ut-ras/rm_electrical-supercap/Design/MC34063 DWS.xlsx

Sheet: STEP DOWN
Design Spreadsheet for the MC33063 device in step down topology |  |  |  |  |  |  |  |  |  |  |  |  | Rev 0.1 7/22/09
 |  |  |  |  |  | Select package, demoboard: |  |  | SOIC
 |  |  |  |  | Package |  | PDIP | SOIC | DFN | Custom
 |  |  |  |  | Rthja (°C/W) |  | 107 | 123 | 47 | 90 | Related to mentioned PCB
 |  |  |  |  | Tmax (°C) |  | 150 | 150 | 150 | 150
 |  |  |  |  | Pdmax (W) |  | 0.95 | 0.625 | 1.2 | 0.625
 |  |  |  |  |  |  |  |  |  |  |  | PCB one-layer, size: 28 x 41 mm,35um copper thickness, 840 sqmm copper area
 |  |  |  |  | RESULTS:
 |  |  |  |  | Ta max : | 97.88 | °C | <-- Maximum ambient temperature
 |  |  |  |  | Pd : | 0.42 | W | <-- Power Dissipation at the device
 |  |  |  |  | The maximum ambient temperature is related to one-layer PCB with parameters mentioned in the above
 |  |  |  |  | yellow table. The value of maximum ambient temperature is calculated for maximum allowable junction
 |  |  |  |  | temperature Tj = 150°C.
1) Insert Design Parameters
 | = Input Parameter
 | = Calculated Parameter (DO NOT CHANGE)
 | = Warning
 |  | Unit |  |  |  |  |  |  |  | Scroll Bars for fast Vin and Vout setting
VIN | 24 | V | <-- Worst Case Input Voltage (usually minimum Vin) |  |  | Input Voltage: 4V < Vin < 40V
VOUT | 5 | V | <-- Desired Output Voltage |  |  | Output Voltage: 1.25V < Vout < (Vin*Dmax)
IOUT | 0.8 | A | <-- Desired Output Current
D | 24.16 | % | <-- Duty Cycle. Maximum duty cycle of the MC33063 is 84%
2) Input Conduction Loss Parameters from Free-wheeling Diode Datasheets
 |  | Unit
VF | 0.6 | V | <-- Diode Forward Voltage (Example: 1N5819 = 0.6V)
VSAT | 1.42 | V | <-- Saturation Voltage of Power Switch Transistor
 |  |  |  | - Found in Electrical Characteristics of Datasheet,
 |  |  |  | Darlington Configuration
3) Set DIL/IL(avg)
For Maximum Output Current it is suggested that ΔIL should be chosen to be less than 10% of the average inductor current, IL(avg).
This will help prevent Ipk (sw) from reaching the current limit threshold set by RSC. If the design goal is to use a minimum
inductance value, let ΔIL = 2*IL(avg). This will proportionally reduce output current capability.
 |  | Unit
DIL / IL(avg) | 36 | % | <-- DIL / IL(avg)
Iripple | 0.288 | A | <-- Ripple Current, DIL
4) Input target frequency
 |  | Unit
Target f | 80 | kHz | <-- Targeted maximum switching frequency
Timing capacitor | 120.8062957 | pF |  |  |  |  |  |  | NO
 |  |  |  |  |  |  |  |  | YES
5) The spreadsheet calculates key parameters for the remaining component selection
 |  | Unit
ton/toff | 0.32
ton | 3.02 | us
IL(avg) | 0.80 | A | <-- Average Inductor Current. For a buck converter this equals Iout
Ipk(sw) | 0.94 | A | <-- Peak Inductor Current. For a buck converter this equals Iout + Iripple/2
 |  | Unit
RSC | 317.7966102 | mOhm | <-- Minimum Short Circuit Resistor Value
L | 184.3302729 | uH | <-- Minimum inductance value |  | * increasing inductance decreases ripple current
RL | 0.708 | Ohm | <-- Inductor Widing Resistance (from Inductor data sheet or measurement).
toff | 9.48 | us
6) Efficiency / Power Loss
Pswitch, cond | 0.27 | W | <-- Conduction Loss in Power Switch
Psensing, res | 0.02 | W | <-- Conduction Loss in Sensing Resistor
Pdiode, cond | 0.36 | W | <-- Conduction Loss in Diode
Pind, winding | 0.45 | W | <-- Inductor Winding Losses
Pstatic, IC | 0.07 | W | <-- Static Power Loss in IC
Pswitch, sw | 0.08 | W | <-- Switching Losses of Power Switch
Pcore |  | W | <-- Core Loss in Inductor. Available in inductor data sheet. Leave blank if not available.
Ploss, total | 1.26 | W | <-- Total Loss
Pout | 4.00 | W | <-- Output Power
Pin | 5.26 | W | <-- Input Power = Output Power + Total Loss
Efficiency | 76.02358069 | % | <-- Efficiency of Converter (Est: +/- 5%)
Pd IC | 0.42 | W | <-- Power Dissipation

Sheet: STEP DOWN (2)
Design Spreadsheet for the MC33063 device in step down topology |  |  |  |  |  |  |  |  |  |  |  |  | Rev 0.1 7/22/09
 |  |  |  |  |  | Select package, demoboard: |  |  | SOIC
 |  |  |  |  | Package |  | PDIP | SOIC | DFN | Custom
 |  |  |  |  | Rthja (°C/W) |  | 107 | 123 | 47 | 90 | Related to mentioned PCB
 |  |  |  |  | Tmax (°C) |  | 150 | 150 | 150 | 150
 |  |  |  |  | Pdmax (W) |  | 0.95 | 0.625 | 1.2 | 0.625
 |  |  |  |  |  |  |  |  |  |  |  | PCB one-layer, size: 28 x 41 mm,35um copper thickness, 840 sqmm copper area
 |  |  |  |  | RESULTS:
 |  |  |  |  | Ta max : | 121.39 | °C | <-- Maximum ambient temperature
 |  |  |  |  | Pd : | 0.23 | W | <-- Power Dissipation at the device
 |  |  |  |  | The maximum ambient temperature is related to one-layer PCB with parameters mentioned in the above
 |  |  |  |  | yellow table. The value of maximum ambient temperature is calculated for maximum allowable junction
 |  |  |  |  | temperature Tj = 150°C.
1) Insert Design Parameters
 | = Input Parameter
 | = Calculated Parameter (DO NOT CHANGE)
 | = Warning
 |  | Unit |  |  |  |  |  |  |  | Scroll Bars for fast Vin and Vout setting
VIN | 24 | V | <-- Worst Case Input Voltage (usually minimum Vin) |  |  | Input Voltage: 4V < Vin < 40V
VOUT | 3.3 | V | <-- Desired Output Voltage |  |  | Output Voltage: 1.25V < Vout < (Vin*Dmax)
IOUT | 0.5 | A | <-- Desired Output Current
D | 16.77 | % | <-- Duty Cycle. Maximum duty cycle of the MC33063 is 84%
2) Input Conduction Loss Parameters from Free-wheeling Diode Datasheets
 |  | Unit
VF | 0.6 | V | <-- Diode Forward Voltage (Example: 1N5819 = 0.6V)
VSAT | 1.34 | V | <-- Saturation Voltage of Power Switch Transistor
 |  |  |  | - Found in Electrical Characteristics of Datasheet,
 |  |  |  | Darlington Configuration
3) Set DIL/IL(avg)
For Maximum Output Current it is suggested that ΔIL should be chosen to be less than 10% of the average inductor current, IL(avg).
This will help prevent Ipk (sw) from reaching the current limit threshold set by RSC. If the design goal is to use a minimum
inductance value, let ΔIL = 2*IL(avg). This will proportionally reduce output current capability.
 |  | Unit
DIL / IL(avg) | 36 | % | <-- DIL / IL(avg)
Iripple | 0.18 | A | <-- Ripple Current, DIL
4) Input target frequency
 |  | Unit
Target f | 80 | kHz | <-- Targeted maximum switching frequency
Timing capacitor | 83.84482258 | pF |  |  |  |  |  |  | NO
 |  |  |  |  |  |  |  |  | YES
5) The spreadsheet calculates key parameters for the remaining component selection
 |  | Unit
ton/toff | 0.20
ton | 2.10 | us
IL(avg) | 0.50 | A | <-- Average Inductor Current. For a buck converter this equals Iout
Ipk(sw) | 0.59 | A | <-- Peak Inductor Current. For a buck converter this equals Iout + Iripple/2
 |  | Unit
RSC | 508.4745763 | mOhm | <-- Minimum Short Circuit Resistor Value
L | 225.4173878 | uH | <-- Minimum inductance value |  | * increasing inductance decreases ripple current
RL | 0.708 | Ohm | <-- Inductor Widing Resistance (from Inductor data sheet or measurement).
toff | 10.40 | us
6) Efficiency / Power Loss
Pswitch, cond | 0.11 | W | <-- Conduction Loss in Power Switch
Psensing, res | 0.01 | W | <-- Conduction Loss in Sensing Resistor
Pdiode, cond | 0.25 | W | <-- Conduction Loss in Diode
Pind, winding | 0.18 | W | <-- Inductor Winding Losses
Pstatic, IC | 0.07 | W | <-- Static Power Loss in IC
Pswitch, sw | 0.05 | W | <-- Switching Losses of Power Switch
Pcore |  | W | <-- Core Loss in Inductor. Available in inductor data sheet. Leave blank if not available.
Ploss, total | 0.66 | W | <-- Total Loss
Pout | 1.65 | W | <-- Output Power
Pin | 2.31 | W | <-- Input Power = Output Power + Total Loss
Efficiency | 71.29167416 | % | <-- Efficiency of Converter (Est: +/- 5%)
Pd IC | 0.23 | W | <-- Power Dissipation

Sheet: STEP UP
Design Spreadsheet for the MC33063 device in step up topology:
 |  |  |  |  |  | Select package, demoboard: |  |  | SOIC
 |  |  |  |  | Package |  | PDIP | SOIC | DFN | Custom
 |  |  |  |  | Rthja (°C/W) |  | 107 | 123 | 47 | 90 | Related to mentioned PCB
 |  |  |  |  | Tmax (°C) |  | 150 | 150 | 150 | 150
 |  |  |  |  | Pdmax (W) |  | 0.95 | 0.625 | 1.2 | 0.625
 |  |  |  |  |  |  |  |  |  |  |  | PCB one-layer, size: 28 x 41 mm,35um copper thickness, 840 sqmm copper area
 |  |  |  |  | RESULTS:
 |  |  |  |  | Ta max : | 126.62 | °C | <-- Maximum ambient temperature
 |  |  |  |  | Pd : | 0.19 | W | <-- Power Dissipation at the device
 |  |  |  |  | The maximum ambient temperature is related to one-layer PCB with parameters mentioned below
 |  |  |  |  | yellow table. The value of maximum ambient temperature is calculated for maximum allowable junction
 |  |  |  |  | temperature Tj = 150°C.
1) Insert Design Parameters
 | = Input Parameter
 | = Calculated Parameter (DO NOT CHANGE)
 | = Warning
 |  | Unit |  |  |  |  |  |  | Scroll Bars for fast Vin and Vout setting:
VIN | 24 | V | <-- Worst Case Input Voltage (minimum Vin) |  |  | Input Voltage: 2.5V < Vin < 38V
VOUT | 30 | V | <-- Desired output voltage |  |  | Note: (Vin + 2) < Vout < 40V
IOUT | 0.3 | A | <-- Desired output current
D | 22.25969646% |  | <-- Duty Cycle. Maximum duty cycle of the MC30063 is 84%
2) Input Conduction Loss Parameters from Free-wheeling Diode Datasheets
 |  | Unit
VF | 0.6 | V | <-- Diode Forward Voltage (Example: 1N5819 = 0.6V)
VSAT | 0.9 | V | <-- Saturation Voltage of Power Switch Transistor
 |  |  |  | - Found in Electrical Characteristics of Datasheet,
 |  |  |  | Darlington Configuration
3) Set DIL/IL(avg)
For Maximum Output Current it is suggested that ΔIL should be chosen to be less than 10% of the average inductor current, IL(avg).
This will help prevent Ipk (sw) from reaching the current limit threshold set by RSC. If the design goal is to use a minimum
inductance value, let ΔIL = 2*IL(avg). This will proportionally reduce output current capability.
 |  | Unit
DIL / IL(avg) | 30 | % | <-- DIL / IL(avg)
Iripple | 0.12 | A | <-- Ripple Current, DIL
4) Input target frequency
 |  | Unit
Target f | 90 | kHz | <-- Targeted maximum switching frequency
Timing capacitor | 98.93198426 | pF | <-- Timing capacitor capacitance |  |  |  |  | NO
5) The spreadsheet calculates key parameters for the remaining component selection
 |  | Unit
ton/toff | 0.29
ton | 2.47 | us
IL(avg) | 0.39 | A | <-- Average Inductor Current.
Ipk(sw) | 0.44 | A | <-- Peak Inductor Current. For Boost Converter this equals IL(avg) + Iripple/2
 |  | Unit
RSC | 676.0026395 | mOhm | <-- Minimum Short Circuit Resistor Value
L | 493.7311248 | uH | <-- Minimum inductance value |  | - increasing inductance decreases ripple current
RL | 2.000 | Ohm | <-- Inductor Widing Resistance (from Inductor data sheet or measurement).
toff | 8.64 | us
6) Efficiency / Power Loss
Pswitch, cond | 0.08 | W | <-- Conduction Loss in Power Switch
Psensing, res | 0.10 | W | <-- Conduction Loss in Sensing Resistor
Pdiode, cond | 0.18 | W | <-- Conduction Loss in Diode
Pind, winding | 0.30 | W | <-- Inductor Winding Losses
Pstatic, IC | 0.07 | W | <-- Static Power Loss in IC
Pswitch, sw | 0.04 | W | <-- Switching Losses of Power Switch
Pcore |  | W | <-- Core Loss in Inductor. Available in inductor data sheet. Leave blank if not available.
Ploss, total | 0.77 | W | <-- Total Loss
Pout | 9.00 | W | <-- Output Power
Pin | 9.77 | W | <-- Input Power = Output Power + Total Loss
Efficiency | 92.13 | % | <-- Efficiency of Converter (Est: +/- 5%)
Pd IC | 0.19
