ut-ras/rm_electrical-supercap/Design/TPS4306x_BOOST_CALCTOOL_REVB.xlsx

Sheet: Intro
 |  | © 2012
TPS4306x Boost Design Calculator
TPS4306x Boost Design Calculator Tool - Rev. B
This tool supports the TPS4306x datasheet (SLVSBP4) (http://www.ti.com/lit/ds/symlink/tps43061.pdf)
This worksheet is designed for use with Microsoft Excel 2002 or later. It is intended to assist circuit designers in their
routine, day-to-day calculations. Additional worksheets may be added as they are completed.
The calculator includes boost power stage design in CCM using the TPS43061EVM-198 design requirements as the original input.
The calculator provides the small signal gain and phase for the final design. The small signal model currently supports CCM only.
Important: Analysis Toolpak is needed to run small signal worksheet. Go to Tools>Add-Ins> select Analysis Toolpak
All worksheets contain yellow user-input cells, blue calculated cells, and grey constants cells.
Leave the password blank to unlock the individual sheets or workbook.
 | Disclaimer:
 | This product is designed as an aid for customers of Texas Instruments. No warranties, either express
 | or implied, with respect to this software or its fitness for any particular purpose is made by Texas
 | Instruments or the author. The software is licensed solely on an "as is" basis. The entire risk as to its
 | quality and performance is with the user.
Revision notes
Rev. B
fixed typos in equations on the Boost Calculations tab in row 68, 69 and 74

Sheet: Boost Calculations
TPS4306x Boost Equation Set from Datasheet |  |  |  | Cell Color Key
Devices Supported |  | Select Device |  | User Input
TPS43060 |  | TPS43061 |  | Calculated
TPS43061 |  |  |  | Constants
DS Equation # | Design Specifications | Value | Units | Description/Comments
 | Vin nom | 4.56 | V | Nominal input voltage
 | Vin min | 4.4 | V | Minimum input voltage
 | Vin max | 6 | V | Maximum input voltage
 | Viripple | 0.0456 | V p-p | Input voltage ripple (1% Vin nom)
 | Vout | 24.0 | V | Output voltage
 | Vripple | 0.24 | V p-p | Output voltage ripple (1% Vout)
 | Iout | 3.750 | A | Maximum Average Output current
 | fsw | 750 | kHz | Switching frequency
 | dItran | 1.875 | A | Load transient output current change (50% Iout default)
 | dVtran | 0.96 | V | Load transient output voltage change (4% Vout default)
 | Vstart | 4.8 | V | Optional adjustable UVLO turn on voltage
 | Vstop | 4.5 | V | Optional adjustable UVLO turn off voltage
Schematic and Final Component List
Ref. Des. | EVM Ref. Des. | Values and Minimum Recommended Ratings
CI | C13-C15 (C16) | 220.0 µF | 6V | Irms = 1.064A
CC | C9 | 0.010 µF | 3.6V
CSS | C7 | 0.100 µF | 3.6V
CHF | C8 | 180 pF | 3.6V
CBOOT | C1 | 0.100 µF | 5.5V
CVCC | C6 | 5.600 µF | 5.5V
CO | C2-C5, C16 (C17) | 220.0 µF, 0.018Ω | 24V | Irms = 7.915A
DBOOT | D1 | n/a | 24V
L | L1 | 1.3 µH | Isat = 26.757A | Irms = 20.457A
QL | Q1 | BSC059N04LS6
QH | Q1 (Q2) | BSC059N04LS6
RSENSE | R16-R17 (R18) | 0.002 Ω | 3.502W
RUVLOH | R7 | 6.81 kΩ
RUVLOL | R5 | 2.26 kΩ
RC | R7 | 22.6 kΩ
RT | R5 | 76.8 kΩ
RSL | R8 | 11 kΩ
RSH | R9 | 205 kΩ
RPG | R1 | 100 kΩ
DS Equation # | Power Stage Design | Value |  |  | Units | Description/Comments
Duty Cycle
 | Dmax off time, Dmin on time | 81.25% | 7.5% |  |  | Estimated duty cycle limits based on minimum on time and off time (assumes 100% efficiency)
11 | Dnom | 81% |  |  |  | Duty cycle at nominal input voltage
11 | Dmax | 81.66666667% |  |  |  | Duty cycle at minimum input voltage
11 | Dmin | 75% |  |  |  | Duty cycle at maximum input voltage
12,13 | fsw max | 7500000 | 733333.3333 |  | Hz | Minimum and maximum switching frequency based on duty cycle estimations
14 | RT calc | 76666.66667 | 76800 |  | Ω | Calculated and nearest 1% STD value fsw set resistor
 | RT chosen | 76800 |  |  | Ω | Chosen fsw set resistor
Inductor Selection (L)
15 | Iin max | 20.45454545 |  |  | A | Maximum average input current (assumes 100% efficiency)
 | Kind | 0.3 |  |  |  | Inductor current ripple fraction (typical values 0.2 to 0.4)
 | Iripple target | 6.136363636 |  |  | A | Inductor current ripple target based on Kind and average current with minimum input voltage
17 | L min1 | 9.777777778e-07 |  |  | H | Minimum inductance calculated based on Iripple target (Vin_max)
17 | L min2 | 7.807736626e-07 |  |  | H | Minimum inductance calculated based on Iripple target (Vin_min)
16 | L min3 | n/a |  |  | H | Minimum inductance calculated based on Iripple target (50% duty cycle)
 | L chosen | 1.3e-06 |  |  | H | Selected inductance
 | DCR | 0.004 |  |  | Ω | DC resistance (DCR) of selected inductor
 | Iripple | 3.685 | 3.788 | 4.615 | A | Inductor ripple with selected inductance (Vin_min, Vin_nom, Vin_max)
48 | Icrit | 0.338 | 0.360 | 0.577 | A | Estimated critical output current to remain in CCM (Vin_min, Vin_nom, Vin_max)
 | Ipsm | 0.003 | 0.003 | 0.006 | A | Estimated output current when pulse skipping begins (Vin_min, Vin_nom, Vin_max)
18 | IL rms | 20.457 | 19.739 | 15.005 | A | Inductor RMS current (Vin_min)
19 | IL peak, Isat | 22.297 | 26.757 |  | A | Peak current and +20% for recommended minimum inductor saturation current rating
 | PL cond | 1.674 | 1.559 | 0.901 | W | Full load conduction losses in inductor (Vin_min, Vin_nom, Vin_max)
Sense Resistor (RSENSE)
20 | Vcs typ | 0.064 | 0.064 | 0.066 | V | Typical over-current current sense voltage based on Figure 19 in datasheet
 | Vcs min | 0.052 | 0.052 | 0.056 | V | Minimum over-current current sense voltage (10 mV below typical)
21 | Rsense max | 0.001951421336 |  |  | Ω | Maximum current sense resistor using Vcs min and 20% tolerance to account for efficiency and transients
 | Rsense chosen | 0.00192 |  |  | Ω | Selected sense resistor
22 | P Rsense | 3.502 |  |  | W | Minimum power rating for current sense resistor in normal operating conditions
 | Ilim min | 27.195 | 27.242 | 29.013 | A | Minimum current limit with selected sense resistor
 | Ilim typ | 33.460 | 33.538 | 34.221 | A | Typical current limit with selected sense resistor
 | Estimated Efficiency | 93% | 96% | 97% |  | Estimated Efficiency
 | Iout max | 4.322 | 4.623 | 6.476 | A | Maximum output current using minimum over-current sense voltage
 | Iout max | 5.391 | 5.772 | 7.739 | A | Maximum output current with typical over-current sense voltage
Output Capacitor (CO)
24 | Cout min ripple | 1.701388889e-05 |  |  | F | Minimum Cout for output voltage ripple specification
23 | Cout min transient | 4.721397211e-05 |  |  | F | Minimum Cout for load transient output voltage change specification (uses fco_target from compensation section)
 | Cout ESR max | 0.012 |  |  | Ω | Estimated maximum Cout ESR to meet ripple specification
 | Cout chosen | 0.00022 |  |  | F | Output capacitance selected (remember to include derating for ceramics)
 | ESR chosen | 0.018 |  |  | Ω | ESR selected (if mixed output capacitors are used, use equivalent ESR of the non ceramic capacitors)
 | Irms_cout | 7.915 |  |  | A | Output capacitors must be rated to handle RMS current (Vin_min)
Low-side Boost FET (QL)
 | Selected FET | BSC059N04LS6 |  |  |  | Input part number for selected low-side FET
 | Qg ls | 9.4e-09 |  |  | C | Gate charge of selected FET
 | Idrive | 0.007 |  |  | A | Average gate drive current required
 | Rdson ls | 0.0059 |  |  | Ω | Rdson of selected FET
26 | Pls cond | 2.000 |  |  | W | Estimated full load conduction losses in FET (Vin_min)
 | Vth | 1.8 |  |  | V | Threshold Voltage
 | Coss | 2.1e-10 |  |  | F | Output Capacitance
 | Qgd | 1.4e-09 |  |  | C | Gate to dran charge
 | Rg ls | 2.2 |  |  | Ω | Gate resistance of selected FET
27 | Pls sw | 0.199 |  |  | W | Estimated switching losses
 | Ptot ls | 2.199 |  |  | W | Estimated losses in low-side FET (Vin_min)
High-side Synchronous FET (QH, CBOOT)
 | Selected FET | BSC059N04LS6 |  |  |  | Input part number for selected high-side FET
 | Qg hs | 9.4e-09 |  |  | C | Gate charge of selected FET
 | Idrive | 0.007 |  |  | A | Average gate drive current required
30 | Cboot | 3.76e-08 | 3.3e-08 |  | F | Minimum bootstrap capacitor
 | Cboot | 1e-07 |  |  | F | Selected bootstrap capacitor
 | Rdson hs | 0.0059 |  |  | Ω | Rdson of selected FET
28 | Phs cond | 0.453 |  |  | W | Estimated max load conduction losses in FET (Vin_min)
 | Rg hs | 2.2 |  |  | Ω | Gate resistance of selected FET
 | Vf body | 0.92 |  |  | V | Forward voltage of body diode
29 | Phs dt | 1.835 |  |  | W | Estimated max load dead time losses in FET (Vin_min)
 | Ptot hs | 2.288 |  |  | W | Estimated losses in high-side FET (Vin_min)
IC (CVCC, DBOOT)
25 | Idrive | 0.014 |  |  | A | Total required gate drive current (must be less than 50mA Vcc minimum current limit)
 | CVcc | 5.6e-06 |  |  | F | Input selected VCC capacitor (0.47 µF to 10 µF recommended)
 | Selected Dboot | n/a |  |  |  | Input part number for selected external boot diode (TPS43060 only)
 | Vfboot | 0.75 |  |  | V | Forward voltage of internal or external boot diode
 | PIC gate drive | 0.03976311783 |  |  | W | Estimated gate drive power loss in IC including gate drive series resistance and gate resistance of FETs
 | PIC VCC | 0.00705 |  |  | W | Estimated power loss in internal VCC regulator
 | PIC Iq | 0.002736 |  |  | W | Quiescent current power loss in IC
Input Capacitor (CI)
31 | Effective Cin min | 2.69405708e-05 |  |  | V | Minimum Cin for input voltage ripple specification
 | Chosen Cin | 0.00022 |  |  | F | Input capacitance selected (remember to include derating for ceramics)
32 | Irms_cin | 1.064 |  |  | A | Input capacitors must be rated to handle RMS current
DS Equation # | Feature Components | Value |  |  | Units | Description/Comments
Output Voltage (RSL, RSH)
 | RLS chosen | 11000 |  |  | Ω | Bottom resistor for feedback voltage divider
33 | RHS calc | 205393.4426 | 205000 |  | Ω | Calculated and nearest 1% STD value top resistor for feedback voltage divider
 | RHS chosen | 205000 |  |  | Ω | Chosen top resistor in feedback voltage divider
Soft-start (CSS)
 | tss | 0.025 |  |  | sec | Soft-start time
34 | Css calc | 1.024590164e-07 | 1e-07 |  | F | Calculated and nearest standard value soft-start capacitor
 | Css chosen | 1e-07 |  |  | F | Chosen soft-start capacitor
Adjustable UVLO (RUVLO_H, RUVLO_L)
35 | Ruvloh calc | 6753.376688 | 6810 |  | Ω | Calculated and nearest 1% STD value top resistor for UVLO divider
 | Ruvloh chosen | 6810 |  |  | Ω | Chosen top UVLO resistor
36 | Ruvlol calc | 2287.353657 | 2260 |  | Ω | Calculated and nearest 1% STD value bottom resistor for UVLO divider
 | Ruvlol chosen | 2260 |  |  | Ω | Chosen bottom UVLO resistor
 | Vstart | 4.84 |  |  | V | Calculated turn on voltage with selected resistors
 | Vstop | 4.54 |  |  | V | Calculated turn off voltage with selected resistors
Power Good Resistor (RPG)
 | RPG chosen | 100000 |  |  | Ω | Input selected value for optional power good pull up resistor (between 10k and 100k recommended)
DS Equation # | Compensation Design | Value |  |  | Units | Description/Comments
Power Stage
 | Ro | 6.4 |  |  | Ω | Equivalent output resistance
37 | DC Gain | 27.2 | 22.9 |  | dB | DC gain of power stage
38 | fp_mod | 226.0723623 |  |  | Hz | Pole of power stage
39 | frhpz_mod | 26335.38204 |  |  | Hz | Right half plane zero (RHPZ) of power stage
40 | fzesr_mod | 40190.64219 |  |  | Hz | ESR zero of output capacitor
Compensation (RC, CC, CHF)
41 | fco1 | 6583.845509 |  |  | Hz | Recommended maximum target crossover frequency (frhpz)
42 | fco2 | 150000 |  |  | Hz | Recommended maximum target crossover frequency (fsw)
 | fco_target | 6583.845509 |  |  | Hz | Target crossover frequency
 | KPS_fco | -3.09 |  |  | dB | Modelled power stage gain at targeted fco
 | KPS_fco | -3.09 |  |  | dB | Input power stage gain at targeted fco to calculate compensation components
43 | RCOMP calc | 22685.53846 | 22600 |  | Ω | Calculated and nearest 1% STD value compensation resistor based on estimation in data sheet
 | RCOMP calc | 25491.18673 | 25500 |  | Ω | Calculated and nearest 1% STD value compensation resistor based on small signal model in excel
 | RCOMP | 22600 |  |  | Ω | Chosen compensation resistor
44 | CCOMP calc | 1.069626271e-08 | 1e-08 |  | F | Calculated and nearest STD value compensation capacitor
 | CCOMP | 1e-08 |  |  | F | Chosen compensation capacitor
46 | CHF calc | 1.069626271e-10 | 1e-10 |  | F | Calculated and nearest STD value high frequency roll off cap based on fco_target
45 | CHF calc ESR | 1.752212389e-10 | 1.8e-10 |  | F | Calculated and nearest STD value high frequency roll off cap based on ESR zero of output capacitor
 | CHF | 1.8e-10 |  |  |  | Chosen CHF (1E-12 is open)
 | FP | 1.591549431 |  |  | Hz | Pole from Rea and CCOMP
 | FZ | 704.2254119 |  |  | Hz | Zero from RCOMP and CCOMP
 | FP2 | 39123.634 |  |  | Hz | Pole from RCOMP and CHF
See Small Signal sheet for gain and phase graphs
Device Constants |  | Value |  |  | Units | Description/Comments
 |  | MIN | TYP | MAX
 | Vout | Vin |  | 58 | V | Output Voltage
 | Vin | 4.5 |  | 38 | V | Input voltage
 | fsw | 50000 |  | 1200000 | Hz | Switching frequency
 | Gea |  | 0.0011 |  | A/V | Transconductance of error amplifier
 | Rea |  | 10000000 |  | Ω | Output resistance of error amplifier
 | Vref |  | 1.22 |  | V | Reference voltage
 | tonmin |  | 1e-07 |  | sec | Minimum on time
 | toffmin |  | 2.5e-07 |  | sec | Minimum off time
 | Vcsmax (0% duty cycle) | 0.064 | 0.073 | 0.082 | V | Current sense threshold 0% to 40% duty cycle
 | Vcsmax (max duty cycle) | 0.051 | 0.061 | 0.072 | V | Current sense threshold max duty cycle
 | Vcc |  | 5.5 |  | V | Internal regulator voltage
 | Vfboot |  | 0.750 |  | V | Internal boot diode forward voltage
 | tnonoverlap |  | 6.5e-08 |  | sec | Time delay between DRV signals
 | Rldrv pu |  | 2.5 |  | Ω | LDRV pull-up resistance
 | Rldrv pd |  | 1.6 |  | Ω | LDRV pull-down resistance
 | Rhdrv pu |  | 5.0 |  | Ω | HDRV pull-up resistance
 | Rhdrv pd |  | 3.0 |  | Ω | HDRV pull-down resistance
 | Ven on |  | 1.21 |  | V | EN rising threshold
 | Ven dis |  | 1.14 |  | V | EN falling threshold
 | Ien pup |  | 1.8e-06 |  | sec | EN pull up current source
 | Ien hys |  | 3.2e-06 |  | sec | EN hysteresis current source
 | Iq |  | 0.0006 |  | A | Operationg non switching quiescent current
 | Iss |  | 5e-06 |  | A | Soft-start current source

Sheet: Small Signal
Values from Calculations |  |  | Values for Plotting
Vin min | 4.4 | V | Vin | 4.4 | V |  |  | Frequency | Radians |  | ABS(Gvc Phase) | ABS(Total Phase) | ABS(Total Gain) | Frequency | Zon(s) | Zc(s) | Zoff(s) | Gvd_CCM(s) | Gain Gvd CCM | Phase Gvd CCM | He(s) | Gid(s) | Ti(s) | Gvc(s) | Gain Gvc CCM | Phase Gvc CCM | Gain Gea | Phase Gea | Total Gain | Total Phase | Gea(s)
Vin nom | 4.56 | V |  |  |  | 0 | 1 | 10 | 62.83185307 | 6573.618465 | 98.99126687 | 97.33322847 | 64.27974491 | 10 | 0.0355+0.0000816814089933346i | 0.018-72.3431559508615i | 6.35016206857816-0.561768969323637i | 93.8079225805049-1.2488487609539i | 39.44556001 | -0.7627238142 | 0.999999999288889-7.20506400999717E-06i | 191.616102773791+6.00856712435232i | 35.1568582946475+1.1021712392259i | 18.5697979487349-0.813610744743781i | 25.38447245 | -2.508733126 | 38.89527246 | 99.8419616 | 64.27974491 | 97.33322847 | 15.0516738319181-86.7610107465018i | 0.0179999998570247-72.3431556220285i
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
 |  |  |  |  |  | 184 | 2.794022545 | 622.3325906 | 3910.23099 | 5947.383233 | 30.95884481 | 60.16148025 | 21.80261455 | 622.3325906 | 0.0355+0.00508330028643772i | 0.018-1.16245167039539i | 0.2206673528178-1.11922336516761i | 56.6561972836625-53.3940690796456i | 37.82533629 | -43.30212619 | 0.999997245881932-0.000448394615093007i | 414.452012962508+216.397989532243i | 76.0593624229683+39.66951209332i | 2.14459691788648-6.07000771664796i | 16.174647 | -70.54115519 | 5.627967555 | 130.7026354 | 21.80261455 | 60.16148025 | 1.24662186075007-1.44919678229175i
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
