ut-ras/rm_electrical-supercap/Design/5V_housekeeping/WBDesign7_Steady State-3.pdf

## WEBENCH ® Design Report

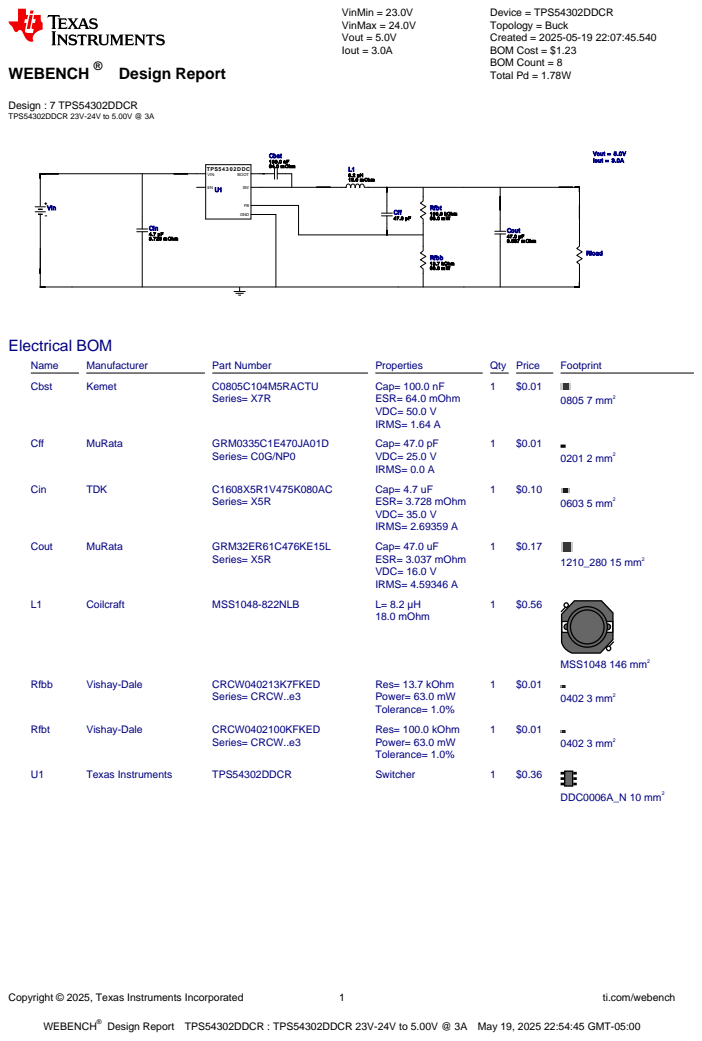
[picture p13: page 1]
Copyright © 2025, Texas Instruments Incorporated; ti.com/webench; WEBENCH®; Design : 7 TPS54302DDCR TPS54302DDCR 23V-24V to 5.00V @ 3A; VinMin = 23.0V VinMax = 24.0V Vout = 5.0V Iout = 3.0A; Device = TPS54302DDCR Topology = Buck Created = 2025-05-19 22:07:45.540 BOM Cost = $1.23 BOM Count = 8 Total Pd = 1.78W; TPS5 4 3 0 2 DDC; GND; VIN; BOOT; Cin 4.7 µF 3.728 m Ohm; L1 8.2 µH 18.0 m Ohm; Rfbb 13.7 kOhm 63.0 m W; Cbst 100.0 nF; 64.0 m Ohm; Cout 47.0 µF; 3.037 m Ohm; Rfbt 100.0 kOhm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

Design Report TPS54302DDCR : TPS54302DDCR 23V-24V to 5.00V @ 3A May 19, 2025 22:54:45 GMT-05:00

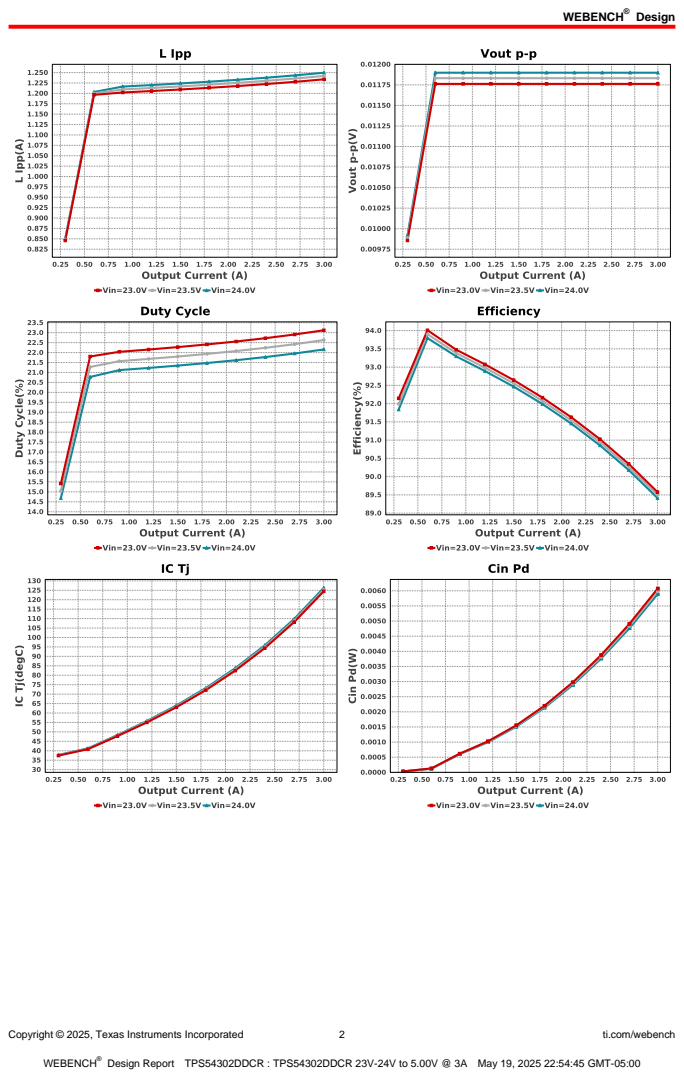
[picture p14: page 2]
Design; Copyright © 2025, Texas Instruments Incorporated; ti.com/webench

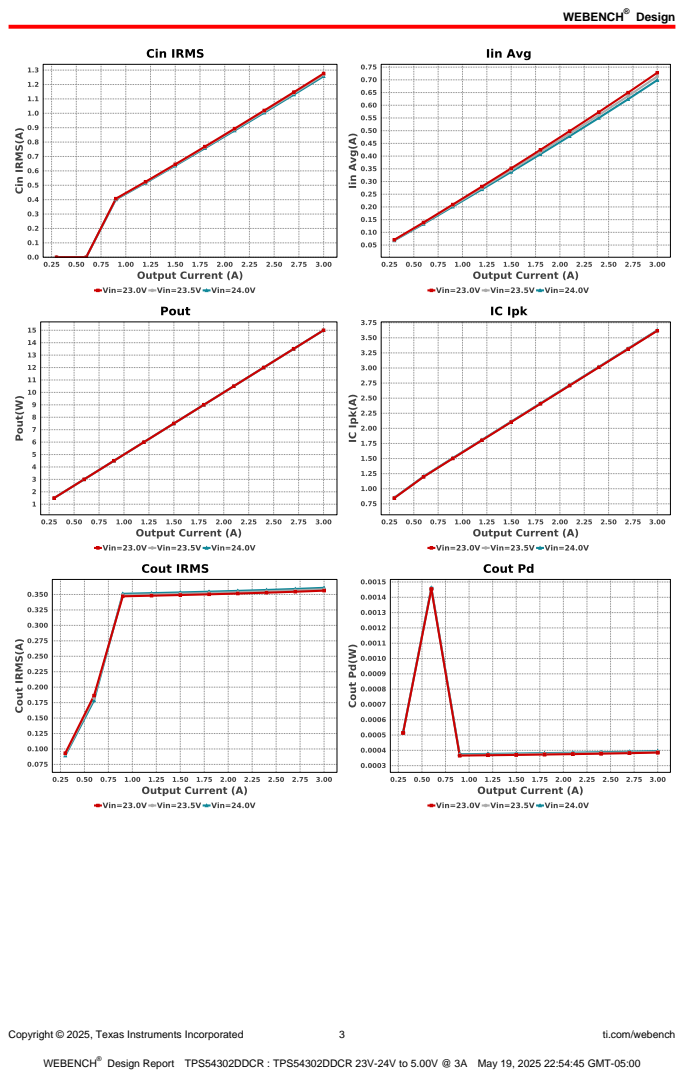
[picture p15: page 3]
Copyright © 2025, Texas Instruments Incorporated; ti.com/webench

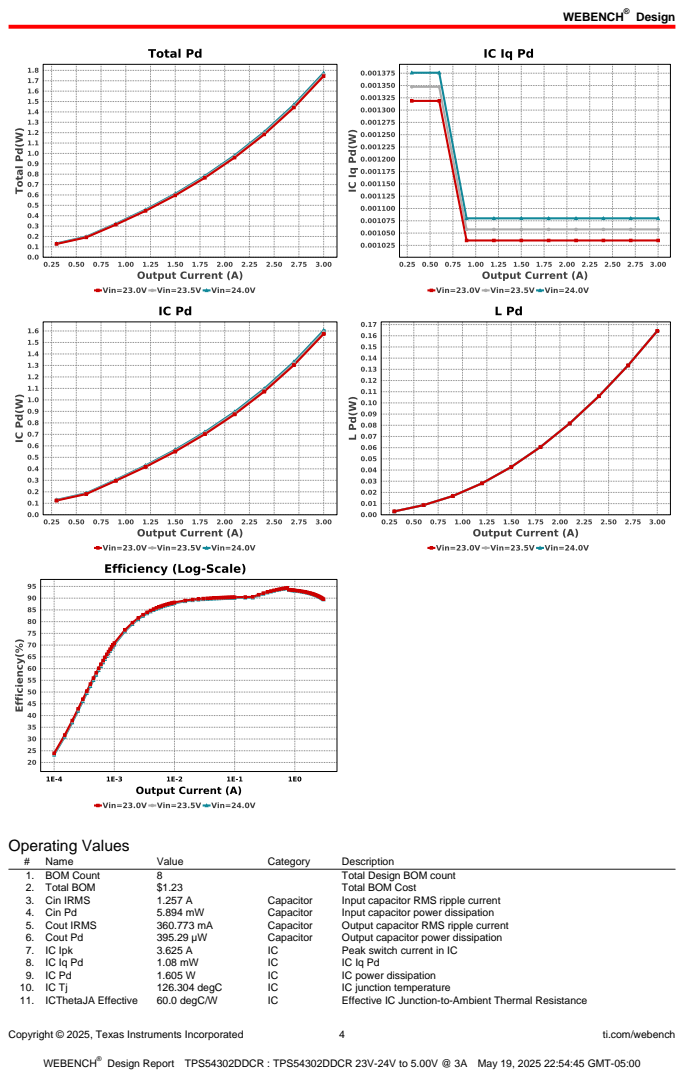
[picture p16: page 4]
Copyright © 2025, Texas Instruments Incorporated; ti.com/webench; Operating Values; Name; Value; Category; Description; 1. BOM Count; Total Design BOM count; 2. Total BOM; Total BOM Cost; 3. Cin IRMS; Capacitor; Input capacitor RMS ripple current; 4. Cin Pd; Input capacitor power dissipation; 5. Cout IRMS; Output capacitor RMS ripple current; 6. Cout Pd; Output capacitor power dissipation; 7. IC Ipk; Peak switch current in IC; IC power dissipation; 126.304 degC; IC junction temperature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

Copyright © 2025, Texas Instruments Incorporated | 5 | ti.com/webench
# | Name | Value | Category | Description

12. Iin Avg | 699.0 mA | IC | Average input current
13. L Ipp | 1.25 A | Inductor | Peak-to-peak inductor ripple current
14. L Pd | 164.34 mW | Inductor | Inductor power dissipation
15. Cin Pd | 5.894 mW | Power | Input capacitor power dissipation
16. Cout Pd | 395.29 µW | Power | Output capacitor power dissipation
17. IC Pd | 1.605 W | Power | IC power dissipation
18. L Pd | 164.34 mW | Power | Inductor power dissipation
19. Total Pd | 1.776 W | Power | Total Power Dissipation
20. Duty Cycle | 22.156 % | System
| | | Information | Duty cycle
21. Efficiency | 89.414 % | System
| | | Information | Steady state efficiency
22. FootPrint | 191.0 mm² | System
| | | Information | Total Foot Print Area of BOM components
23. Frequency | 400.0 kHz | System
| | | Information | Switching frequency
24. Iout | 3.0 A | System
| | | Information | Iout operating point
25. Mode | CCM | System
| | | Information | PWM/PFM Mode
26. Pout | 15.0 W | System
| | | Information | Total output power
27. Vin | 24.0 V | System
| | | Information | Vin operating point
28. Vout Actual | 4.946 V | System
| | | Information | Vout Actual calculated based on selected voltage divider resistors
29. Vout Tolerance | 1.777 % | System
| | | Information | Vout Tolerance based on IC Tolerance (no load) and voltage divider resistors if applicable
30. Vout p-p | 11.898 mV | System
| | | Information | Peak-to-peak output ripple voltage

## Design Inputs

Name | Value | Description
Iout | 3.0 | Maximum Output Current
VinMax | 24.0 | Maximum input voltage
VinMin | 23.0 | Minimum input voltage
Vout | 5.0 | Output Voltage
| base_pn | | TPS54302 | Base Product Number
source | DC | Input Source Type
Ta | 30.0 | Ambient temperature


Copyright © 2025, Texas Instruments Incorporated | 6 | ti.com/webench

## Assembly

## Component Testing

Some published data on components in datasheets such as Capacitor ESR and Inductor DC resistance is based on conservative values that will guarantee that the components always exceed the specification. For design purposes it is usually better to work with typical values. Since this data is not always available it is a good practice to measure the Capacitance and ESR values of Cin and Cout, and the inductance and DC resistance of L1 before assembly of the board. Any large discrepancies in values should be electrically simulated in WEBENCH to check for instabilities and thermally simulated in WebTHERM to make sure critical temperatures are not exceeded.

## Soldering Component to Board

If board assembly is done in house it is best to tack down one terminal of a component on the board then solder the other terminal. For surface mount parts with large tabs, such as the DPAK, the tab on the back of the package should be pre-tinned with solder, then tacked into place by one of the pins. To solder the tab town to the board place the iron down on the board while resting against the tab, heating both surfaces simultaneously. Apply light pressure to the top of the plastic case until the solder flows around the part and the part is flush with the PCB. If the solder is not flowing around the board you may need a higher wattage iron (generally 25W to 30W is enough).

## Initial Startup of Circuit

It is best to initially power up the board by setting the input supply voltage to the lowest operating input voltage 23.0V and set the input supply's current limit to zero. With the input supply off connect up the input supply to Vin and GND. Connect a digital volt meter and a load if needed to set the minimum Iout of the design from Vout and GND. Turn on the input supply and slowly turn up the current limit on the input supply.
If the voltage starts to rise on the input supply continue increasing the input supply current limit while watching the output voltage. If the current increases on the input supply, but the voltage remains near zero, then there may be a short or a component misplaced on the board. Power down the board and visually inspect for solder bridges and recheck the diode and capacitor polarities. Once the power supply circuit is operational then more extensive testing may include full load testing, transient load and line tests to compare with simulation results.

## Load Testing

The setup is the same as the initial startup, except that an additional digital voltmeter is connected between Vin and GND, a load is connected between Vout and GND and a current meter is connected in series between Vout and the load. The load must be able to handle at least rated output power + 50% ( 7.5 watts for this design). Ideally the load is supplied in the form of a variable load test unit. It can also be done in the form of suitably large power resistors. When using an oscilloscope to measure waveforms on the prototype board, the ground leads of the oscilloscope probes should be as short as possible and the area of the loop formed by the ground lead should be kept to a minimum. This will help reduce ground lead inductance and eliminate EMI noise that is not actually present in the circuit.

## WEBENCH® Electrical Simulation Report

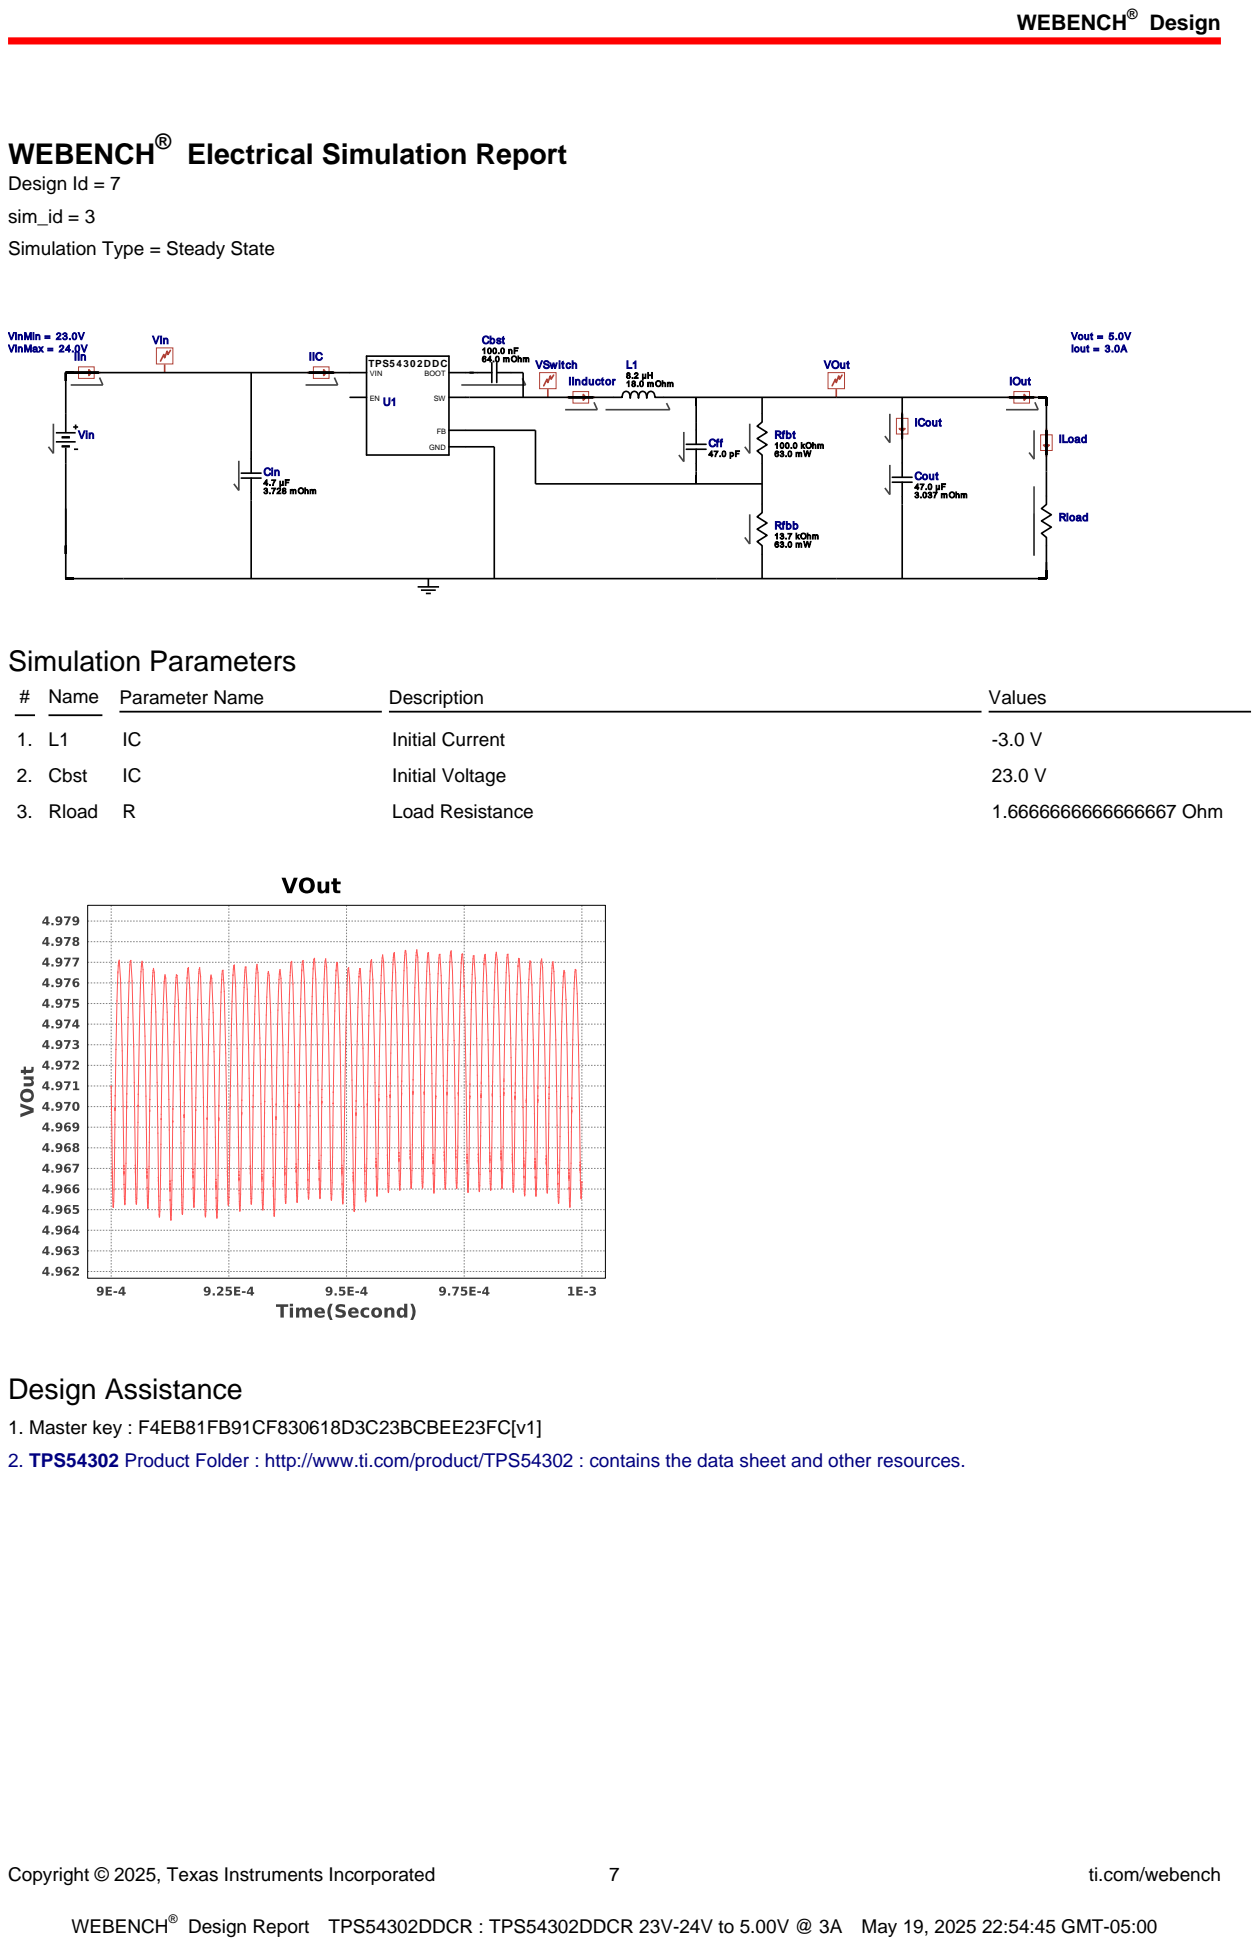
[picture p17: page 7]
Copyright © 2025, Texas Instruments Incorporated; ti.com/webench; TPS5 4 3 0 2 DDC; GND; VIN; BOOT; VinMin = 23.0V; VinMax = 24.0V; VIn; VSwitch; Cin 4.7 µF 3.728 m Ohm; IIC; IInductor; L1 8.2 µH 18.0 m Ohm; Rfbb 13.7 kOhm 63.0 m W; Cbst 100.0 nF; 64.0 m Ohm; Cout 47.0 µF; 3.037 m Ohm; ICout; IIn; IOut; Rfbt 100.0 kOhm; Vout = 5.0V Iout = 3.0A; VOut; Cff 47.0 pF; Vin; ILoad; Rload; Simulation Parameters; # Name Parameter Name; Description; Values; Initial Current; 2. Cbst; Initial Voltage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

Design Id = 7
sim_id = 3
Simulation Type = Steady State

1. Master key : F4EB81FB91CF830618D3C23BCBEE23FC[v1]
2. TPS54302 Product Folder : http://www.ti.com/product/TPS54302 : contains the data sheet and other resources.

Copyright © 2025, Texas Instruments Incorporated | 8 | ti.com/webench

Important Notice and Disclaimer

TI provides technical and reliability data (including datasheets), design resources (including reference designs), application or other design advice, web tools, safety information, and other resources AS IS and with all faults, and disclaims all warranties. These resources are intended for skilled developers designing with TI products. You are solely responsible for (1) selecting the appropriate TI products for your application, (2) designing, validating and testing your application, and (3) ensuring your application meets applicable standards, and any other safety, security, or other requirements.

These resources are subject to change without notice. TI grants you permission to use these resources only for development of an application that uses the TI products described in the resource. Other reproduction and display of these resources is prohibited. No license is granted to any other TI intellectual property right or to any third party intellectual property right. TI disclaims responsibility for, and you will fully indemnify TI and its representatives against, any claims, damages, costs, losses, and liabilities arising out of your use of these resources.

Providing these resources does not expand or otherwise alter TI's applicable Terms of Sale or other applicable terms available either on ti.com or provided in conjunction with TI products.
