ut-ras/rm_electrical-supercap/SPICE_sims/INA280A1_test.asc

U1: INA280A1
V1: voltage; 0.1
V2: voltage; 24
Named nets: 0, VS, OUT
.dc V1 0 1.2 0.05
