ut-ras/rm_electrical-supercap/SPICE_sims/5V.asc

C1: cap; 0.1µ
C2: cap; 47p
C3: cap; 47µ; Rser=1m
L1: ind; 10µ; Ipk=5.5 Rser=0.068
R1: res; 100k
R2: res; 13.7k
R3: res; 20
U1: TPS54302_TRANS
V1: voltage; 24
Named nets: 0, SW, FB, OUT, IN
.tran 10m
LOAD
