ut-ras/rm_electrical-supercap/SPICE_sims/Housekeeping Power.asc

C1: cap; 0.01µ
C2: cap; 100p
C3: polcap; 40µ; Rser=2m
D1: schottky; BAT54
I1: current; 16m
L1: ind; 220µ; Rser=2
R1: res; 1
R2: res; 22k
R3: res; 22k
R4: res; 1k
R5: res; 180
U2: MC33063A-Q1_TRANS
V1: voltage; 24
Named nets: 0, 24pc, FB, OUT, +, -
Vin
.tran 0 15m 0 1m
