ut-ras/rm_electrical-supercap/SPICE_sims/load_sharing.asc

C1: cap; {1/(A*R*wc)}
C3: cap; {1/(A*R*wc)}
I1: load; PWL(0 0 {simtime/10} 0 {simtime/10+1u} {Imax})
M1: nmos; BSC059N04LS6
M2: nmos; BSC059N04LS6
R1: res; 24k
R3: res; 20m
R6: res; {R}
R7: res; {A*R}
R8: res; {R}
R10: res; {R}
R11: res; {A*R}
R12: res; {R}
R13: res; {A*R}
R14: res; {A*R}
U1: MAX4073T
U2: OPA551
U3: OPA551
U4: TLV9302
V1: voltage; 24
V2: voltage; 24
V3: voltage; {VCC}
V4: voltage; 5
V5: voltage; 1
V8: voltage; 0
Named nets: 0, IN, SPLIT, GATE, CAP, VCC, GATEC, VEE, CURR_LIMIT, CURR, +, -, OUT, CURR_RAW, 5V, PREGATEC
.op
.tran 0 {simtime} 0
.ac dec 20 0.01 10G
.param simtime=250u
;.step dec param Imax 1 10 20
.param Imax=2.5
;.step dec param simtime 100m 10m 7
.param A=1000 wc=100k R=1000
;.step dec param A 1k 10k 4
;.param A=10 wc=1 R=1k
;.step param VCC 30 40 2
.param VCC=30
;.options abstol=1n reltol=0.001
