ut-ras/rm_electrical-supercap/SPICE_sims/load_sharing_ac.asc

C1: cap; {1/(A*R*wc)}
C5: cap; {1/(A*R*wc)}
I2: load; 2.5; AC 1
M1: nmos; BSC059N04LS
M2: nmos; BSC059N04LS
R1: res; 100k; tol=5
R2: res; 20m
R11: res; {R}
R12: res; {A*R}
R13: res; {R}
R14: res; {R}
R15: res; {A*R}
R16: res; {R}
R17: res; {A*R}
R18: res; {A*R}
U1: INA138
U2: UniversalOpAmp2
U5: OPA551
U6: OPA551
V1: voltage; 24
V2: voltage; 24
V3: voltage; 1
V4: voltage; 30
V5: voltage; 0
V6: voltage; 25.885086
V7: voltage; 1.3428587
V8: voltage; 24
Named nets: 0, CURR, IN, SPLIT, OUT, GATE, CURR_LIMIT, CAP, VCC, GATEC, VEE, 24V, CURR_B, GATEC_R, GATE_R, +, -
.op
.tran 0 {simtime} {simtime/10}
.ac dec 20 0.01 10Meg
.param simtime=10m
;.param A=1000 wc=10k R=2.5k
.param A=1000 wc=2.5k R=1000
;.step dec param wc 2.5k 2.5Meg 2
