ut-ras/rm_electrical-supercap/SPICE_sims/load_sharing_currloop.asc

C1: cap; {1/(A*R*wc)}
C2: cap; {1/(A*R*wc)}
D1: diode; BAT54
D2: diode; BAT54
I1: load; 2.5; AC 2.5
M1: nmos; BSC059N04LS
M2: nmos; BSC059N04LS
R1: res; 100k; tol=5
R2: res; 20m
R3: res; {R}
R4: res; {A*R}
R5: res; {R}
R6: res; {R}
R7: res; {A*R}
R8: res; {R}
R9: res; {A*R}
R10: res; {A*R}
R11: res; 100
R12: res; 100
U1: INA138
U2: OPA551
U3: OPA551
V1: voltage; 24
V2: voltage; 24
V3: voltage; 1
V4: voltage; 30
V5: voltage; 0
V6: voltage; 24
V7: voltage; 5
V9: voltage; 1; AC 1
Named nets: 0, CURR, IN, SPLIT, OUT, GATE, CURR_LIMIT, CAP, VCC, GATEC, VEE, 24V, CURR_B, +, -, 5V
.op
.tran 0 {simtime} {simtime/10}
.ac dec 20 0.01 10Meg
.param simtime=10m
;.param A=1000 wc=10k R=2.5k
.param A=1000 wc=2.5k R=1000
;.step dec param wc 2.5k 2.5Meg 2
;.ic V(GATE)=28.885086 V(GATEC)=1.3428587
