ut-ras/rm_electrical-supercap/SPICE_sims/load_sharing_gatestab.asc

C3: cap; {1/(A*R*wc)}
C4: cap; {1/(A*R*wc)}
M1: nmos; BSC059N04LS6
M2: nmos; BSC059N04LS6
R1: res; {R}
R2: res; {A*R}
R11: res; 6
R12: res; 20m
R13: res; {R}
R14: res; {R}
R15: res; {A*R}
R16: res; {R}
R17: res; {A*R}
R18: res; {A*R}
U1: OPA551
U2: OPA551
U3: TLV9302
U5: MAX4073T
V1: voltage; 1
V2: voltage; 24
V3: voltage; {VCC}
V4: voltage; 0
V6: voltage; 25.620167; AC 1 0
V7: voltage; 1.344195; AC 1 180
V8: voltage; 24
Named nets: 0, SPLIT, GATE, CAP, VCC, GATEC, VEE, OUT, IN, CURR_RAW, CURR_LIMIT, CURR, GATEC_R, GATE_R, +, -
.op
.tran {simtime} startup uic
.ac dec 20 0.01 10G
.param simtime=10m
;.step dec param simtime 100m 10m 7
.param A=1000 wc=2.5k R=1000
;.step dec param wc 1k 100k 2
;.param A=10 wc=1 R=1k
;.step param VCC 30 40 2
.param VCC=30
;.options abstol=1n reltol=0.001
