ut-ras/rm_electrical-supercap/SPICE_sims/LTC7804.asc

C1: cap; 3.2µ
C2: cap; 0.1µ
C3: cap; 0.01µ
C4: cap; 0.022µ; Rser=8.06K Cpar=220p
C5: cap; 10µ; Rser=8m
C6: cap; 0.15µ
C8: cap; 6.8p
D2: schottky; BAT54
L1: ind; 0.11µ; Rser=3.5m
L2: ind; 0.11µ; Rser=3.5m
L3: ind; 0.11µ; Rser=3.5m
M1: nmos; BSC059N04LS6
M3: nmos; BSC059N04LS6
R1: res; 1.2k
R2: res; 300k
R3: res; 75k
R4: res; 1.3k
R5: res; 7.5k
R6: res; 100k
R7: res; 19
U1: LTC7804
V1: voltage; 4.5
Named nets: 0, IN, OUT, INTVCC, FB
.tran 0 30m 0
.tran 0 30m 0 startup
