ut-ras/rm_electrical-supercap/SPICE_sims/stack_balancing.asc

B1: bi; I=min(V(CURR), if(V(CAP)<2.1,3,6))
B2: bv; V=V(CAP)
B3: bv; V=Ie(Q1)*V(SP)
B4: bv; V=(V(FB)-V(SP))*Ie(Q1)
B5: bv; V=(V(6V)-V(SN))*Ic(Q2)
B6: bv; V=(V(SN)-V(FB))*Ic(Q2)
B7: bv; V=idt(V(P_NPN)+V(P_PNP))
C1: cap; {A*110}; Rser=18m
C2: cap; {A*110}; Rser=18m
C3: cap; {B*110}; Rser=18m
C4: cap; {B*110}; Rser=18m
C5: cap; 1n
C6: cap; 10n
Q1: pnp; 2SAR583D3
Q2: npn; 2SCR583D3
R1: res; 100k
R2: res; 1Meg
R3: res; 1Meg
R4: res; 100
R5: res; 1Meg
R6: res; 1Meg
R7: res; 0.1
R8: res; 0.1
R9: res; 1k
R10: res; 1k
R11: res; 1Meg
R12: res; 1Meg
R727: res; 100
U1: TLV9302
U2: UniversalOpAmp3
V1: voltage; 24
V2: voltage; 6
V3: voltage; 5
V4: voltage; 0
Named nets: 0, FB, CAP, REF, VCC, CURR, OUT, SN, SP, P_NPN, P_lowR, P_PNP, P_highR, REFN, 6V, ENERGY_LOST, AGND
.tran 0 300 1m uic
.ic V(CAP)=0 V(FB)=0
.param A=0.9 B=1.3
Mocked up ideal charger
