ut-ras/rm_electrical-supercap/SPICE_sims/stack_balancing_stab.asc

B3: bv; V=Ie(Q1)*V(SP)
B4: bv; V=(V(FB)-V(SP))*Ie(Q1)
B5: bv; V=(V(6V)-V(SN))*Ic(Q2)
B6: bv; V=(V(SN)-V(FB))*Ic(Q2)
C1: cap; {A*110}; Rser=18m
C2: cap; {A*110}; Rser=18m
C3: cap; {B*110}; Rser=18m
C4: cap; {B*110}; Rser=18m
C6: cap; 1n
Q1: pnp; 2SAR562F3
Q2: npn; 2SCR562F3
R2: res; 1Meg
R3: res; 1Meg
R6: res; 1k
R9: res; 0.2
R10: res; 0.2
R11: res; 1k
R12: res; 2k
U2: TLV9302
V1: voltage; {Vcap/2}
V2: voltage; {Vcap/2}; AC 1
V4: voltage; {Vcap}
V6: voltage; 24
V7: voltage; 6
Named nets: 0, P_NPN, P_lowR, P_PNP, P_highR, FB, REF, VCC, OUT, SN, SP, 6V, REFN
.op
.ac dec 20 0.01 10G
.param A=1.05 B=0.98
.ic V(FB)={Vcap/2}
.param Vcap=6
