ut-ras/rm_electrical-supercap/SPICE_sims/zener.asc

R1: res; 100k
R2: res; 100k
R3: res; 1Meg
R4: res; 1Meg
R5: res; {RZ}
U1: TLV9302
U2: mmsz4678t1g
V1: voltage; 2
V2: voltage; 0.4
V3: voltage; 24
Named nets: 0, LIM, CURR, VCC, DIFF_R, Z47
.op
.dc V2 0 2 0.025
;.step dec param RZ 10 100k 1
.param RZ=15k
