ut-ras/rm_electrical-supercap/SPICE_sims/diff_amp+lpf.asc

C1: cap; {1/(A*R*wc)}
C5: cap; {1/(A*R*wc)}
R1: res; 100k
R2: res; 100k
R5: res; {R}
R6: res; {R}
R7: res; {A*R}
R8: res; {R}
R9: res; {A*R}
R10: res; {R}
R11: res; {A*R}
R12: res; {A*R}
U2: UniversalOpAmp3
U3: TLV07
U4: TLV07
V1: voltage; 0.75
V2: voltage; 3.3
V3: voltage; SINE(0.75 0.1 1k); AC 1
V4: voltage; 36
V5: voltage; 0
Named nets: 0, CURR, VEE, VCC, G3, CURRB, CURR_LIMIT, 3+, 3-, MID, 3V3, G4, 4+, 4-
.op
.param R=250 A=10000 wc=100Meg
.ac dec 20 0.01 10G
.tran 10m uic
