ut-ras/rm_electrical-supercap/SPICE_sims/load_sharing_2.asc

C5: cap; {1/(A*R*wc)}
C6: cap; {1/(A*R*wc)}
E1: e; 20
I1: load; 1.2
M1: nmos; BSC015NE2LS5I
M2: nmos; BSC015NE2LS5I
R1: res; 20m
R11: res; {R}
R12: res; {A*R}
R13: res; {R}
R14: res; {A*R}
R15: res; {R}
R16: res; {A*R}
R17: res; {R}
R18: res; {A*R}
U5: TLV07
U6: TLV07
V1: voltage; 24
V2: voltage; 24
V4: voltage; 36
V5: voltage; 0
V7: voltage; 0.4
Named nets: 0, IN, CAP, G3, G4, VEE, VCC, MID, OUT, CURRB, CURR_LIMIT, 3+, 3-, 4+, 4-
.tran 0 100m 100u uic
.param R=250 A=250 wc=100
.op
