ut-ras/rm_electrical-supercap/SPICE_sims/load_sharing_2_ac.asc

C1: cap; {1/(A*R*wc)}
C2: cap; {1/(A*R*wc)}
I1: load; 1.2; AC 1
M1: nmos; BSC015NE2LS5I
M2: nmos; BSC015NE2LS5I
R1: res; 20m
R2: res; 100k
R3: res; {R}
R4: res; {A*R}
R5: res; {R}
R6: res; {A*R}
R7: res; {R}
R8: res; {A*R}
R9: res; {R}
R10: res; {A*R}
U1: INA138
U2: UniversalOpAmp3
U3: TLV07
U4: TLV07
V1: voltage; 24
V2: voltage; 24
V3: voltage; 3.3
V4: voltage; 36
V5: voltage; 0
V6: voltage; .4
V7: voltage; 35.989418
V8: voltage; 8.8203009m
Named nets: 0, CURR, IN, CAP, G3, G4, CURRB, VEE, VCC, MID, OUT, G3_R, CURR_LIMIT, 3+, 3-, G4_R, 4+, 4-
.tran 0 1m 100u uic
.param R=250 A=10000 wc=100Meg
.op
.ac dec 20 0.01 10G
