ut-ras/rm_electrical-supercap/SPICE_sims/vco.asc

R1: res; 280k
R2: res; 1Meg
R3: res; 75k
R4: res; 1k
U1: LTC6992-1
V1: voltage; 3.3
V2: voltage; {V2}
Named nets: 0, V+, OUT, MOD
NDIV = 64
.step param V2 0 1 0.1
f = 10.42kHz
.tran 10m
