ut-ras/rm_electrical-supercap/SPICE_sims/boost_stage_2.asc

C1: cap; 0.1µ
C2: cap; 9.4µ
C3: cap; 10µ
C4: cap; 0.033µ
C5: cap; 0.1µ
C6: cap; 330p
C7: cap; 12.4µ
C8: cap; 15p
D1: schottky; BAT54
L1: ind; 4.7µ; Ipk=6.7 Rser=19.5m
M1: nmos; BSC059N04LS6
M2: nmos; BSC059N04LS6
R1: res; 10m
R2: res; 100k
R3: res; 76.8k
R4: res; 5.9k
R5: res; 330k
R6: res; 30k
R7: res; 43k
U1: TPS43061_TRANS
V1: voltage; 6; AC 1
Named nets: 0, VCC, IN, OUT, SW, LDRV, HDRV, FB, COMP, RT, SS, IN_R
.tran 1m startup
