ut-ras/rm_electrical-supercap/SPICE_sims/current_sense2.asc

C1: cap; 100p
D1: diode; BAT54
D2: diode; BAT54
R1: res; 30k
R2: res; 100k; tol=5
R4: res; 30k
R5: res; 120k
R6: res; 120k
R7: res; 1k; tol=5
R8: res; 12k; tol=5
R9: res; 1.4k; tol=2
R10: res; 1k
R11: res; 1k
R13: res; 1k; tol=5
R14: res; 12k; tol=5
R15: res; 2.5k; tol=2
U1: INA138
U2: TLV9302
U3: TLV9302
U4: TS370x
U6: TS370x
V1: voltage; 24
V2: voltage; -3.3
V3: voltage; 2
V4: voltage; 3.3
V5: voltage; PWL(0 0.05 9.9u 0.05 10u 0.1)
V6: voltage
Named nets: 0, curr_p, POW_LIM, CC, EE, 24V, P_N, curr_pb, CURR, V_Extra, DIRECT_EN, Den_ref, CHARGE_EN, Cen_ref, D_OUT, C_OUT
.dc V6 0 0.2 0.05
.tran 50u
.option noopiter
;.step dec param C 100p 99n 2
