ut-ras/rm_electrical-supercap/SPICE_sims/schmitt_trigger.asc

D1: diode; BAT54
R1: res; 1k; tol=5
R2: res; 13k; tol=5
R3: res; 2.2k; tol=2
R4: res; 1k
U1: TS370x
V1: voltage; 24
V2: voltage; -3.3
V3: voltage; 3.3
V4: voltage; SINE(-1.65 1.65 2 0 0 0 2)
Named nets: DIRECT_EN, Den_ref, CC, EE, 0, 24V, IN, D_OUT
.tran 1
