ut-ras/rm_electrical-supercap/SPICE_sims/CurrentSense.asc

C2: cap; 39n
I1: current; 1
R1: res; 0.02; tol=1
R2: res; 100k; tol=5
R3: res; 820; tol=5
R4: res; 3.3k; tol=5
R5: res; 1k; tol=2
R6: res; 2.2k; tol=2
R7: res; 1.2k
R8: res; 3.9k
R9: res; 1.2k
R10: res; 28.8k
R11: res; 30k
R12: res; 120k
R13: res; 120k
R14: res; 100
R15: res; 47k
R16: res; 47k
U1: INA138
U2: TLV9302
U3: LM393LV
U4: LM393LV
U6: TLV9302
V1: voltage; 24
V2: voltage; -3.3
V3: voltage; 2
V4: voltage; 3.3
Named nets: 0, CURR, 3.3VA, DIRECT_EN, POW_LIM, Charge_EN, 3.3-ve, 24V, V_Extra, Den_ref, CEN_ref, curr_p
.dc I1 0 1 .1
