ut-ras/rm_electrical-supercap/SPICE_sims/voltage_follower.asc

R1: res; 1k
U1: TLV9302
U2: LM393LV
V1: voltage; 2.5
V2: voltage; 5
V3: voltage; 2.5
Named nets: 0, IN, OUT, REF, VCC, OUT_C
.dc V1 0 5 0.5
