ut-ras/rm_electrical-supercap/SPICE_sims/Ideal_diode_controller.asc

C24: cap; 0.022µ
C25: cap; 0.1µ
C26: cap; 47µ
D4: TVSdiode; SMCJ33A
Q3: nmos
U1: LM74700-Q1_TRANS
V1: voltage; 24
V2: voltage; PULSE(0 5 10m 0 0 250u 500u)
Named nets: 0, Vout
.tran 0 15m 8m
