ut-ras/rm_electrical-supercap/Rev 1B Boards/CurrSense 1B/CurrSense 1B.kicad_pcb

## KiCad design Rev 1B Boards/CurrSense 1B/CurrSense 1B.kicad_pcb (2025-10-19)

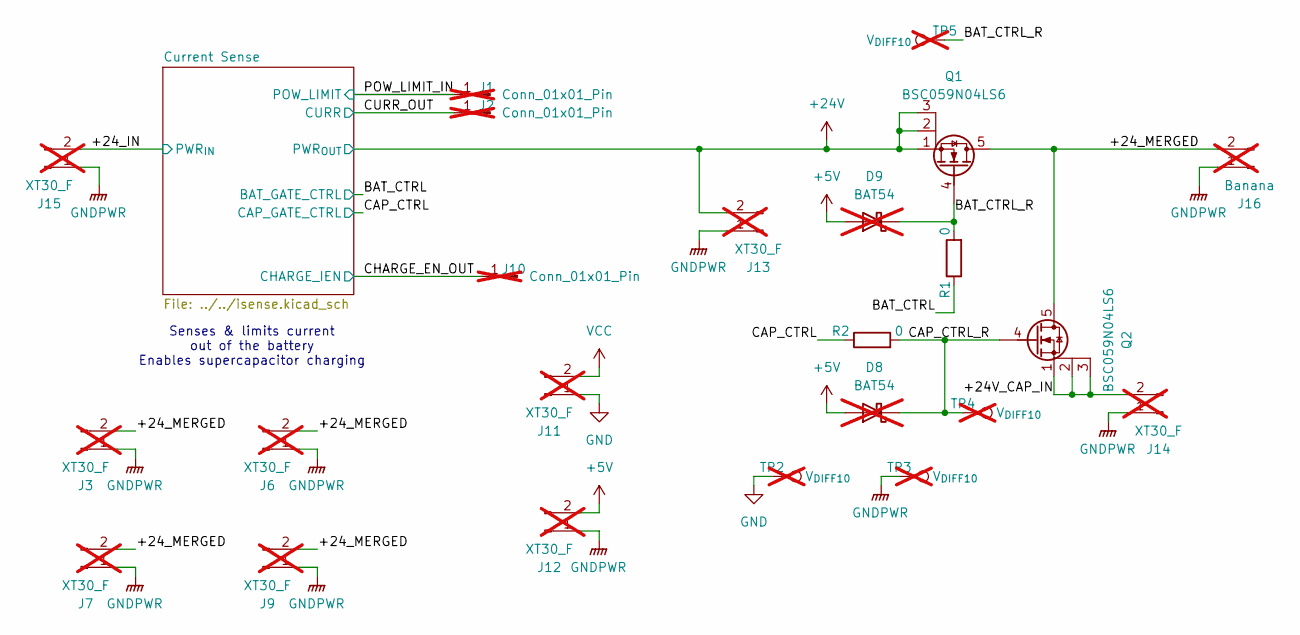
[picture p18: schematic CurrSense 1B.kicad_sch, Current Sense Test Board]

Parts:
D8, D9: BAT54; SOT-23_Handsoldering; Mouser Part Number 241-BAT54_R1_00001; not fitted
J1, J2, J10: Conn_01x01_Pin; SolderWire-2.5sqmm_1x01_D2.4mm_OD3.6mm; not fitted
J3, J6, J7, J9, J11, J12, J13, J14, J15: XT30_F; AMASS_XT30U-F_1x02_P5.0mm_Vertical; not fitted
J16: Banana; RM_Banana_Jack_2Pin; not fitted
Q1, Q2: BSC059N04LS6; Infineon_PG-TDSON-8_6.15x5.15mm; Mouser Part Number 726-BSC059N04LS6ATMA
R1, R2: 0; R_0603_1608Metric_Pad0.98x0.95mm_HandSolder; Mouser Part Number 660-RK73Z1JTTDD
TP2, TP3, TP4, TP5: V_{DIFF10}; TestPoint_Bridge_Pitch2.0mm_Drill0.7mm; not fitted

Connections:
+5V: D8.3 (A), D9.3 (A), J12.2
+24V: J13.2, Q1.1 (S), Q1.2 (S), Q1.3 (S); also elsewhere on the board
/+24V_CAP_IN: J14.2, Q2.1 (S), Q2.2 (S), Q2.3 (S)
/+24_IN: J15.2; also elsewhere on the board
/+24_MERGED: J3.2, J6.2, J7.2, J9.2, J16.2, Q1.5 (D), Q2.5 (D)
/BAT_CTRL: R1.1; also elsewhere on the board
/BAT_CTRL_R: D9.1 (K), Q1.4 (G), R1.2, TP5.1
/CAP_CTRL: R2.1; also elsewhere on the board
/CAP_CTRL_R: D8.1 (K), Q2.4 (G), R2.2, TP4.1
/CHARGE_EN_OUT: J10.1; also elsewhere on the board
/CURR_OUT: J2.1; also elsewhere on the board
/POW_LIMIT_IN: J1.1; also elsewhere on the board
GND: J11.1, TP2.1; also elsewhere on the board
GNDPWR: J3.1, J6.1, J7.1, J9.1, J12.1, J13.1, J14.1, J15.1, J16.1, TP3.1; also elsewhere on the board
VCC: J11.2; also elsewhere on the board

Notes on the sheet:
Senses & limits current out of the battery Enables supercapacitor charging

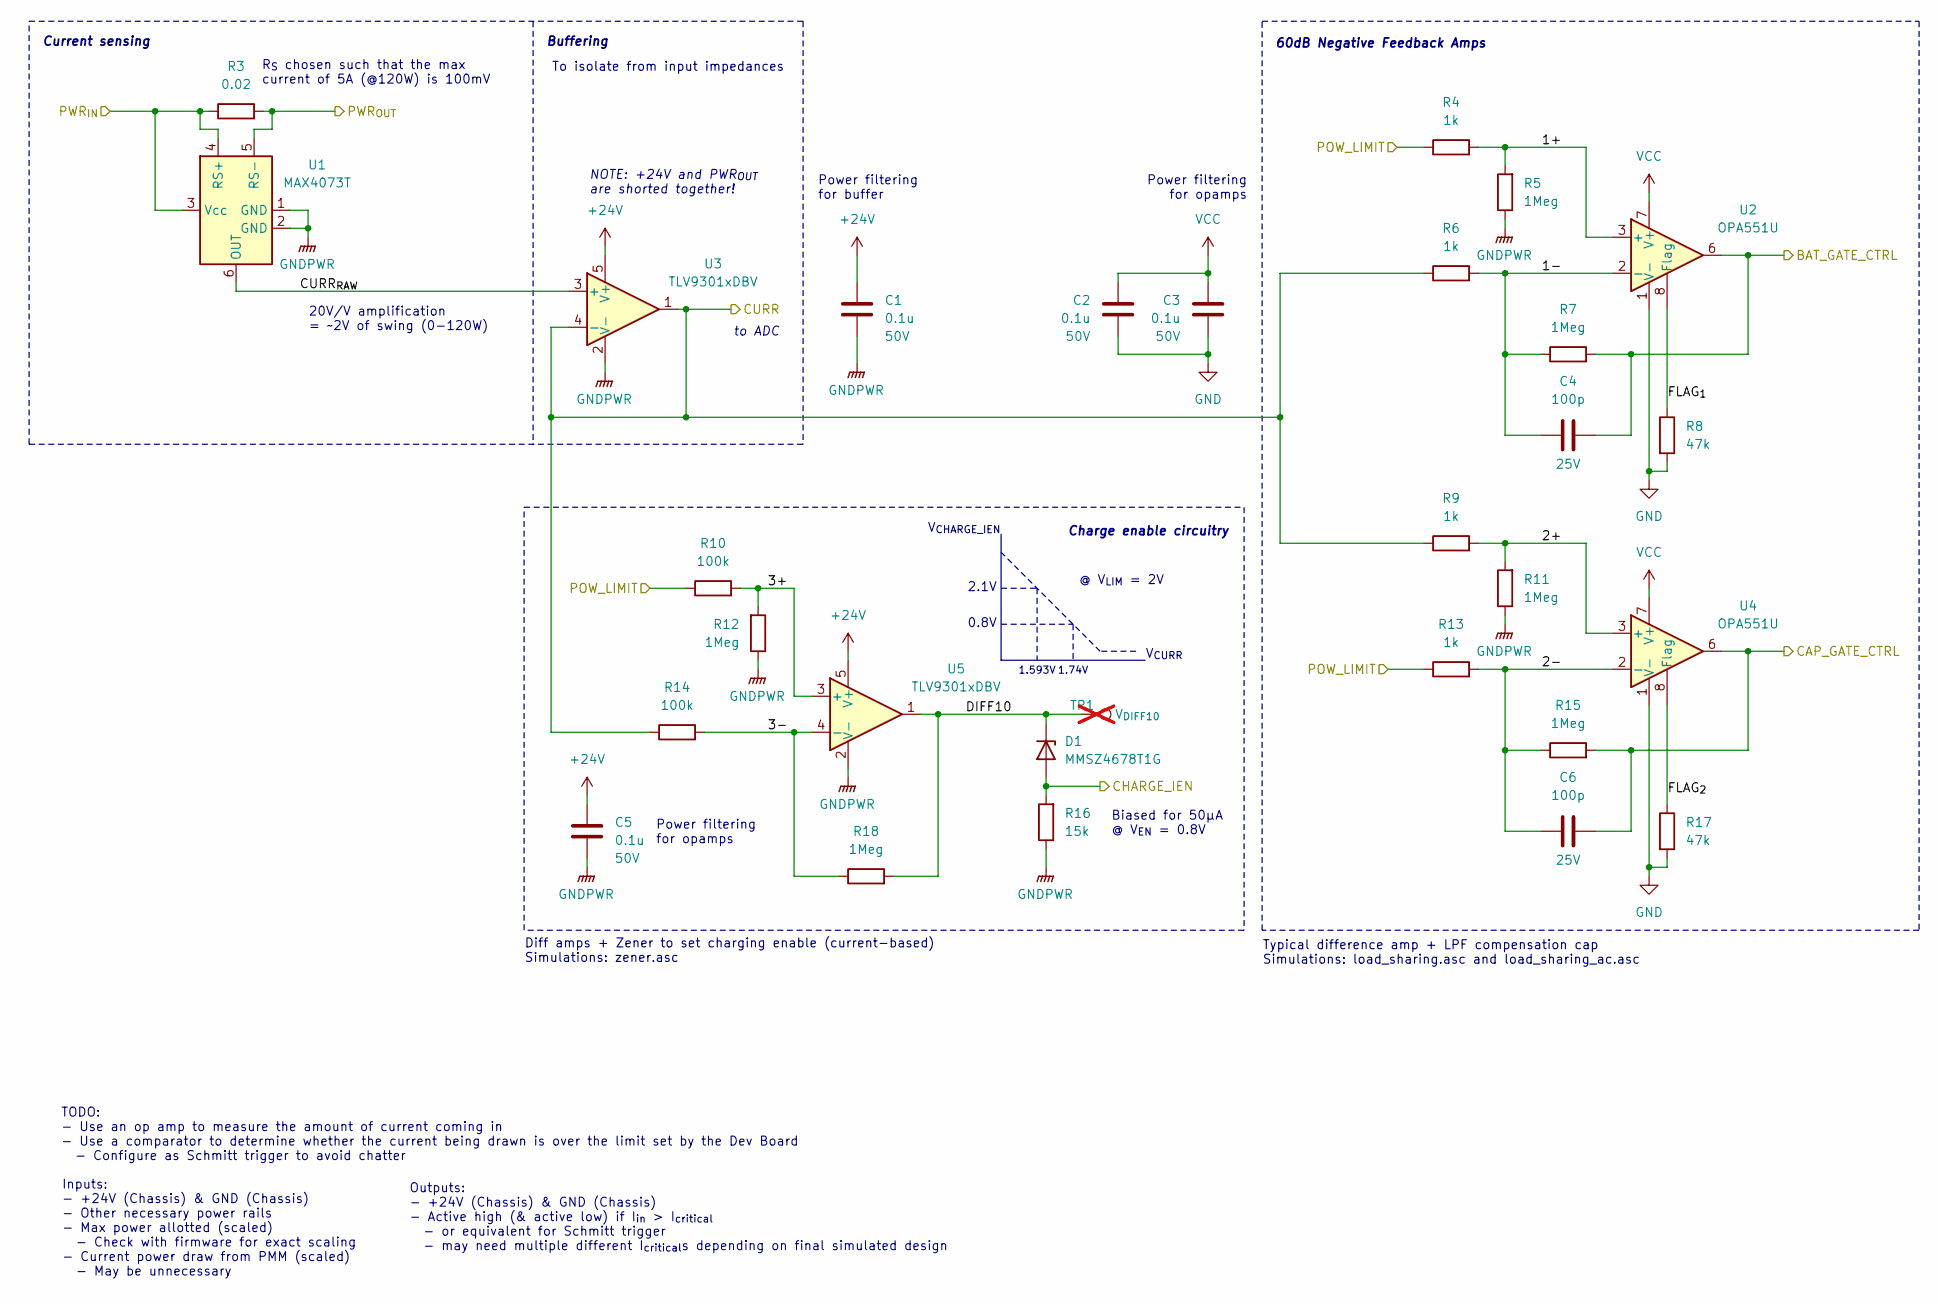
[picture p19: schematic isense.kicad_sch, Current Sensing]

Parts:
C1, C2, C3, C5: 0.1u; C_0603_1608Metric_Pad1.08x0.95mm_HandSolder; Voltage Rating 50V; Mouser Part Number 581-KGM15BR71H104JT
C4, C6: 100p; C_0603_1608Metric_Pad1.08x0.95mm_HandSolder; Voltage Rating 25V
D1: MMSZ4678T1G; D_SOD-123; Mouser Part Number 863-MMSZ4678T1G
R3: 0.02; R_0805_2012Metric_Pad1.20x1.40mm_HandSolder; Mouser Part Number 504-MFSA0805R0200FIM
R4, R6, R9, R13: 1k; R_0603_1608Metric_Pad0.98x0.95mm_HandSolder; Mouser Part Number 660-RN73R1JTD1001F50
R5, R7, R11, R12, R15, R18: 1Meg; R_0603_1608Metric_Pad0.98x0.95mm_HandSolder; Mouser Part Number 603-RC0603FR-071MP
R8, R17: 47k; R_0603_1608Metric_Pad0.98x0.95mm_HandSolder; Mouser Part Number 603-RC0603FR-1047KL
R10, R14: 100k; R_0603_1608Metric_Pad0.98x0.95mm_HandSolder; Mouser Part Number 660-RN73H1JTD1003D25
R16: 15k; R_0603_1608Metric_Pad0.98x0.95mm_HandSolder; Mouser Part Number 603-RT0603FRE1315KL
TP1: V_{DIFF10}; TestPoint_Bridge_Pitch2.0mm_Drill0.7mm; not fitted
U1: MAX4073T; SOT-23-6_Handsoldering; Mouser Part Number 700-MAX4073TAUT+T
U2, U4: OPA551U; SOIC-8_3.9x4.9mm_P1.27mm; Mouser Part Number 595-OPA551UA
U3, U5: TLV9301xDBV; SOT-23-5_HandSoldering; Mouser Part Number 595-TLV9301IDBVR

Connections:
+24V: C1.1, C5.1, R3.2, U1.5 (RS-), U3.5 (V+), U5.5 (V+); also elsewhere on the board
/+24_IN: R3.1, U1.3 (Vcc), U1.4 (RS+); also elsewhere on the board
/BAT_CTRL: C4.2, R7.2, U2.6; also elsewhere on the board
/CAP_CTRL: C6.2, R15.2, U4.6; also elsewhere on the board
/CHARGE_EN_OUT: D1.2 (A), R16.2; also elsewhere on the board
/CURR_OUT: R6.1, R9.1, R14.1, U3.1, U3.4 (-); also elsewhere on the board
/Current Sense/1+: R4.2, R5.2, U2.3 (+)
/Current Sense/1-: C4.1, R6.2, R7.1, U2.2 (-); also elsewhere on the board
/Current Sense/2+: R9.2, R11.2, U4.3 (+)
/Current Sense/2-: C6.1, R13.2, R15.1, U4.2 (-); also elsewhere on the board
/Current Sense/3+: R10.2, R12.2, U5.3 (+)
/Current Sense/3-: R14.2, R18.1, U5.4 (-); also elsewhere on the board
/Current Sense/CURR_{RAW}: U1.6 (OUT), U3.3 (+); also elsewhere on the board
/Current Sense/DIFF10: D1.1 (K), R18.2, TP1.1, U5.1; also elsewhere on the board
/Current Sense/FLAG_{1}: R8.1, U2.8 (Flag)
/Current Sense/FLAG_{2}: R17.1, U4.8 (Flag)
/POW_LIMIT_IN: R4.1, R10.1, R13.1; also elsewhere on the board
GND: C2.2, C3.2, R8.2, R17.2, U2.1 (V-), U2.4 (V-), U2.5 (V-), U4.1 (V-), U4.4 (V-), U4.5 (V-); also elsewhere on the board
GNDPWR: C1.2, C5.2, R5.1, R11.1, R12.1, R16.1, U1.1 (GND), U1.2 (GND), U3.2 (V-), U5.2 (V-); also elsewhere on the board
VCC: C2.1, C3.1, U2.7 (V+), U4.7 (V+); also elsewhere on the board

Notes on the sheet:
Inputs: - +24V (Chassis) & GND (Chassis) - Other necessary power rails - Max power allotted (scaled) - Check with firmware for exact scaling - Current power draw from PMM (scaled) - May be unnecessary
Power filtering for buffer
Power filtering for opamps
1.593V
Biased for 50µA @ V_{EN} = 0.8V
60dB Negative Feedback Amps
0.8V
1.74V
20V/V amplification = ~2V of swing (0-120W)
Typical difference amp + LPF compensation cap Simulations: load_sharing.asc and load_sharing_ac.asc
Diff amps + Zener to set charging enable (current-based) Simulations: zener.asc
Outputs: - +24V (Chassis) & GND (Chassis) - Active high (& active low) if I_{in} > I_{critical} - or equivalent for Schmitt trigger - may need multiple different I_{critical}s depending on final simulated design
V_{CHARGE_IEN}
V_{CURR}
R_{S} chosen such that the max current of 5A (@120W) is 100mV
TODO: - Use an op amp to measure the amount of current coming in - Use a comparator to determine whether the current being drawn is over the limit set by the Dev Board - Configure as Schmitt trigger to avoid chatter
2.1V
NOTE: +24V and PWR_{OUT} are shorted together!
To isolate from input impedances
Charge enable circuitry
to ADC
Buffering
Current sensing
@ V_{LIM} = 2V

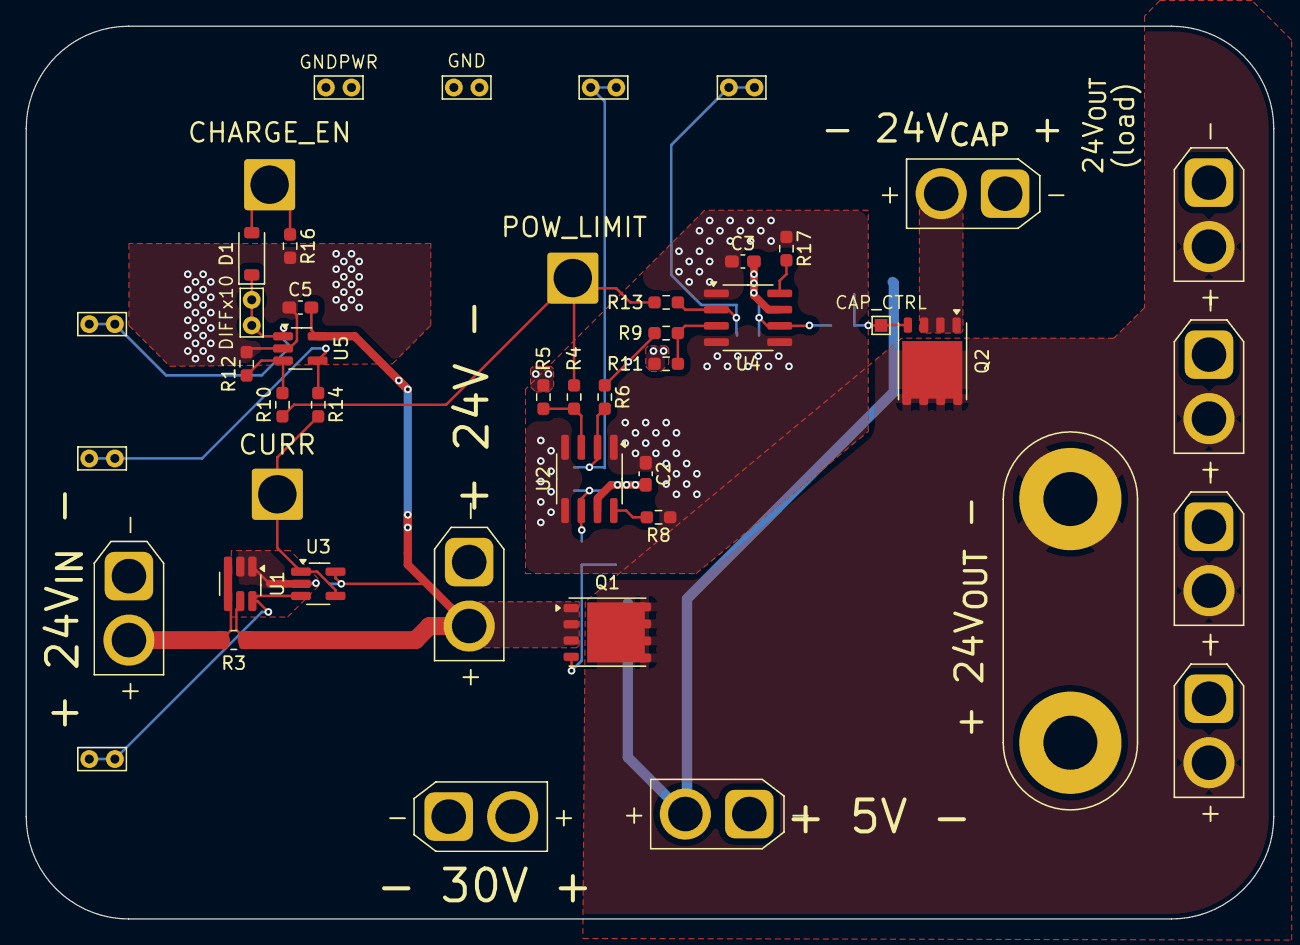
[picture p20: board CurrSense 1B.kicad_pcb from above]

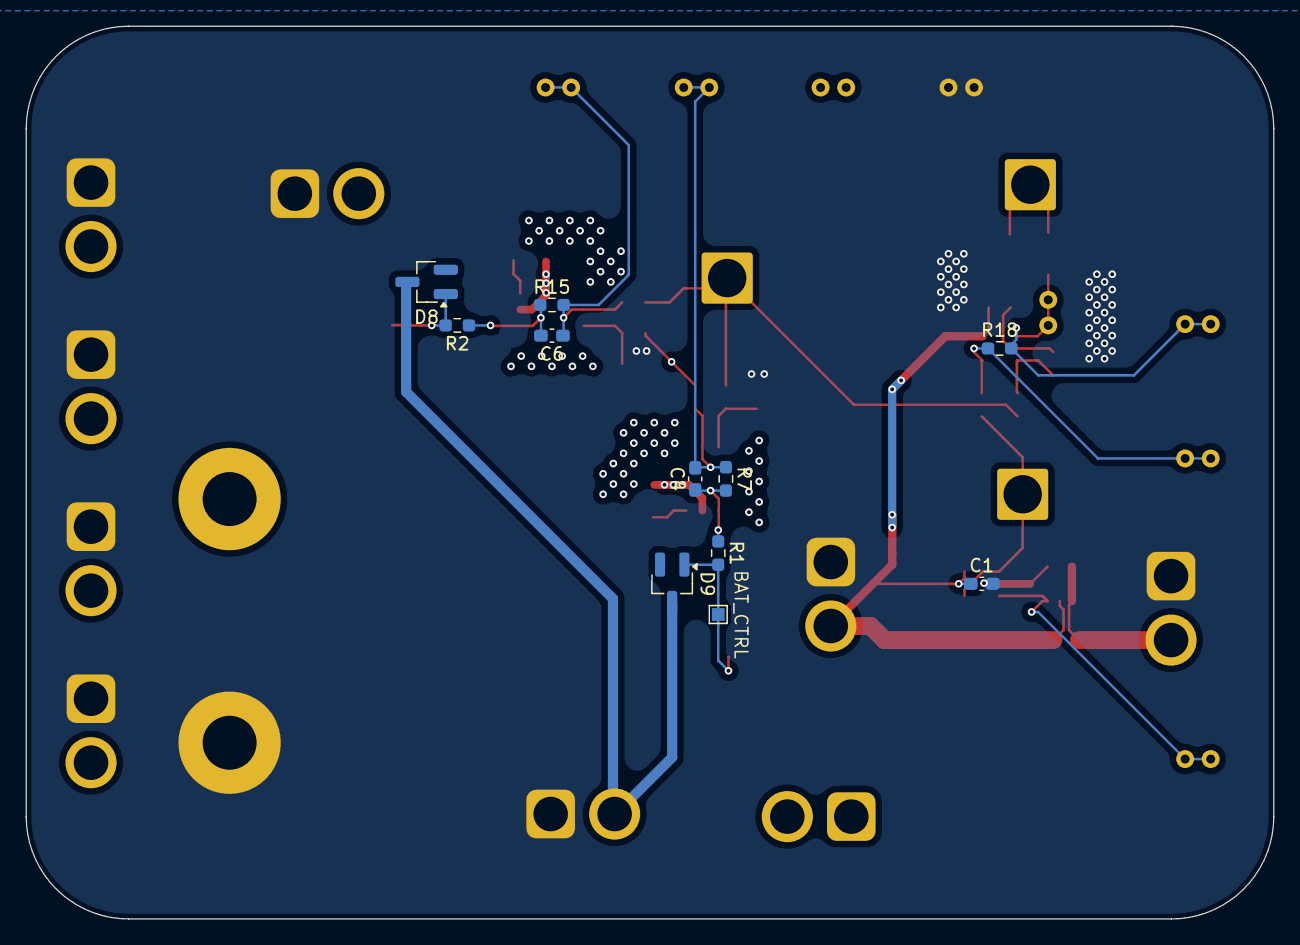
[picture p21: board CurrSense 1B.kicad_pcb from below]

Board: 4 copper layers, 97.5 x 69.8 mm, 57 parts (11 on the bottom side), 25 nets.

Other parts of the board:
TP6: CE_OUT; TestPoint_Bridge_Pitch2.0mm_Drill0.7mm
TP7: CE_IN_NEG; TestPoint_Bridge_Pitch2.0mm_Drill0.7mm
TP8: I_OUT; TestPoint_Bridge_Pitch2.0mm_Drill0.7mm
TP9: CAP_IN_NEG; TestPoint_Bridge_Pitch2.0mm_Drill0.7mm
TP10: BAT_IN_NEG; TestPoint_Bridge_Pitch2.0mm_Drill0.7mm

Their connections:
/Current Sense/1-: TP10.1; also elsewhere on the board
/Current Sense/2-: TP9.1; also elsewhere on the board
/Current Sense/3-: TP7.1; also elsewhere on the board
/Current Sense/CURR_{RAW}: TP8.1; also elsewhere on the board
/Current Sense/DIFF10: TP6.1; also elsewhere on the board
