ut-ras/rm_electrical-supercap/Rev 1B Boards/InputBuck 1B/InputBuck 1B.kicad_pcb

## KiCad design Rev 1B Boards/InputBuck 1B/InputBuck 1B.kicad_pcb (2025-05-29)

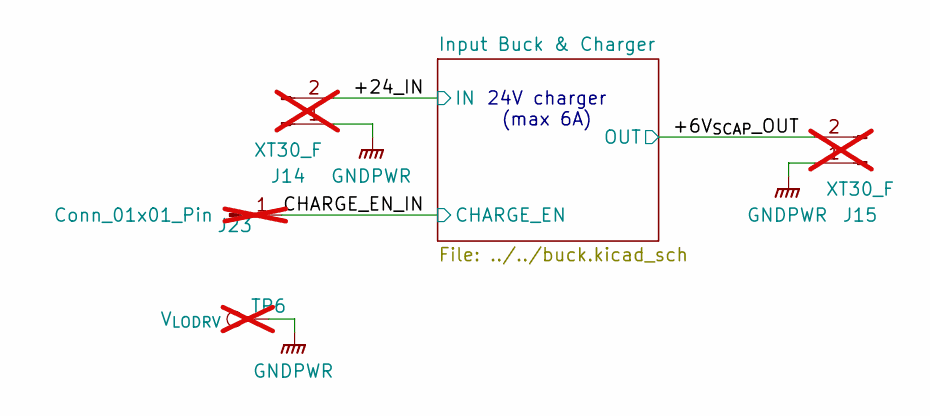
[picture p22: schematic InputBuck 1B.kicad_sch]

Parts:
J14, J15: XT30_F; AMASS_XT30U-F_1x02_P5.0mm_Vertical; not fitted
J23: Conn_01x01_Pin; SolderWire-2.5sqmm_1x01_D2.4mm_OD3.6mm; not fitted
TP6: V_{LODRV}; TestPoint_Bridge_Pitch2.0mm_Drill0.7mm; not fitted

Connections:
/+6V_{SCAP}_OUT: J15.2; also elsewhere on the board
/+24_IN: J14.2; also elsewhere on the board
/CHARGE_EN_IN: J23.1; also elsewhere on the board
GNDPWR: J14.1, J15.1, TP6.1; also elsewhere on the board

Notes on the sheet:
24V charger (max 6A)

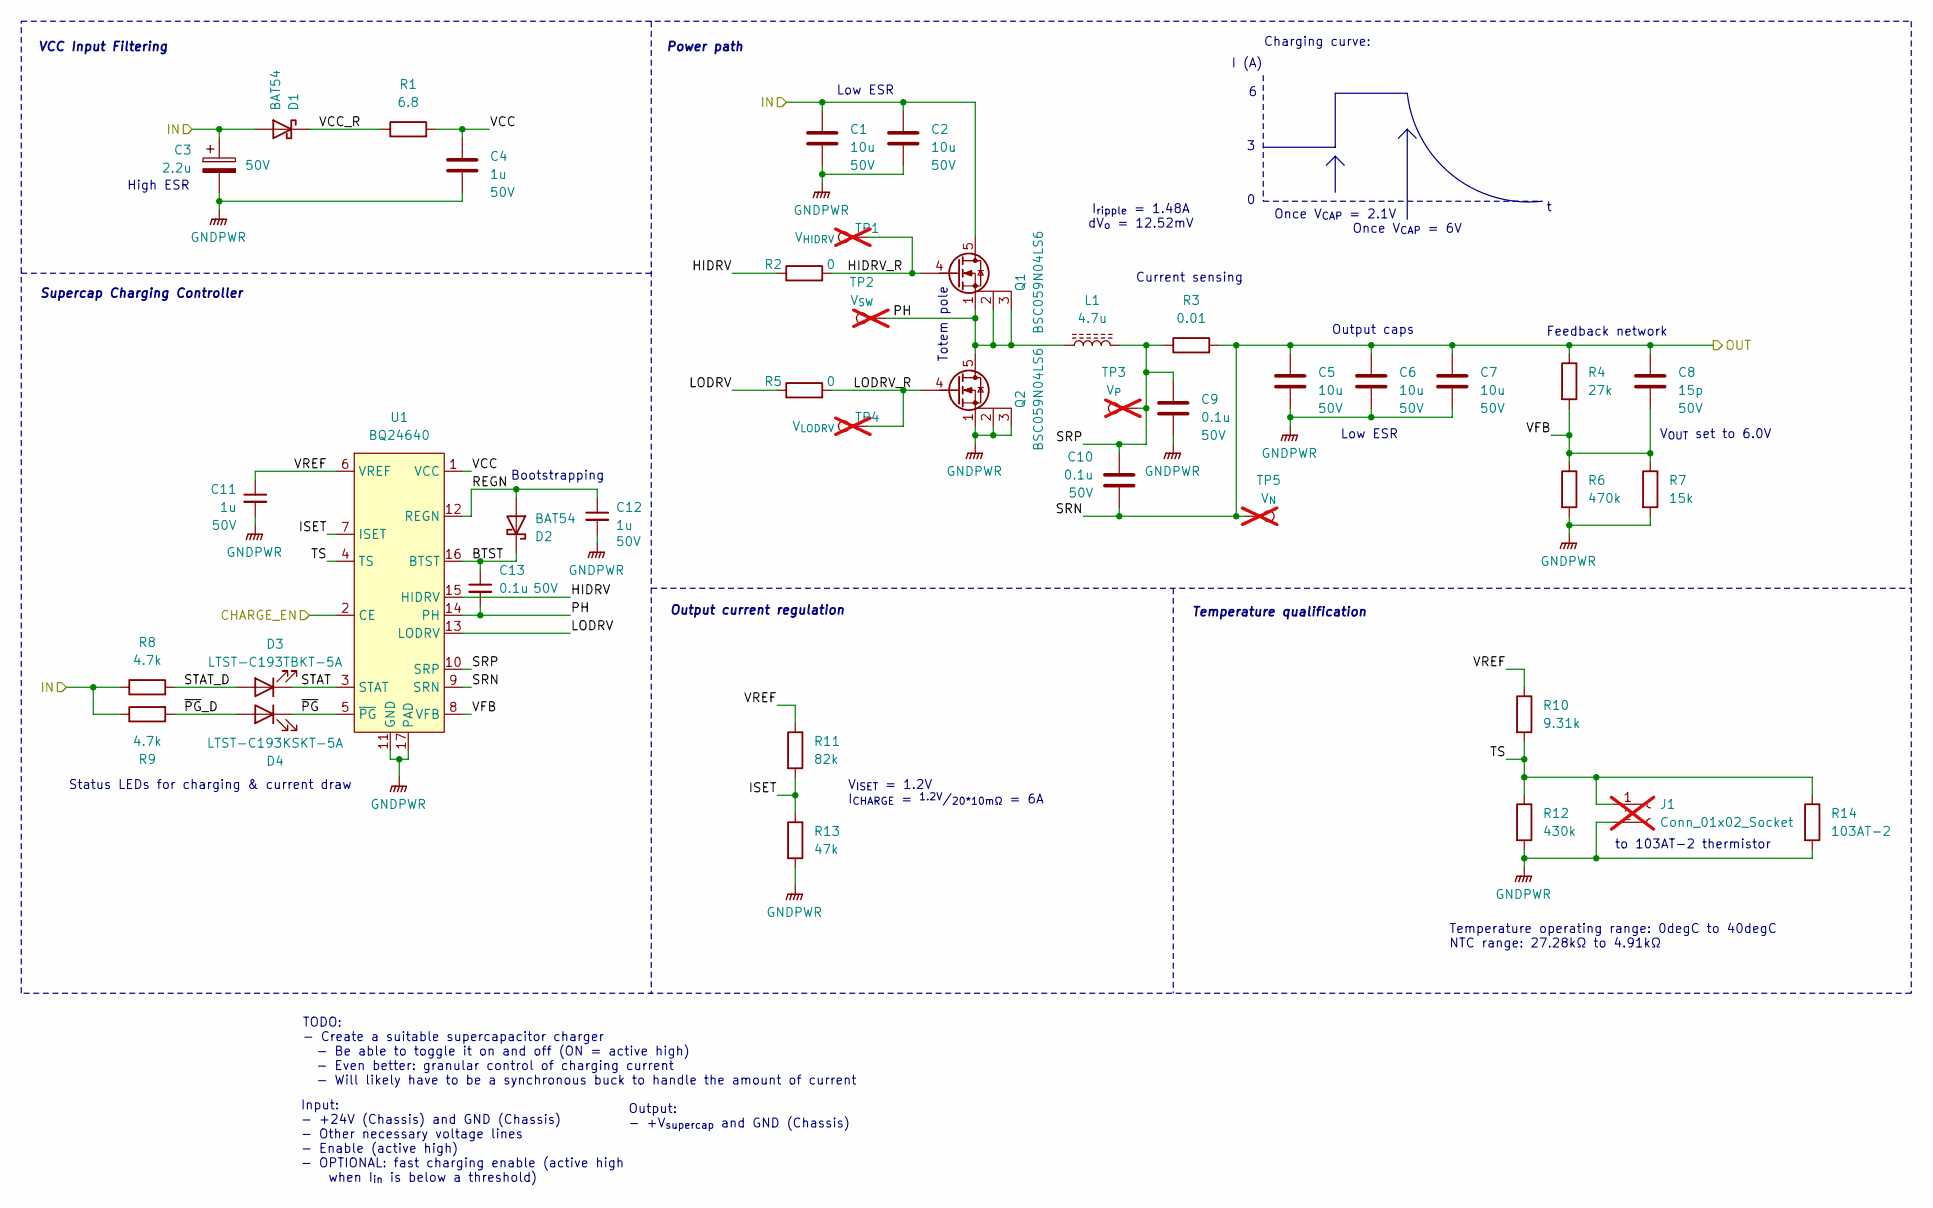
[picture p23: schematic buck.kicad_sch, Supercapacitor Charger]

Parts:
C1, C2, C5, C6, C7: 10u; C_1206_3216Metric_Pad1.33x1.80mm_HandSolder; Voltage Rating 50V; Mouser Part Number 187-CL31A106KBHNNNE
C3: 2.2u; C_Radial_D5.0mm_H11.0mm_P2.00mm; Voltage Rating 50V; Mouser Part Number 710-860010672006
C4, C11, C12: 1u; C_0603_1608Metric_Pad1.08x0.95mm_HandSolder; Voltage Rating 50V; Mouser Part Number 963-UMK107BJ105KA-T
C8: 15p; C_0603_1608Metric_Pad1.08x0.95mm_HandSolder; Voltage Rating 50V; Mouser Part Number 791-0603N150F500CT
C9, C10, C13: 0.1u; C_0603_1608Metric_Pad1.08x0.95mm_HandSolder; Voltage Rating 50V; Mouser Part Number 581-KGM15BR71H104JT
D1, D2: BAT54; SOT-23_Handsoldering; Mouser Part Number 241-BAT54_R1_00001
D3: LTST-C193TBKT-5A; LED_0603_1608Metric_Pad1.05x0.95mm_HandSolder; Mouser Part Number 859-LTSTC193TBKT5A
D4: LTST-C193KSKT-5A; LED_0603_1608Metric_Pad1.05x0.95mm_HandSolder; Mouser Part Number 859-LTSTC193KSKT5A
J1: Conn_01x02_Socket; PinSocket_1x02_P2.54mm_Vertical; not fitted
L1: 4.7u; L_Bourns_SRN8040TA; Mouser Part Number 652-SRN8040TA-4R7M
Q1, Q2: BSC059N04LS6; Infineon_PG-TDSON-8_6.15x5.15mm; Mouser Part Number 726-BSC059N04LS6ATMA
R1: 6.8; R_0805_2012Metric_Pad1.20x1.40mm_HandSolder; Mouser Part Number 660-RK73B2ATTD6R8J
R2, R5: 0; R_0603_1608Metric_Pad0.98x0.95mm_HandSolder; Mouser Part Number 660-RK73Z1JTTDD
R3: 0.01; R_0612_1632Metric_Pad1.18x3.40mm_HandSolder; Mouser Part Number 652-CFG0612FXR010ELF
R4: 27k; R_0603_1608Metric_Pad0.98x0.95mm_HandSolder; Mouser Part Number 660-RN73H1JTD2702B25
R6: 470k; R_0603_1608Metric_Pad0.98x0.95mm_HandSolder; Mouser Part Number 660-RN73R1JTD4703B25
R7: 15k; R_0603_1608Metric_Pad0.98x0.95mm_HandSolder; Mouser Part Number 603-RT0603FRE1315KL
R8, R9: 4.7k; R_0603_1608Metric_Pad0.98x0.95mm_HandSolder; Mouser Part Number 660-RN73R1JTD4701F50
R10: 9.31k; R_0603_1608Metric_Pad0.98x0.95mm_HandSolder; Mouser Part Number 603-RT0603DRE079K31L
R11: 82k; R_0603_1608Metric_Pad0.98x0.95mm_HandSolder; Mouser Part Number 603-RT0603FRE0782KL
R12: 430k; R_0603_1608Metric_Pad0.98x0.95mm_HandSolder; Mouser Part Number 603-RT0603FRE07430KL
R13: 47k; R_0603_1608Metric_Pad0.98x0.95mm_HandSolder; Mouser Part Number 603-RC0603FR-1047KL
R14: 103AT-2; Mouser Part Number 504-NRNE104H3435B2H
TP1: V_{HIDRV}; TestPoint_Bridge_Pitch2.0mm_Drill0.7mm; not fitted
TP2: V_{SW}; TestPoint_Bridge_Pitch2.0mm_Drill0.7mm; not fitted
TP3: V_{P}; TestPoint_Bridge_Pitch2.0mm_Drill0.7mm; not fitted
TP4: V_{LODRV}; TestPoint_Bridge_Pitch2.0mm_Drill0.7mm; not fitted
TP5: V_{N}; TestPoint_Bridge_Pitch2.0mm_Drill0.7mm; not fitted
U1: BQ24640; QFN50P350X350X100-17N-D; Mouser Part Number 595-BQ24640RVAR

Connections:
/+6V_{SCAP}_OUT: C5.1, C6.1, C7.1, C8.1, C10.2, R3.2, R4.1, TP5.1, U1.9 (SRN); also elsewhere on the board
/+24_IN: C1.1, C2.1, C3.1, D1.1 (A), Q1.5 (D), R8.1, R9.1; also elsewhere on the board
/CHARGE_EN_IN: U1.2 (CE); also elsewhere on the board
/Input Buck & Charger/BTST: C13.1, D2.3 (K), U1.16 (BTST)
/Input Buck & Charger/HIDRV: R2.1, U1.15 (HIDRV)
/Input Buck & Charger/HIDRV_R: Q1.4 (G), R2.2, TP1.1
/Input Buck & Charger/ISET: R11.2, R13.1, U1.7 (ISET)
/Input Buck & Charger/LODRV: R5.1, U1.13 (LODRV)
/Input Buck & Charger/LODRV_R: Q2.4 (G), R5.2, TP4.1
/Input Buck & Charger/PH: C13.2, L1.1, Q1.1 (S), Q1.2 (S), Q1.3 (S), Q2.5 (D), TP2.1, U1.14 (PH)
/Input Buck & Charger/REGN: C12.1, D2.1 (A), U1.12 (REGN)
/Input Buck & Charger/SRP: C9.1, C10.1, L1.2, R3.1, TP3.1, U1.10 (SRP)
/Input Buck & Charger/STAT: D3.1 (K), U1.3 (STAT)
/Input Buck & Charger/STAT_D: D3.2 (A), R8.2
/Input Buck & Charger/TS: J1.1, R10.2, R12.1, U1.4 (TS)
/Input Buck & Charger/VCC: C4.1, R1.2, U1.1 (VCC)
/Input Buck & Charger/VCC_R: D1.3 (K), R1.1
/Input Buck & Charger/VFB: C8.2, R4.2, R6.1, R7.1, U1.8 (VFB)
/Input Buck & Charger/VREF: C11.1, R10.1, R11.1, U1.6 (VREF)
/Input Buck & Charger/~PG: D4.1 (K), U1.5 (~PG)
/Input Buck & Charger/~PG_D: D4.2 (A), R9.2
GNDPWR: C1.2, C2.2, C3.2, C4.2, C5.2, C6.2, C7.2, C9.2, C11.2, C12.2, J1.2, Q2.1 (S), Q2.2 (S), Q2.3 (S), R6.2, R7.2, R12.2, R13.2, U1.11 (GND), U1.17 (PAD); also elsewhere on the board

Notes on the sheet:
Charging curve:
Current sensing
Once V_{CAP} = 6V
Totem pole
to 103AT-2 thermistor
TODO: - Create a suitable supercapacitor charger - Be able to toggle it on and off (ON = active high) - Even better: granular control of charging current - Will likely have to be a synchronous buck to handle the amount of current
Status LEDs for charging & current draw
Low ESR
V_{OUT} set to 6.0V
Temperature qualification
I_{ripple} = 1.48A dV_{o} = 12.52mV
Output caps
Bootstrapping
V_{ISET} = 1.2V I_{CHARGE} = ^{1.2V}/_{20*10mΩ} = 6A
Once V_{CAP} = 2.1V
Input: - +24V (Chassis) and GND (Chassis) - Other necessary voltage lines - Enable (active high) - OPTIONAL: fast charging enable (active high when I_{in} is below a threshold)
High ESR
Feedback network
Output: - +V_{supercap} and GND (Chassis)
Power path
Supercap Charging Controller
VCC Input Filtering
Temperature operating range: 0degC to 40degC NTC range: 27.28kΩ to 4.91kΩ
I (A)
Output current regulation

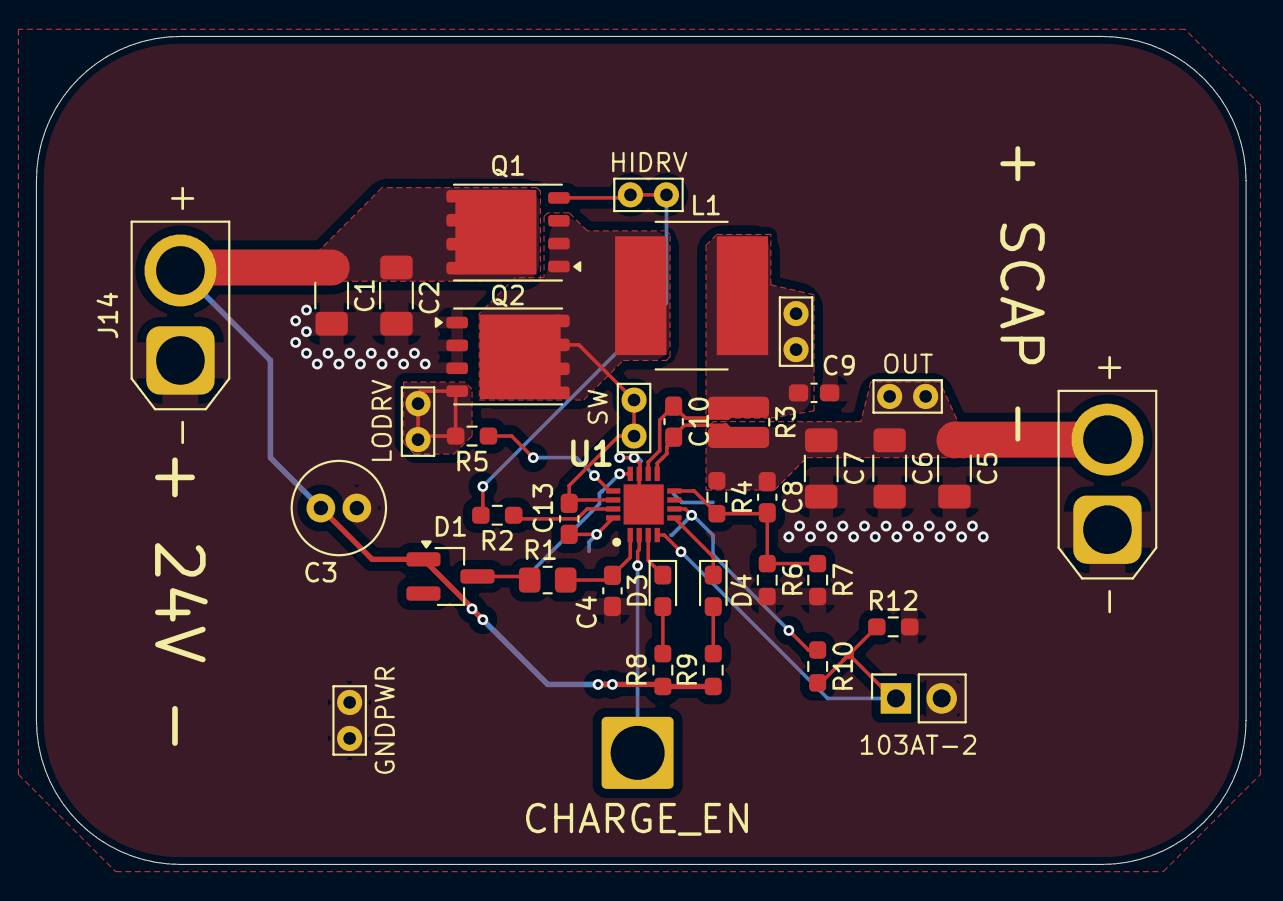
[picture p24: board InputBuck 1B.kicad_pcb from above]

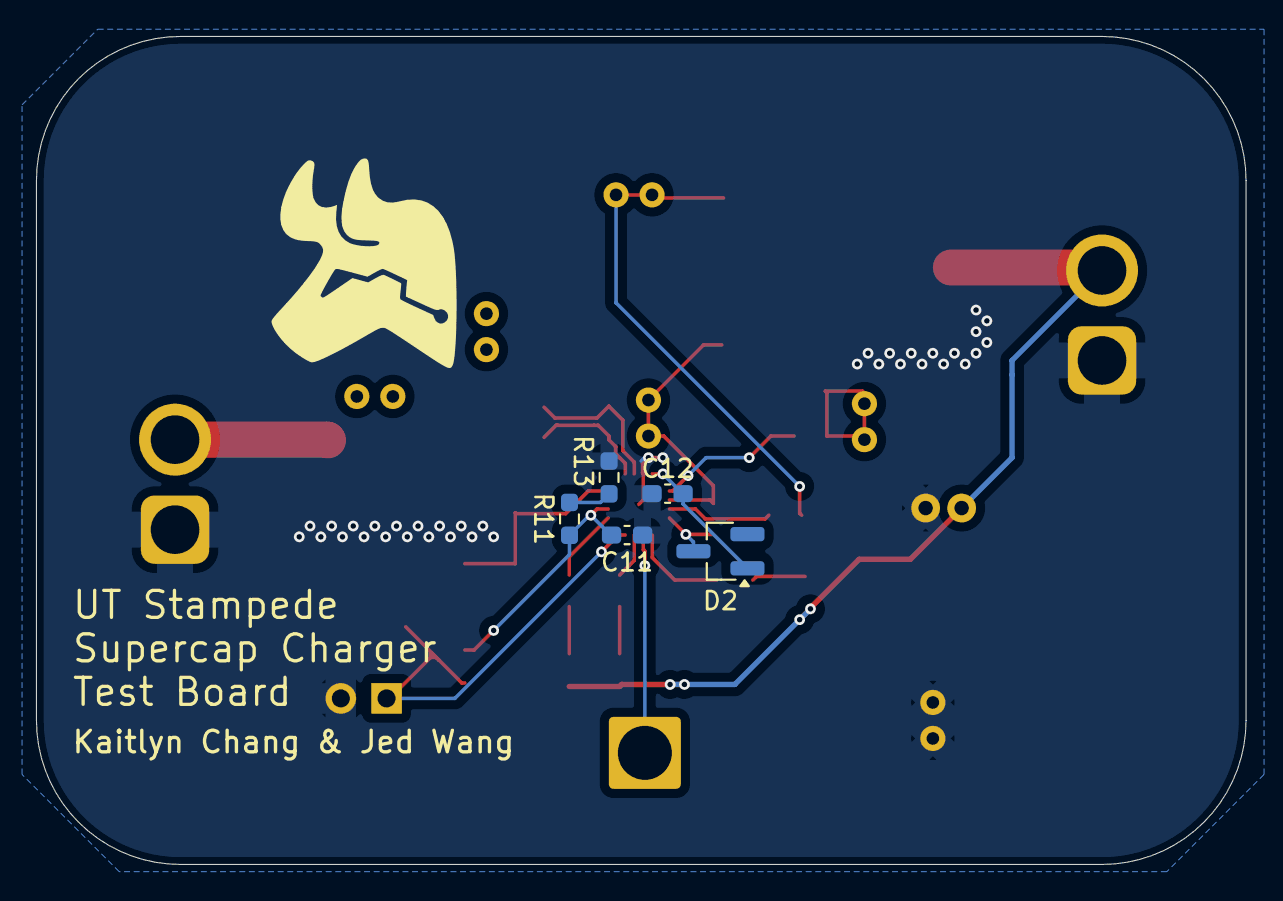
[picture p25: board InputBuck 1B.kicad_pcb from below]

Board: 4 copper layers, 67.2 x 46.0 mm, 44 parts (5 on the bottom side), 22 nets.
