ut-ras/rm_electrical-supercap/Rev 1B Boards/DevBoardInterface 1B/DevBoardInterface 1B.kicad_pcb

## KiCad design Rev 1B Boards/DevBoardInterface 1B/DevBoardInterface 1B.kicad_pcb (2025-05-29)

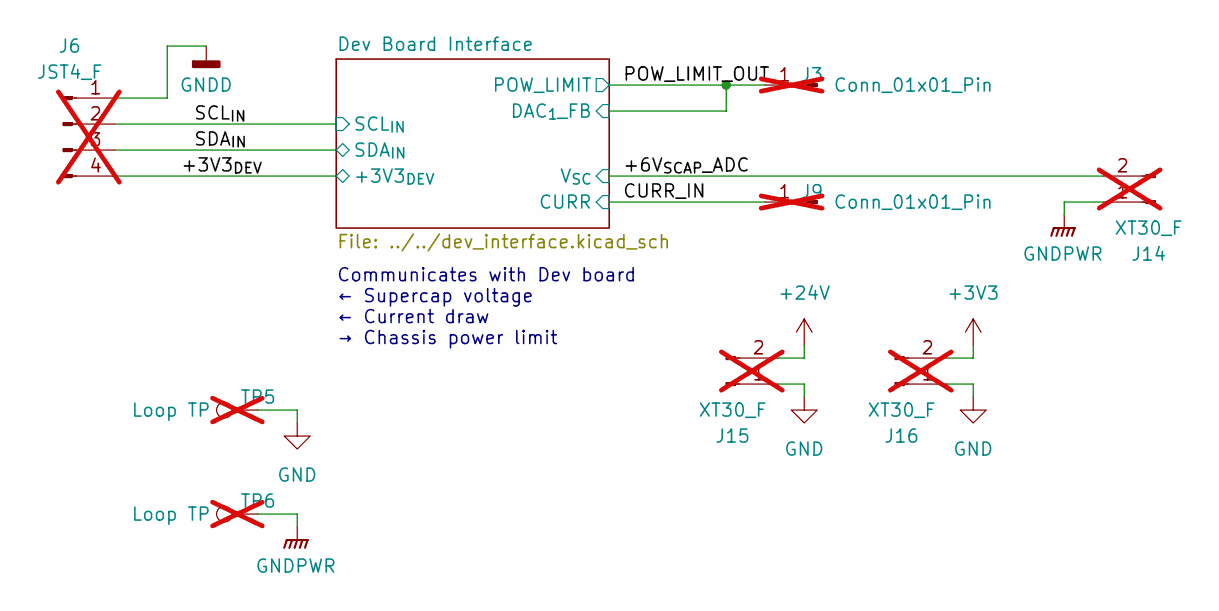
[picture p26: schematic DevBoardInterface 1B.kicad_sch, Dev Board Interface Test Board]

Parts:
J3, J9: Conn_01x01_Pin; SolderWire-2.5sqmm_1x01_D2.4mm_OD3.6mm; not fitted
J6: JST4_F; JST_GH_BM04B-GHS-TBT_1x04-1MP_P1.25mm_Vertical; not fitted
J14, J15, J16: XT30_F; AMASS_XT30U-F_1x02_P5.0mm_Vertical; not fitted
TP5, TP6: Loop TP; TestPoint_Bridge_Pitch2.0mm_Drill0.7mm; not fitted

Connections:
+3V3: J16.2; also elsewhere on the board
+24V: J15.2; also elsewhere on the board
/+3V3_{DEV}: J6.4; also elsewhere on the board
/+6V_{SCAP}_ADC: J14.2; also elsewhere on the board
/CURR_IN: J9.1; also elsewhere on the board
/POW_LIMIT_OUT: J3.1; also elsewhere on the board
/SCL_{IN}: J6.2; also elsewhere on the board
/SDA_{IN}: J6.3; also elsewhere on the board
GND: J15.1, J16.1, TP5.1; also elsewhere on the board
GNDD: J6.1; also elsewhere on the board
GNDPWR: J14.1, TP6.1; also elsewhere on the board

Notes on the sheet:
Communicates with Dev board ← Supercap voltage ← Current draw → Chassis power limit

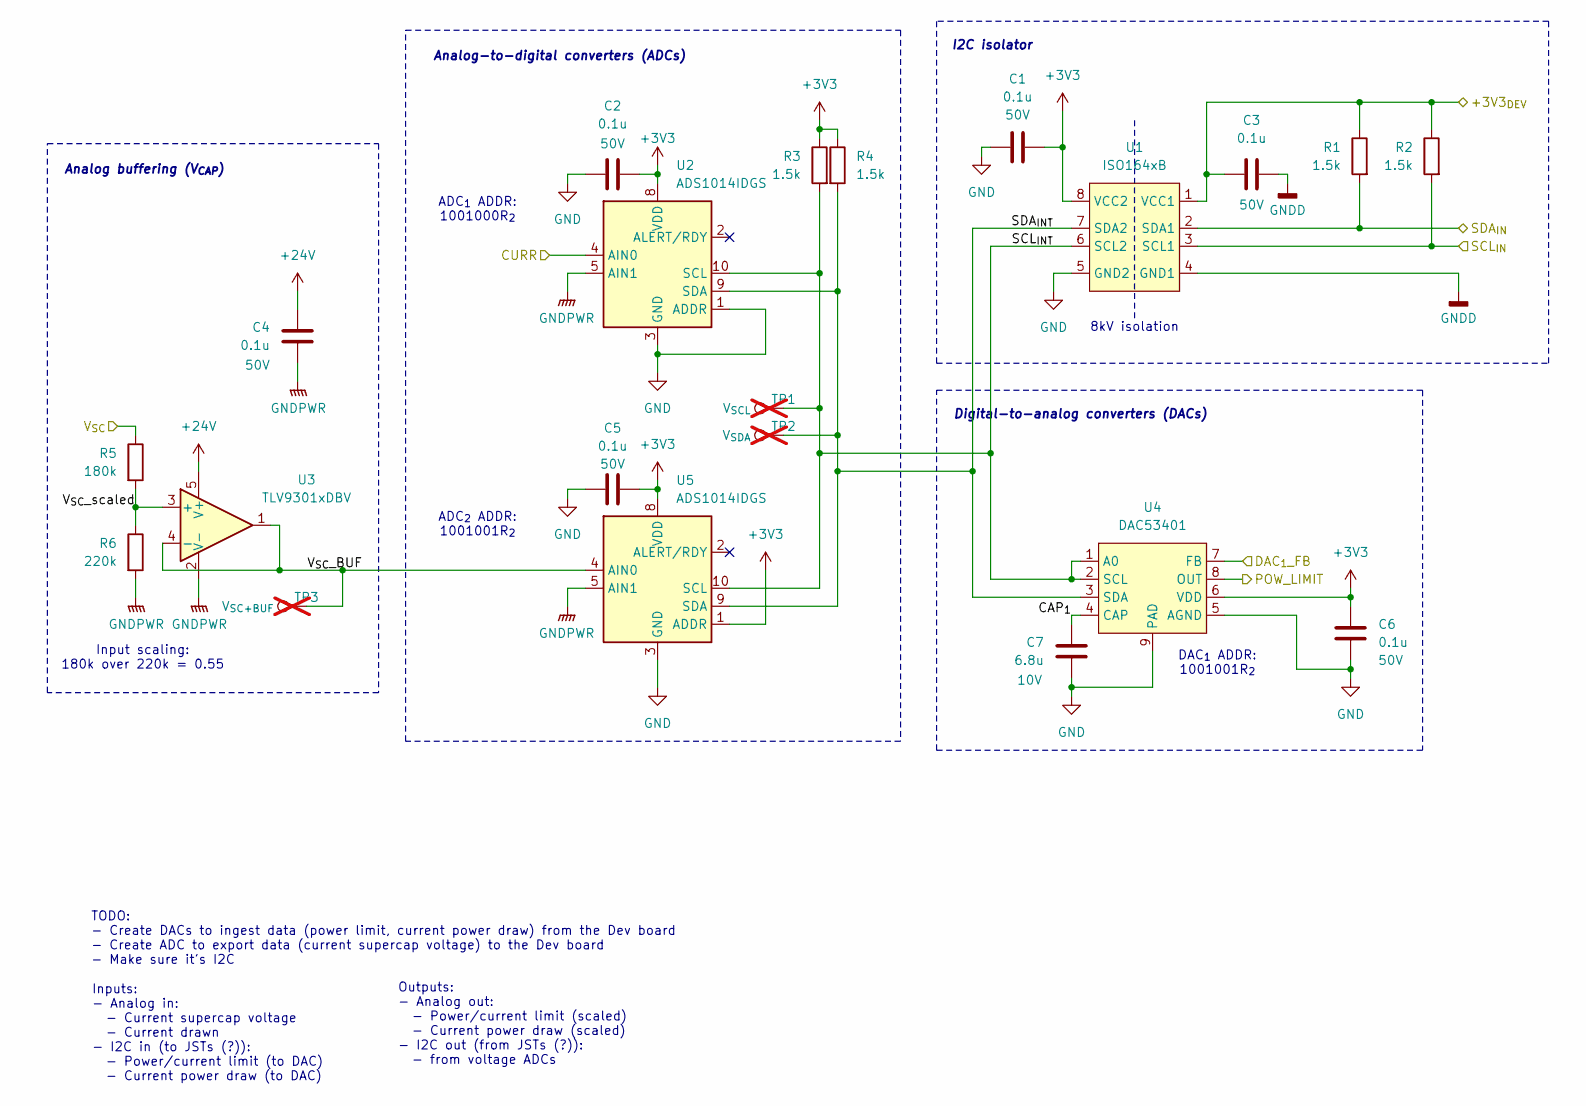
[picture p27: schematic dev_interface.kicad_sch, Dev Board Interface]

Parts:
C1, C2, C3, C4, C5, C6: 0.1u; C_0603_1608Metric_Pad1.08x0.95mm_HandSolder; Voltage Rating 50V; Mouser Part Number 581-KGM15BR71H104JT
C7: 6.8u; C_0603_1608Metric_Pad1.08x0.95mm_HandSolder; Voltage Rating 10V; Mouser Part Number 810-C2012X5R1A685K0C
R1, R2, R3, R4: 1.5k; R_0603_1608Metric_Pad0.98x0.95mm_HandSolder; Mouser Part Number 603-RC0603FR-7W1K5L
R5: 180k; R_0603_1608Metric_Pad0.98x0.95mm_HandSolder; Mouser Part Number 603-RT0603DRE07180KL
R6: 220k; R_0603_1608Metric_Pad0.98x0.95mm_HandSolder; Mouser Part Number 660-RK73H1JTTD2203F
TP1: V_{SCL}; TestPoint_Bridge_Pitch2.0mm_Drill0.7mm; not fitted
TP2: V_{SDA}; TestPoint_Bridge_Pitch2.0mm_Drill0.7mm; not fitted
TP3: V_{SC+BUF}; TestPoint_Bridge_Pitch2.0mm_Drill0.7mm; not fitted
U1: ISO164xB; SOIC-8_3.9x4.9mm_P1.27mm; Mouser Part Number 595-ISO1641BDR
U2, U5: ADS1014IDGS; TSSOP-10_3x3mm_P0.5mm; Mouser Part Number 595-ADS1014IDGSR
U3: TLV9301xDBV; SOT-23-5_HandSoldering; Mouser Part Number 595-TLV9301IDBVR
U4: DAC53401; WSON-8-1EP_2x2mm_P0.5mm_EP0.9x1.6mm; Mouser Part Number 595-DAC53401DSGR

Connections:
+3V3: C1.1, C2.2, C5.2, C6.2, R3.1, R4.1, U1.8 (VCC2), U2.8 (VDD), U4.6 (VDD), U5.1 (ADDR), U5.8 (VDD); also elsewhere on the board
+24V: C4.2, U3.5 (V+); also elsewhere on the board
/+3V3_{DEV}: C3.2, R1.1, R2.1, U1.1 (VCC1); also elsewhere on the board
/+6V_{SCAP}_ADC: R5.1; also elsewhere on the board
/CURR_IN: U2.4 (AIN0); also elsewhere on the board
/Dev Board Interface/CAP_{1}: C7.1, U4.4 (CAP)
/Dev Board Interface/SCL_{INT}: R3.2, TP1.1, U1.6 (SCL2), U2.10 (SCL), U4.1 (A0), U4.2 (SCL), U5.10 (SCL)
/Dev Board Interface/SDA_{INT}: R4.2, TP2.1, U1.7 (SDA2), U2.9 (SDA), U4.3 (SDA), U5.9 (SDA)
/Dev Board Interface/V_{SC}_BUF: TP3.1, U3.1, U3.4 (-), U5.4 (AIN0)
/Dev Board Interface/V_{SC}_scaled: R5.2, R6.1, U3.3 (+)
/POW_LIMIT_OUT: U4.7 (FB), U4.8 (OUT); also elsewhere on the board
/SCL_{IN}: R2.2, U1.3 (SCL1); also elsewhere on the board
/SDA_{IN}: R1.2, U1.2 (SDA1); also elsewhere on the board
GND: C1.2, C2.1, C5.1, C6.1, C7.2, U1.5 (GND2), U2.1 (ADDR), U2.3 (GND), U4.5 (AGND), U4.9 (PAD), U5.3 (GND); also elsewhere on the board
GNDD: C3.1, U1.4 (GND1); also elsewhere on the board
GNDPWR: C4.1, R6.2, U2.5 (AIN1), U3.2 (V-), U5.5 (AIN1); also elsewhere on the board

Notes on the sheet:
Input scaling: 180k over 220k = 0.55
I2C isolator
TODO: - Create DACs to ingest data (power limit, current power draw) from the Dev board - Create ADC to export data (current supercap voltage) to the Dev board - Make sure it's I2C
Inputs: - Analog in: - Current supercap voltage - Current drawn - I2C in (to JSTs (?)): - Power/current limit (to DAC) - Current power draw (to DAC)
ADC_{2} ADDR: 1001001R_{2}
Outputs: - Analog out: - Power/current limit (scaled) - Current power draw (scaled) - I2C out (from JSTs (?)): - from voltage ADCs
Digital-to-analog converters (DACs)
DAC_{1} ADDR: 1001001R_{2}
Analog-to-digital converters (ADCs)
8kV isolation
Analog buffering (V_{CAP})
ADC_{1} ADDR: 1001000R_{2}
