ut-ras/rm_electrical-supercap/Rev 1B Boards/DevBoardInterface 1B/DevBoardInterface 1B.kicad_pcb

## KiCad design Rev 1B Boards/DevBoardInterface 1B/DevBoardInterface 1B.kicad_pcb (continued)

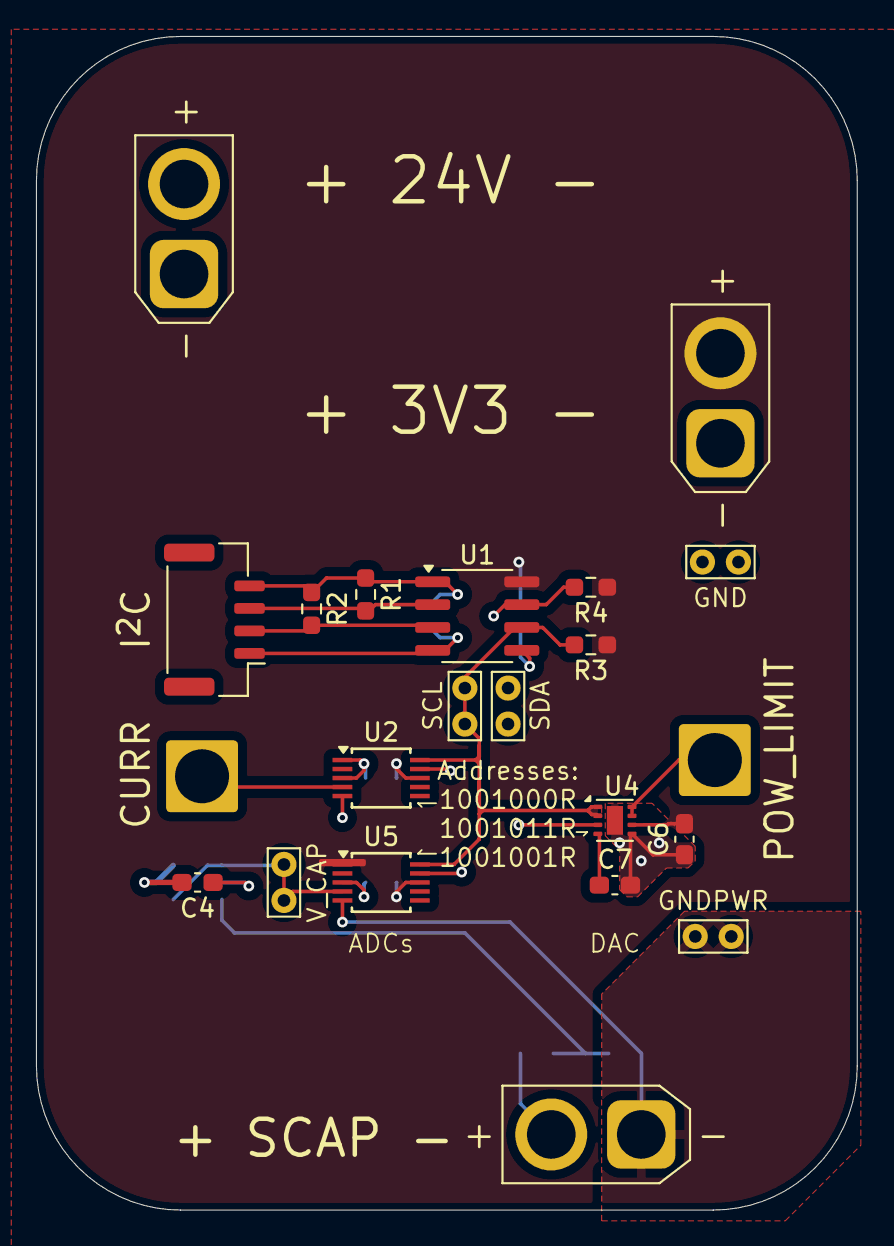
[picture p28: board DevBoardInterface 1B.kicad_pcb from above]

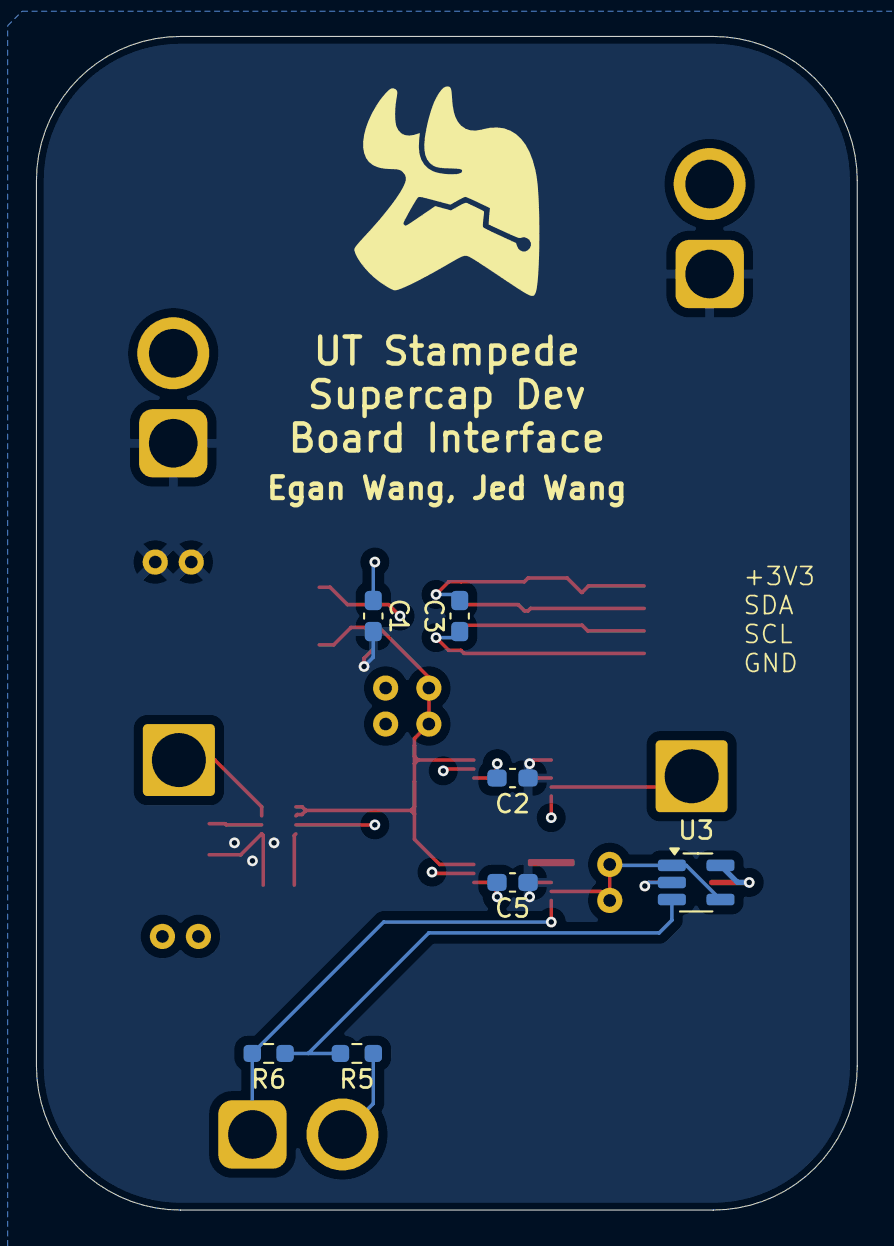
[picture p29: board DevBoardInterface 1B.kicad_pcb from below]

Board: 4 copper layers, 45.6 x 65.2 mm, 29 parts (7 on the bottom side), 16 nets.
