ut-ras/rm_electrical-supercap/Rev 1B Boards/Boost1 1B/Boost1 1B.kicad_pcb

## KiCad design Rev 1B Boards/Boost1 1B/Boost1 1B.kicad_pcb (2025-05-29)

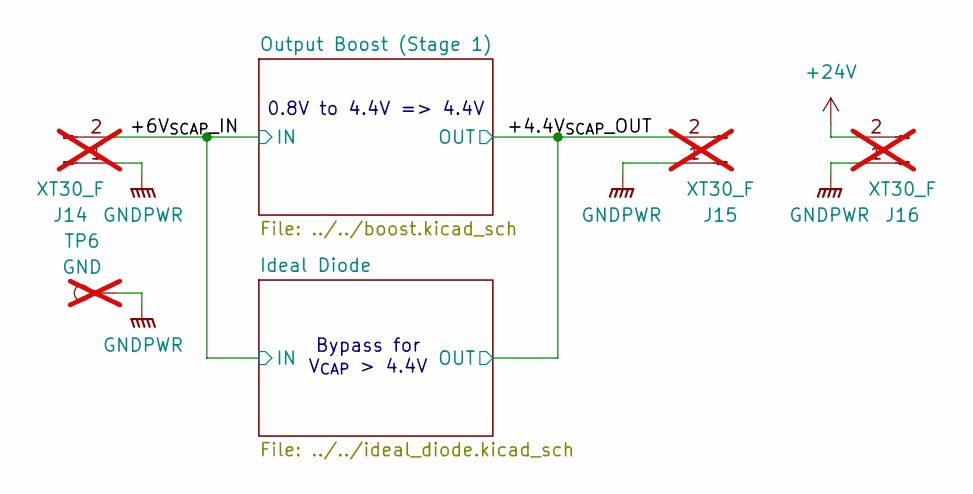
[picture p30: schematic Boost1 1B.kicad_sch, Stage 1 Boost Converter Test Board]

Parts:
J14, J15, J16: XT30_F; AMASS_XT30U-F_1x02_P5.0mm_Vertical; not fitted
TP6: GND; TestPoint_Bridge_Pitch2.0mm_Drill0.7mm; not fitted

Connections:
+24V: J16.2; also elsewhere on the board
/+4.4V_{SCAP}_OUT: J15.2; also elsewhere on the board
/+6V_{SCAP}_IN: J14.2; also elsewhere on the board
GNDPWR: J14.1, J15.1, J16.1, TP6.1; also elsewhere on the board

Notes on the sheet:
0.8V to 4.4V => 4.4V
Bypass for V_{CAP} > 4.4V

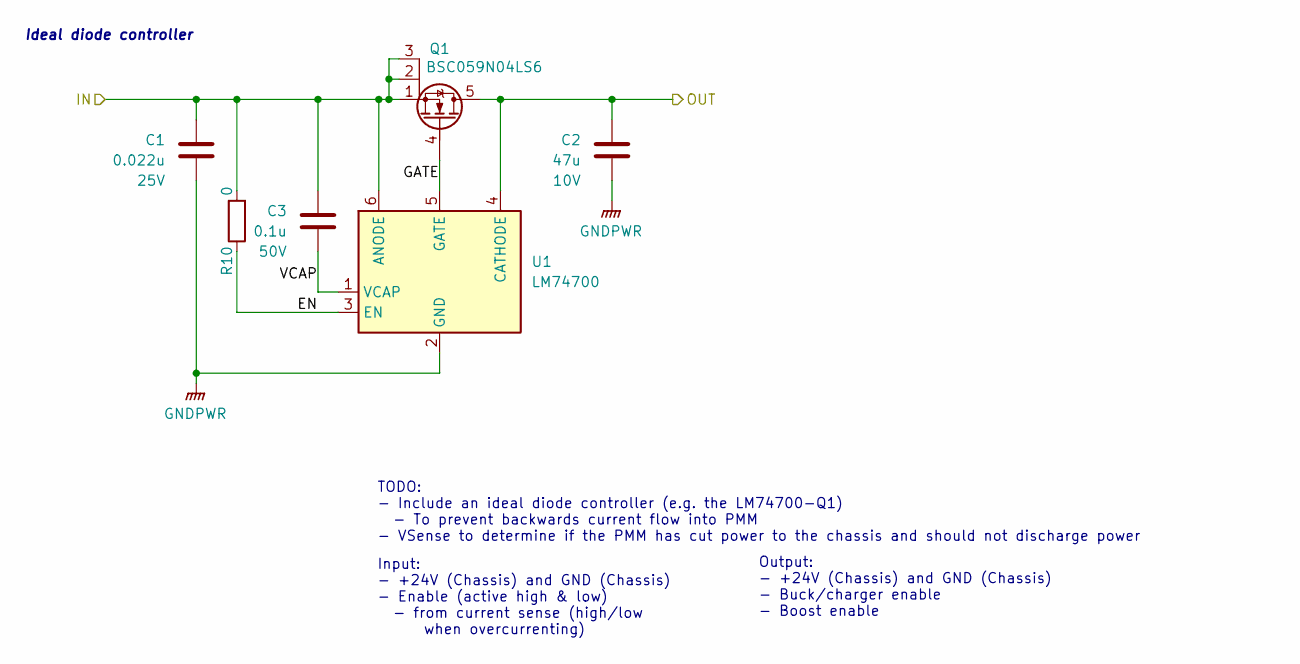
[picture p31: schematic ideal_diode.kicad_sch, Ideal Diode + VSense]

Parts:
C1: 0.022u; C_0603_1608Metric_Pad1.08x0.95mm_HandSolder; Voltage Rating 25V; Mouser Part Number 710-885012206067
C2: 47u; C_1206_3216Metric_Pad1.33x1.80mm_HandSolder; Voltage Rating 10V; Mouser Part Number 81-GRM31CR61A476ME5K
C3: 0.1u; C_0603_1608Metric_Pad1.08x0.95mm_HandSolder; Voltage Rating 50V; Mouser Part Number 581-KGM15BR71H104JT
Q1: BSC059N04LS6; Infineon_PG-TDSON-8_6.15x5.15mm; Mouser Part Number 726-BSC059N04LS6ATMA
R10: 0; R_0603_1608Metric_Pad0.98x0.95mm_HandSolder; Mouser Part Number 660-RK73Z1JTTDD
U1: LM74700; SOT-23-6_Handsoldering; Mouser Part Number 595-LM74700QDBVRQ1

Connections:
/+4.4V_{SCAP}_OUT: C2.1, Q1.5 (D), U1.4 (CATHODE); also elsewhere on the board
/+6V_{SCAP}_IN: C1.1, C3.1, Q1.1 (S), Q1.2 (S), Q1.3 (S), R10.2, U1.6 (ANODE); also elsewhere on the board
/Ideal Diode/EN: R10.1, U1.3 (EN)
/Ideal Diode/GATE: Q1.4 (G), U1.5 (GATE)
/Ideal Diode/VCAP: C3.2, U1.1 (VCAP)
GNDPWR: C1.2, C2.2, U1.2 (GND); also elsewhere on the board

Notes on the sheet:
Input: - +24V (Chassis) and GND (Chassis) - Enable (active high & low) - from current sense (high/low when overcurrenting)
Ideal diode controller
Output: - +24V (Chassis) and GND (Chassis) - Buck/charger enable - Boost enable
TODO: - Include an ideal diode controller (e.g. the LM74700-Q1) - To prevent backwards current flow into PMM - VSense to determine if the PMM has cut power to the chassis and should not discharge power

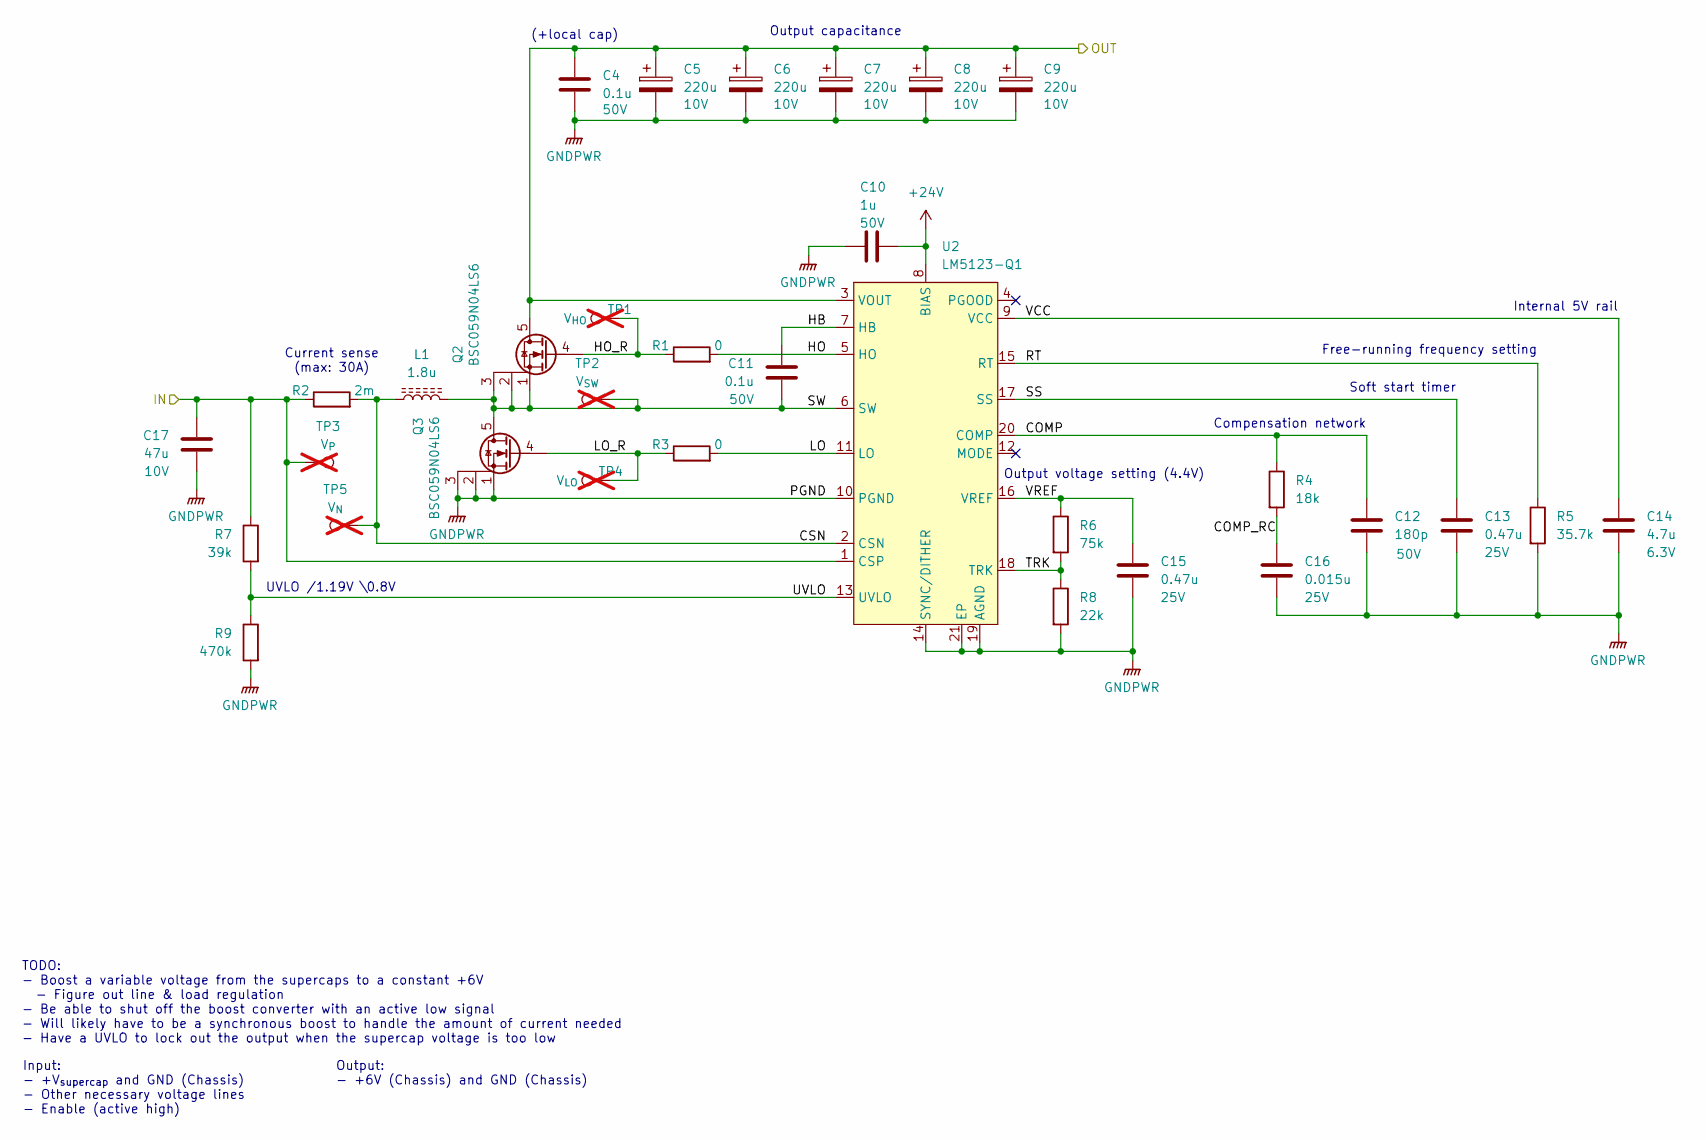
[picture p32: schematic boost.kicad_sch, Output Boost (Stage 1)]

Parts:
C4, C11: 0.1u; C_0603_1608Metric_Pad1.08x0.95mm_HandSolder; Voltage Rating 50V; Mouser Part Number 581-KGM15BR71H104JT
C5, C6, C7, C8, C9: 220u; CP_Radial_D6.3mm_P2.50mm; Voltage Rating 10V; Mouser Part Number 80-A750EK227M1AAAE18
C10: 1u; C_0603_1608Metric_Pad1.08x0.95mm_HandSolder; Voltage Rating 50V; Mouser Part Number 963-UMK107BJ105KA-T
C12: 180p; C_0603_1608Metric_Pad1.08x0.95mm_HandSolder; Voltage Rating 50V; Mouser Part Number 603-CC603JPNPO9BN181
C13, C15: 0.47u; C_0603_1608Metric_Pad1.08x0.95mm_HandSolder; Voltage Rating 25V; Mouser Part Number 710-885012106020
C14: 4.7u; C_0603_1608Metric_Pad1.08x0.95mm_HandSolder; Voltage Rating 6.3V; Mouser Part Number 187-CL10A475KQ8NNWC
C16: 0.015u; C_0603_1608Metric_Pad1.08x0.95mm_HandSolder; Voltage Rating 25V; Mouser Part Number 77-VJ0603Y153KXXCBC
C17: 47u; C_1206_3216Metric_Pad1.33x1.80mm_HandSolder; Voltage Rating 10V; Mouser Part Number 81-GRM31CR61A476ME5K
L1: 1.8u; L_Bourns_SRP1245A; Mouser Part Number 652-SRP1265A-1R8M
Q2, Q3: BSC059N04LS6; Infineon_PG-TDSON-8_6.15x5.15mm; Mouser Part Number 726-BSC059N04LS6ATMA
R1, R3: 0; R_0603_1608Metric_Pad0.98x0.95mm_HandSolder; Mouser Part Number 660-RK73Z1JTTDD
R2: 2m; R_2512_6332Metric_Pad1.40x3.35mm_HandSolder; Mouser Part Number 652-CRF2512FZR002ELF
R4: 18k; R_0603_1608Metric_Pad0.98x0.95mm_HandSolder; Mouser Part Number 603-RT0603FRE1318KL
R5: 35.7k; R_0603_1608Metric_Pad0.98x0.95mm_HandSolder; Mouser Part Number 603-RC0603FR-0735K7L
R6: 75k; R_0603_1608Metric_Pad0.98x0.95mm_HandSolder; Mouser Part Number 03-AC0603FR-1075KL
R7: 39k; R_0603_1608Metric_Pad0.98x0.95mm_HandSolder; Mouser Part Number 603-RC0603FR-1339KL
R8: 22k; R_0603_1608Metric_Pad0.98x0.95mm_HandSolder; Mouser Part Number 71-CRCW0603-22K-E3
R9: 470k; R_0603_1608Metric_Pad0.98x0.95mm_HandSolder; Mouser Part Number 660-RN73R1JTD4703B25
TP1: V_{HO}; TestPoint_Pad_1.0x1.0mm; not fitted
TP2: V_{SW}; TestPoint_Pad_1.0x1.0mm; not fitted
TP3: V_{P}; TestPoint_Bridge_Pitch2.0mm_Drill0.7mm; not fitted
TP4: V_{LO}; TestPoint_Pad_1.0x1.0mm; not fitted
TP5: V_{N}; TestPoint_Bridge_Pitch2.0mm_Drill0.7mm; not fitted
U2: LM5123-Q1; Texas_RGP0020H_VQFN-20-1EP_4x4mm_P0.5mm_EP2.4x2.4mm; Mouser Part Number 595-LM51231QRGRRQ1

Connections:
+24V: C10.2, U2.8 (BIAS); also elsewhere on the board
/+4.4V_{SCAP}_OUT: C4.1, C5.1, C6.1, C7.1, C8.1, C9.1, Q2.5 (D), U2.3 (VOUT); also elsewhere on the board
/+6V_{SCAP}_IN: C17.1, R2.1, R7.1, TP3.1, U2.1 (CSP); also elsewhere on the board
/Output Boost (Stage 1)/COMP: C12.1, R4.1, U2.20 (COMP)
/Output Boost (Stage 1)/COMP_RC: C16.1, R4.2
/Output Boost (Stage 1)/CSN: L1.1, R2.2, TP5.1, U2.2 (CSN)
/Output Boost (Stage 1)/HB: C11.1, U2.7 (HB)
/Output Boost (Stage 1)/HO: R1.2, U2.5 (HO)
/Output Boost (Stage 1)/HO_R: Q2.4 (G), R1.1, TP1.1
/Output Boost (Stage 1)/LO: R3.2, U2.11 (LO)
/Output Boost (Stage 1)/LO_R: Q3.4 (G), R3.1, TP4.1
/Output Boost (Stage 1)/RT: R5.1, U2.15 (RT)
/Output Boost (Stage 1)/SS: C13.1, U2.17 (SS)
/Output Boost (Stage 1)/SW: C11.2, L1.2, Q2.1 (S), Q2.2 (S), Q2.3 (S), Q3.5 (D), TP2.1, U2.6 (SW)
/Output Boost (Stage 1)/TRK: R6.2, R8.1, U2.18 (TRK)
/Output Boost (Stage 1)/UVLO: R7.2, R9.1, U2.13 (UVLO)
/Output Boost (Stage 1)/VCC: C14.1, U2.9 (VCC)
/Output Boost (Stage 1)/VREF: C15.1, R6.1, U2.16 (VREF)
GNDPWR: C4.2, C5.2, C6.2, C7.2, C8.2, C9.2, C10.1, C12.2, C13.2, C14.2, C15.2, C16.2, C17.2, Q3.1 (S), Q3.2 (S), Q3.3 (S), R5.2, R8.2, R9.2, U2.10 (PGND), U2.14 (SYNC/DITHER), U2.19 (AGND), U2.21 (EP); also elsewhere on the board

Notes on the sheet:
UVLO /1.19V \0.8V
Output voltage setting (4.4V)
Free-running frequency setting
Current sense (max: 30A)
Soft start timer
Compensation network
TODO: - Boost a variable voltage from the supercaps to a constant +6V - Figure out line & load regulation - Be able to shut off the boost converter with an active low signal - Will likely have to be a synchronous boost to handle the amount of current needed - Have a UVLO to lock out the output when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
Output: - +6V (Chassis) and GND (Chassis)
(+local cap)
Internal 5V rail
Output capacitance
Input: - +V_{supercap} and GND (Chassis) - Other necessary voltage lines - Enable (active high)

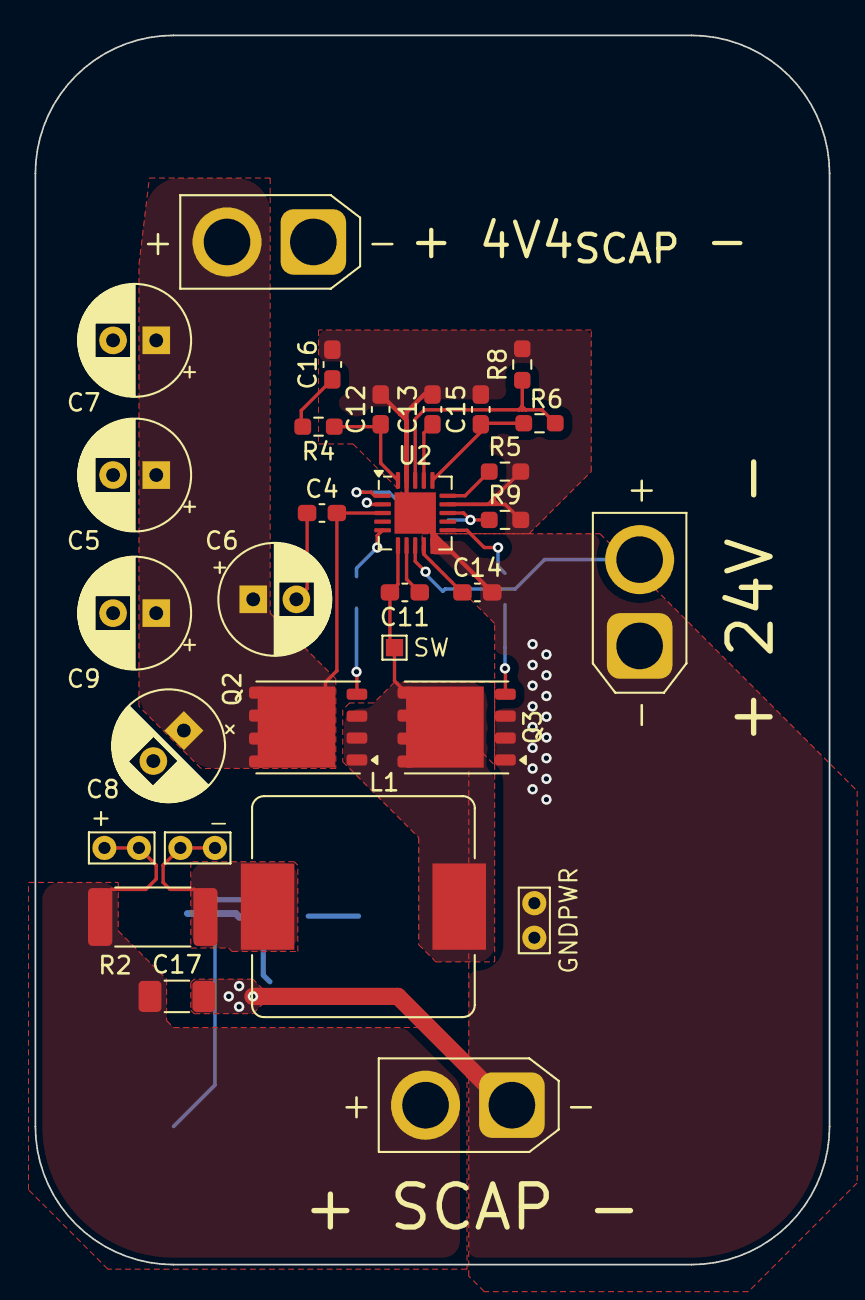
[picture p33: board Boost1 1B.kicad_pcb from above]

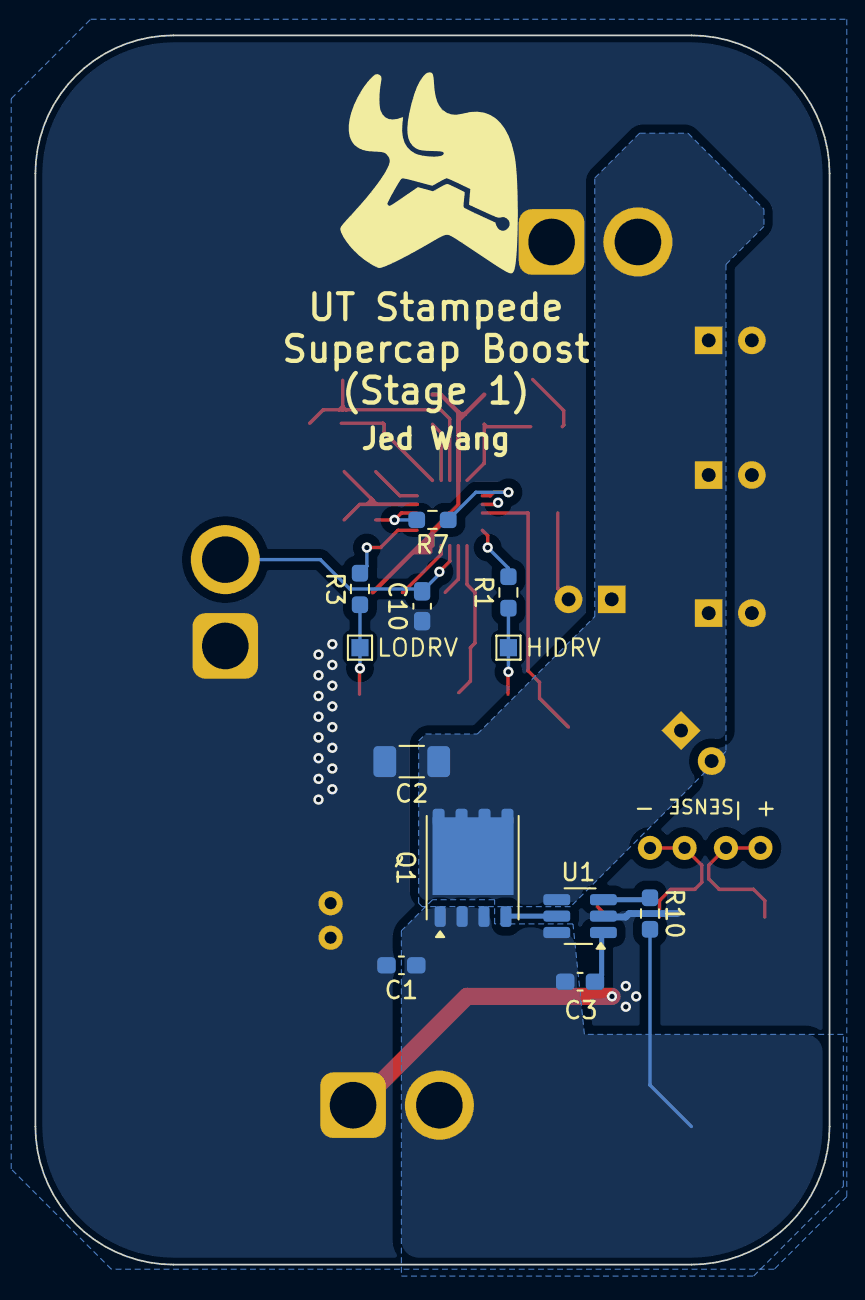
[picture p34: board Boost1 1B.kicad_pcb from below]

Board: 4 copper layers, 46.0 x 71.2 mm, 42 parts (12 on the bottom side), 22 nets.
