ut-ras/rm_electrical-supercap/Rev 1B Boards/Housekeeping 1B/Housekeeping 1B.kicad_pcb

## KiCad design Rev 1B Boards/Housekeeping 1B/Housekeeping 1B.kicad_pcb (2025-05-29)

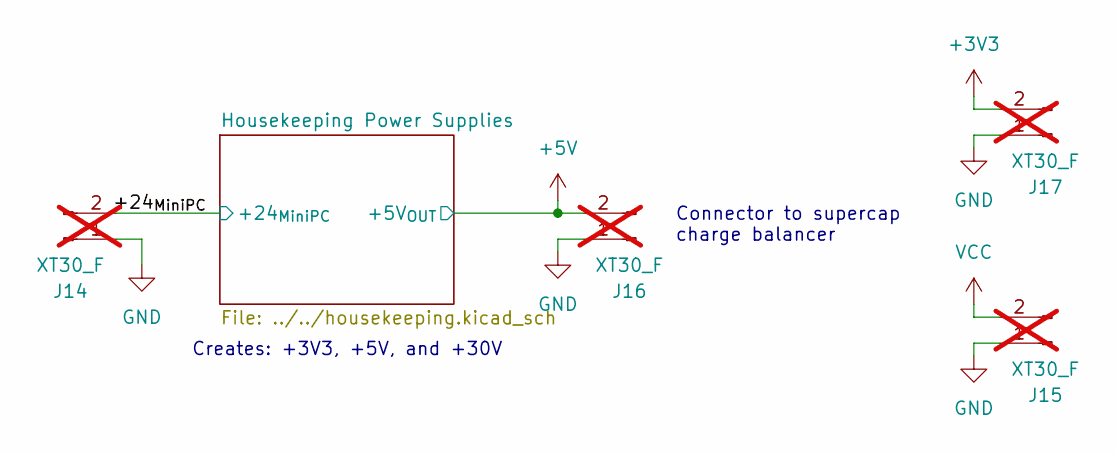
[picture p35: schematic Housekeeping 1B.kicad_sch, Housekeeping Power Supplies Test Board]

Parts:
J14, J15, J16, J17: XT30_F; AMASS_XT30U-F_1x02_P5.0mm_Vertical; not fitted

Connections:
+3V3: J17.2; also elsewhere on the board
+5V: J16.2; also elsewhere on the board
/+24_{MiniPC}: J14.2; also elsewhere on the board
GND: J14.1, J15.1, J16.1, J17.1; also elsewhere on the board
VCC: J15.2; also elsewhere on the board

Notes on the sheet:
Creates: +3V3, +5V, and +30V
Connector to supercap charge balancer

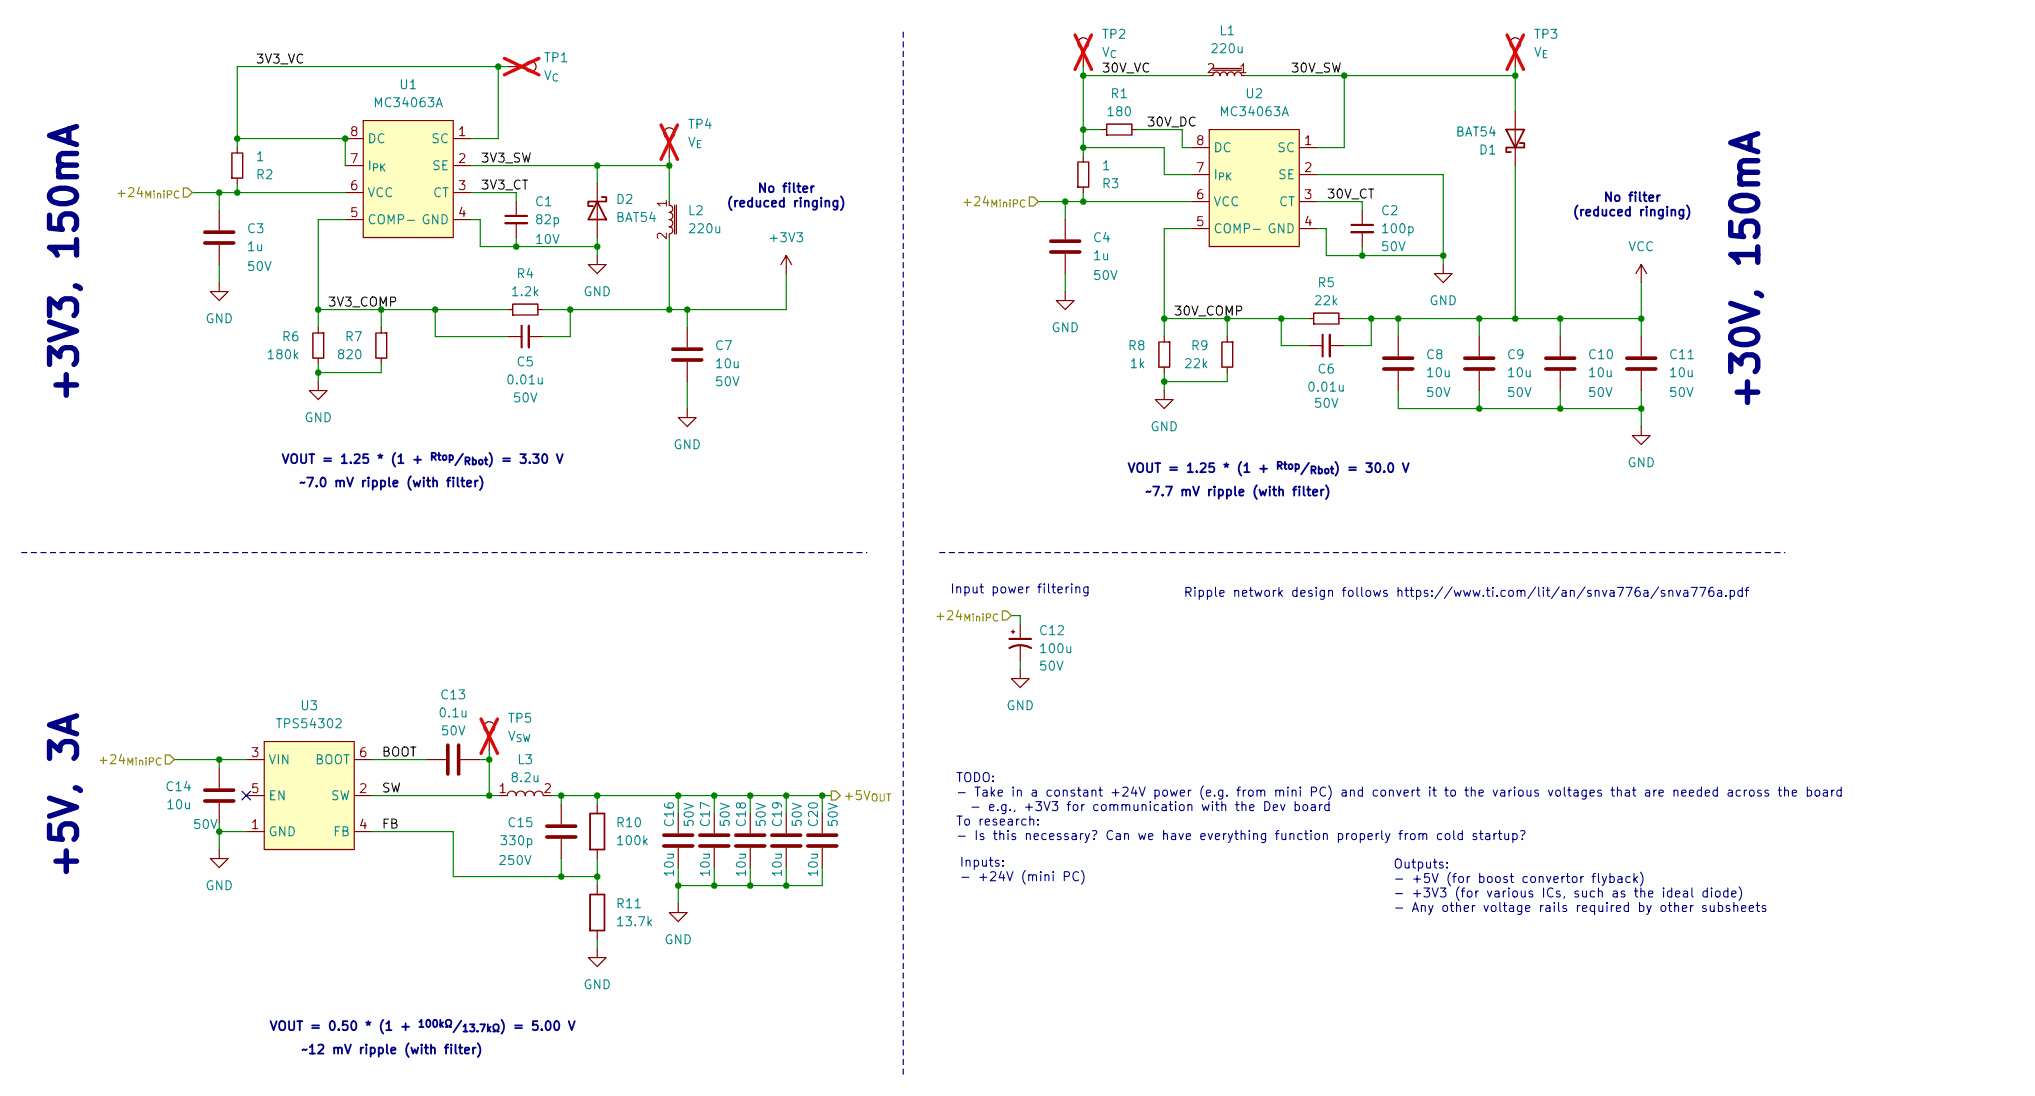
[picture p36: schematic housekeeping.kicad_sch, Housekeeping Power Supplies]

Parts:
C1: 82p; C_0603_1608Metric_Pad1.08x0.95mm_HandSolder; Voltage Rating 10V; Mouser Part Number 791-0603N820J100CT
C2: 100p; C_0603_1608Metric_Pad1.08x0.95mm_HandSolder; Voltage Rating 50V; Mouser Part Number 77-VJ0603A101KXACBC
C3, C4: 1u; C_0603_1608Metric_Pad1.08x0.95mm_HandSolder; Voltage Rating 50V; Mouser Part Number 963-UMK107BJ105KA-T
C5, C6: 0.01u; C_0603_1608Metric_Pad1.08x0.95mm_HandSolder; Voltage Rating 50V; Mouser Part Number 187-CL10B103KC8NNNC
C7, C8, C9, C10, C11, C14, C16, C17, C18, C19, C20: 10u; C_1206_3216Metric_Pad1.33x1.80mm_HandSolder; Voltage Rating 50V; Mouser Part Number 187-CL31A106KBHNNNE
C12: 100u; CP_Radial_D8.0mm_P3.50mm; Voltage Rating 50V; Mouser Part Number 710-860010674014
C13: 0.1u; C_0603_1608Metric_Pad1.08x0.95mm_HandSolder; Voltage Rating 50V; Mouser Part Number 581-KGM15BR71H104JT
C15: 330p; C_0603_1608Metric_Pad1.08x0.95mm_HandSolder; Voltage Rating 250V; Mouser Part Number 791-0805N331J251CT
D1, D2: BAT54; SOT-23_Handsoldering; Mouser Part Number 241-BAT54_R1_00001
L1, L2: 220u; ASPIAIGS6055221MT; Mouser Part Number 815-ASPIAIGS6055221T
L3: 8.2u; L_10.4x10.4_H4.8; Mouser Part Number 704-DR1050-8R2-R
R1: 180; R_0805_2012Metric_Pad1.20x1.40mm_HandSolder; Mouser Part Number 667-ERJ-P06J181V
R2, R3: 1; R_0603_1608Metric_Pad0.98x0.95mm_HandSolder; Mouser Part Number 652-CR0603-F/1R00ELF
R4: 1.2k; R_0603_1608Metric_Pad0.98x0.95mm_HandSolder; Mouser Part Number 603-RT0603DRD071K2L
R5, R9: 22k; R_0603_1608Metric_Pad0.98x0.95mm_HandSolder; Mouser Part Number 71-CRCW0603-22K-E3
R6: 180k; R_0603_1608Metric_Pad0.98x0.95mm_HandSolder; Mouser Part Number 603-RT0603DRE07180KL
R7: 820; R_0603_1608Metric_Pad0.98x0.95mm_HandSolder; Mouser Part Number 667-ERA-3AEB821V
R8: 1k; R_0603_1608Metric_Pad0.98x0.95mm_HandSolder; Mouser Part Number 660-RN73R1JTD1001F50
R10: 100k; R_0603_1608Metric_Pad0.98x0.95mm_HandSolder; Mouser Part Number 660-RN73H1JTD1003D25
R11: 13.7k; R_0603_1608Metric_Pad0.98x0.95mm_HandSolder; Mouser Part Number 603-AC0603FR-0713K7L
TP1, TP2: V_{C}; TestPoint_Bridge_Pitch2.0mm_Drill0.7mm; not fitted
TP3, TP4: V_{E}; TestPoint_Pad_1.0x1.0mm; not fitted
TP5: V_{SW}; TestPoint_Bridge_Pitch2.0mm_Drill0.7mm; not fitted
U1, U2: MC34063A; SOIC-8_3.9x4.9mm_P1.27mm; Mouser Part Number 595-MC34063ADR
U3: TPS54302; SOT-23-6_Handsoldering; Mouser Part Number 595-TPS54302DDCR

Connections:
+3V3: C5.2, C7.1, L2.2, R4.2; also elsewhere on the board
+5V: C15.1, C16.1, C17.1, C18.1, C19.1, C20.1, L3.2, R10.1; also elsewhere on the board
/+24_{MiniPC}: C3.1, C4.1, C12.1, C14.1, R2.1, R3.1, U1.6 (VCC), U2.6 (VCC), U3.3 (VIN); also elsewhere on the board
/Housekeeping Power Supplies/3V3_COMP: C5.1, R4.1, R6.1, R7.1, U1.5 (COMP-)
/Housekeeping Power Supplies/3V3_CT: C1.1, U1.3 (CT)
/Housekeeping Power Supplies/3V3_SW: D2.3 (K), L2.1, TP4.1, U1.2 (SE)
/Housekeeping Power Supplies/3V3_VC: R2.2, TP1.1, U1.1 (SC), U1.7 (I_{PK}), U1.8 (DC)
/Housekeeping Power Supplies/30V_COMP: C6.1, R5.1, R8.1, R9.1, U2.5 (COMP-)
/Housekeeping Power Supplies/30V_CT: C2.1, U2.3 (CT)
/Housekeeping Power Supplies/30V_DC: R1.2, U2.8 (DC)
/Housekeeping Power Supplies/30V_SW: D1.1 (A), L1.1, TP3.1, U2.1 (SC)
/Housekeeping Power Supplies/30V_VC: L1.2, R1.1, R3.2, TP2.1, U2.7 (I_{PK})
/Housekeeping Power Supplies/BOOT: C13.1, U3.6 (BOOT)
/Housekeeping Power Supplies/FB: C15.2, R10.2, R11.1, U3.4 (FB)
/Housekeeping Power Supplies/SW: C13.2, L3.1, TP5.1, U3.2 (SW)
GND: C1.2, C2.2, C3.2, C4.2, C7.2, C8.2, C9.2, C10.2, C11.2, C12.2, C14.2, C16.2, C17.2, C18.2, C19.2, C20.2, D2.1 (A), R6.2, R7.2, R8.2, R9.2, R11.2, U1.4 (GND), U2.2 (SE), U2.4 (GND), U3.1 (GND); also elsewhere on the board
VCC: C6.2, C8.1, C9.1, C10.1, C11.1, D1.3 (K), R5.2; also elsewhere on the board

Notes on the sheet:
~12 mV ripple (with filter)
+5V, 3A
+3V3, 150mA
No filter (reduced ringing)
Outputs: - +5V (for boost convertor flyback) - +3V3 (for various ICs, such as the ideal diode) - Any other voltage rails required by other subsheets
VOUT = 1.25 * (1 + ^{Rtop}/_{Rbot}) = 30.0 V
Inputs: - +24V (mini PC)
~7.7 mV ripple (with filter)
TODO: - Take in a constant +24V power (e.g. from mini PC) and convert it to the various voltages that are needed across the board - e.g., +3V3 for communication with the Dev board To research: - Is this necessary? Can we have everything function properly from cold startup?
~7.0 mV ripple (with filter)
Ripple network design follows https://www.ti.com/lit/an/snva776a/snva776a.pdf
Input power filtering
VOUT = 1.25 * (1 + ^{Rtop}/_{Rbot}) = 3.30 V
VOUT = 0.50 * (1 + ^{100kΩ}/_{13.7kΩ}) = 5.00 V
+30V, 150mA

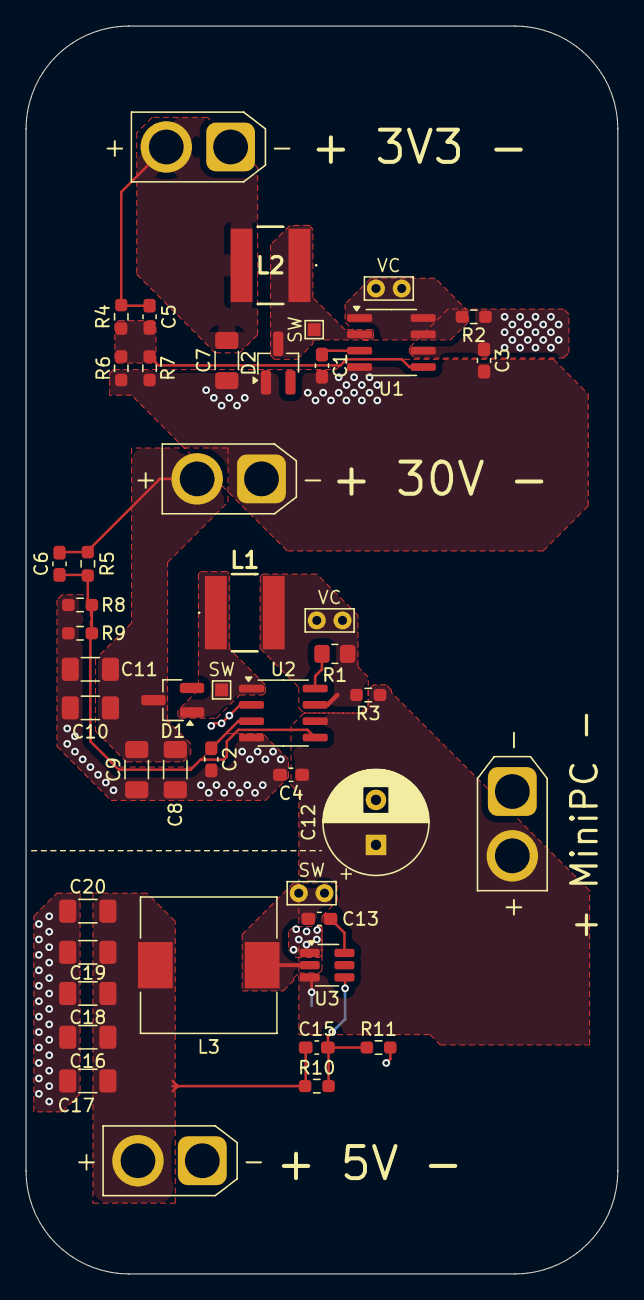
[picture p37: board Housekeeping 1B.kicad_pcb from above]

Board: 4 copper layers, 46.0 x 97.0 mm, 48 parts (1 on the bottom side), 17 nets.
