ut-ras/rm_electrical-supercap/Rev 1B Boards/Boost2 1B/Boost2 1B.kicad_pcb

## KiCad design Rev 1B Boards/Boost2 1B/Boost2 1B.kicad_pcb (2025-05-29)

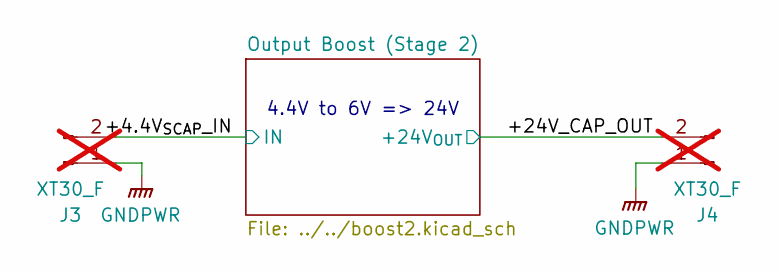
[picture p38: schematic Boost2 1B.kicad_sch, Boost (Stage 2) Test Board]

Parts:
J3, J4: XT30_F; AMASS_XT30U-F_1x02_P5.0mm_Vertical; not fitted

Connections:
/+4.4V_{SCAP}_IN: J3.2; also elsewhere on the board
/+24V_CAP_OUT: J4.2; also elsewhere on the board
GNDPWR: J3.1, J4.1; also elsewhere on the board

Notes on the sheet:
4.4V to 6V => 24V

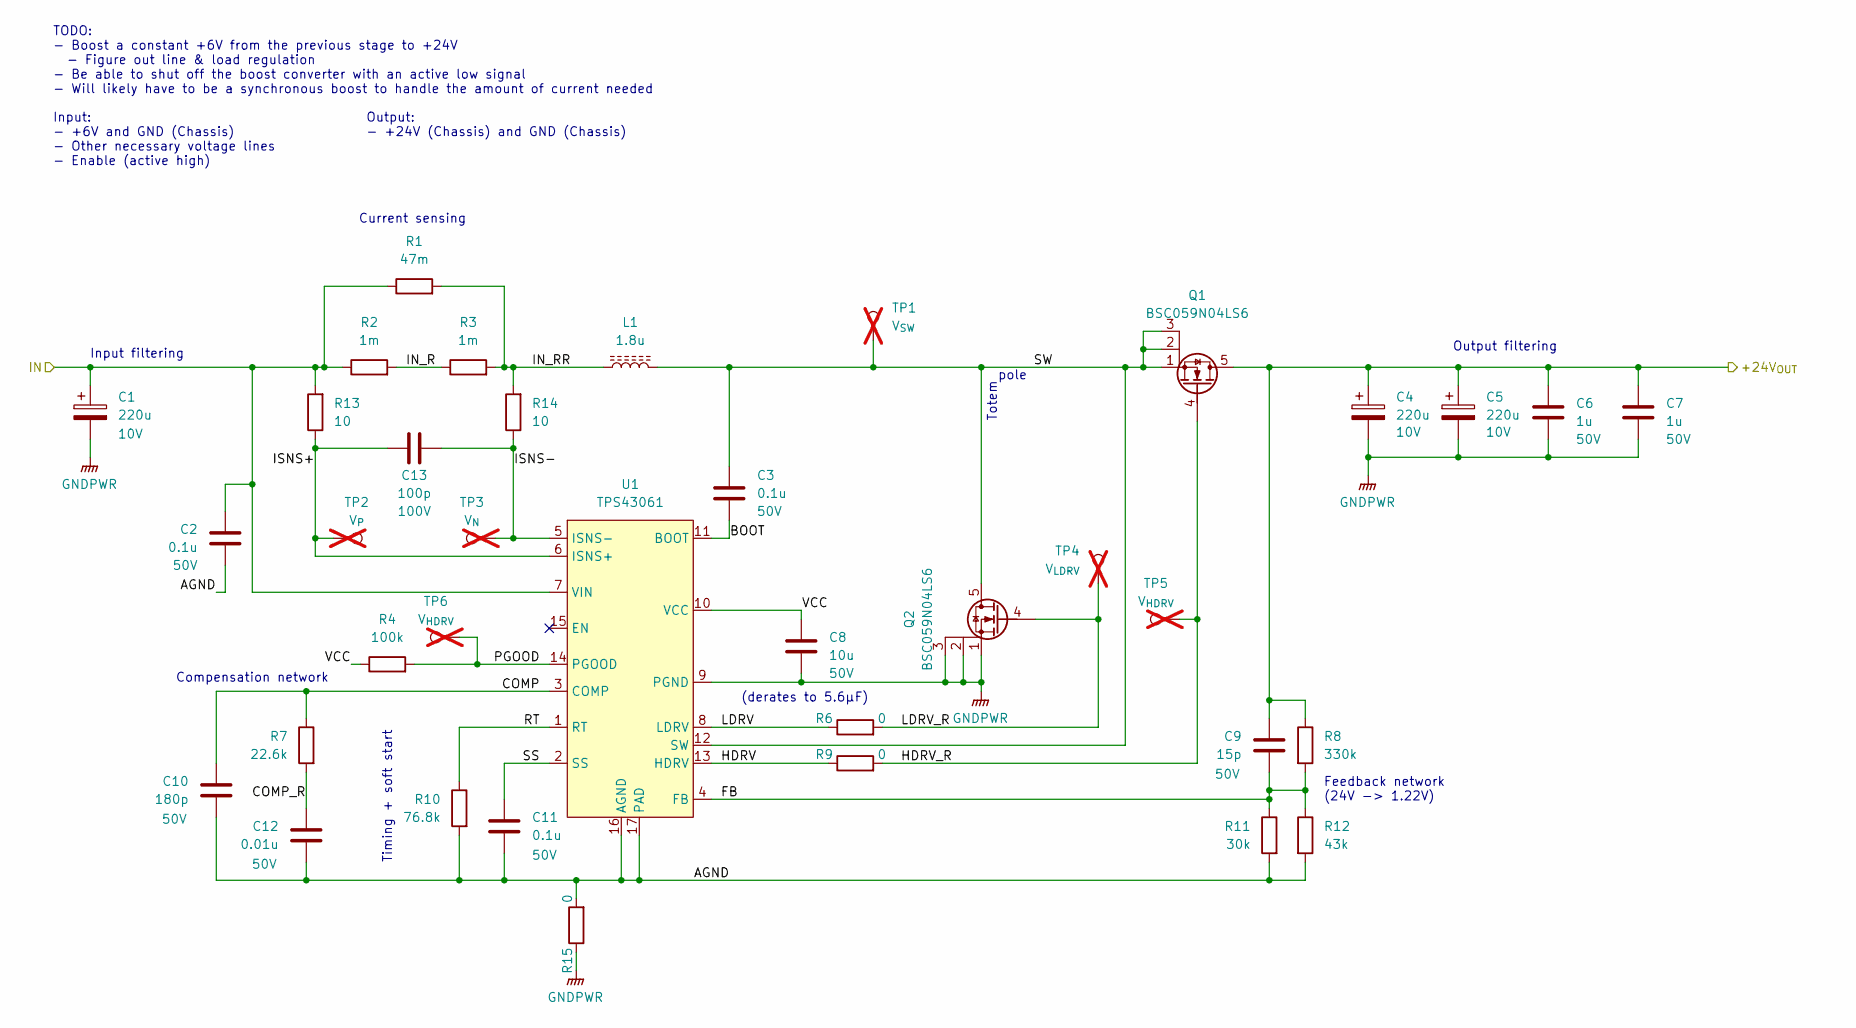
[picture p39: schematic boost2.kicad_sch, Output Boost (Stage 2)]

Parts:
C1, C4, C5: 220u; CP_Radial_D6.3mm_P2.50mm; Voltage Rating 10V; Mouser Part Number 80-A750EK227M1AAAE18
C2, C3, C11: 0.1u; C_0603_1608Metric_Pad1.08x0.95mm_HandSolder; Voltage Rating 50V; Mouser Part Number 581-KGM15BR71H104JT
C6, C7: 1u; C_0603_1608Metric_Pad1.08x0.95mm_HandSolder; Voltage Rating 50V; Mouser Part Number 963-UMK107BJ105KA-T
C8: 10u; C_1206_3216Metric_Pad1.33x1.80mm_HandSolder; Voltage Rating 50V; Mouser Part Number 187-CL31A106KBHNNNE
C9: 15p; C_0603_1608Metric_Pad1.08x0.95mm_HandSolder; Voltage Rating 50V; Mouser Part Number 791-0603N150F500CT
C10: 180p; C_0603_1608Metric_Pad1.08x0.95mm_HandSolder; Voltage Rating 50V; Mouser Part Number 603-CC603JPNPO9BN181
C12: 0.01u; C_0603_1608Metric_Pad1.08x0.95mm_HandSolder; Voltage Rating 50V; Mouser Part Number 187-CL10B103KC8NNNC
C13: 100p; C_0603_1608Metric_Pad1.08x0.95mm_HandSolder; Voltage Rating 100V; Mouser Part Number 187-CL10C101JC8NNWC
L1: 1.8u; L_Bourns_SRP1245A; Mouser Part Number 652-SRP1265A-1R8M
Q1, Q2: BSC059N04LS6; Infineon_PG-TDSON-8_6.15x5.15mm; Mouser Part Number 726-BSC059N04LS6ATMA
R1: 47m; R_1206_3216Metric_Pad1.30x1.75mm_HandSolder; Mouser Part Number 603-PE1206FRE470R47L
R2, R3: 1m; R_0612_1632Metric_Pad1.18x3.40mm_HandSolder; Mouser Part Number 71-WFCP06121L000FE66
R4: 100k; R_0603_1608Metric_Pad0.98x0.95mm_HandSolder; Mouser Part Number 660-RN73H1JTD1003D25
R6, R9, R15: 0; R_0603_1608Metric_Pad0.98x0.95mm_HandSolder; Mouser Part Number 660-RK73Z1JTTDD
R7: 22.6k; R_0603_1608Metric_Pad0.98x0.95mm_HandSolder; Mouser Part Number 603-RC0603FR-0722K6L
R8: 330k; R_0603_1608Metric_Pad0.98x0.95mm_HandSolder; Mouser Part Number 603-RT0603DRD07330KL
R10: 76.8k; R_0603_1608Metric_Pad0.98x0.95mm_HandSolder; Mouser Part Number 660-RN73H1JTD7682B25
R11: 30k; R_0603_1608Metric_Pad0.98x0.95mm_HandSolder; Mouser Part Number 660-RN73H1JTD3002B50
R12: 43k; R_0603_1608Metric_Pad0.98x0.95mm_HandSolder; Mouser Part Number 603-RT0603DRD0743KL
R13, R14: 10; R_0603_1608Metric_Pad0.98x0.95mm_HandSolder; Mouser Part Number 594-MCT06030C1009FP5
TP1: V_{SW}; TestPoint_Bridge_Pitch2.0mm_Drill0.7mm; not fitted
TP2: V_{P}; TestPoint_Pad_1.0x1.0mm; not fitted
TP3: V_{N}; TestPoint_Pad_1.0x1.0mm; not fitted
TP4: V_{LDRV}; TestPoint_Pad_1.0x1.0mm; not fitted
TP5: V_{HDRV}; TestPoint_Pad_1.0x1.0mm; not fitted
TP6: V_{HDRV}; TestPoint_Bridge_Pitch2.0mm_Drill0.7mm; not fitted
U1: TPS43061; Texas_S-PWQFN-N16; Mouser Part Number 595-TPS43061RTER

Connections:
/+4.4V_{SCAP}_IN: C1.1, C2.1, R1.1, R2.1, R13.2, U1.7 (VIN); also elsewhere on the board
/+24V_CAP_OUT: C4.1, C5.1, C6.1, C7.1, C9.1, Q1.5 (D), R8.1; also elsewhere on the board
/Output Boost (Stage 2)/AGND: C2.2, C10.2, C11.2, C12.2, R10.2, R11.2, R12.2, R15.2, U1.16 (AGND), U1.17 (PAD)
/Output Boost (Stage 2)/BOOT: C3.2, U1.11 (BOOT)
/Output Boost (Stage 2)/COMP: C10.1, R7.1, U1.3 (COMP)
/Output Boost (Stage 2)/COMP_R: C12.1, R7.2
/Output Boost (Stage 2)/FB: C9.2, R8.2, R11.1, R12.1, U1.4 (FB)
/Output Boost (Stage 2)/HDRV: R9.1, U1.13 (HDRV)
/Output Boost (Stage 2)/HDRV_R: Q1.4 (G), R9.2, TP5.1
/Output Boost (Stage 2)/IN_R: R2.2, R3.1
/Output Boost (Stage 2)/IN_RR: L1.1, R1.2, R3.2, R14.2
/Output Boost (Stage 2)/ISNS+: C13.1, R13.1, TP2.1, U1.6 (ISNS+)
/Output Boost (Stage 2)/ISNS-: C13.2, R14.1, TP3.1, U1.5 (ISNS-)
/Output Boost (Stage 2)/LDRV: R6.1, U1.8 (LDRV)
/Output Boost (Stage 2)/LDRV_R: Q2.4 (G), R6.2, TP4.1
/Output Boost (Stage 2)/PGOOD: R4.2, TP6.1, U1.14 (PGOOD)
/Output Boost (Stage 2)/RT: R10.1, U1.1 (RT)
/Output Boost (Stage 2)/SS: C11.1, U1.2 (SS)
/Output Boost (Stage 2)/SW: C3.1, L1.2, Q1.1 (S), Q1.2 (S), Q1.3 (S), Q2.5 (D), TP1.1, U1.12 (SW)
/Output Boost (Stage 2)/VCC: C8.1, R4.1, U1.10 (VCC)
GNDPWR: C1.2, C4.2, C5.2, C6.2, C7.2, C8.2, Q2.1 (S), Q2.2 (S), Q2.3 (S), R15.1, U1.9 (PGND); also elsewhere on the board

Notes on the sheet:
Input: - +6V and GND (Chassis) - Other necessary voltage lines - Enable (active high)
Timing + soft start
Compensation network
Output: - +24V (Chassis) and GND (Chassis)
Input filtering
Current sensing
pole
Feedback network (24V -> 1.22V)
(derates to 5.6µF)
TODO: - Boost a constant +6V from the previous stage to +24V - Figure out line & load regulation - Be able to shut off the boost converter with an active low signal - Will likely have to be a synchronous boost to handle the amount of current needed
Output filtering
Totem
