ut-ras/rm_electrical-supercap/Rev 1B Boards/Boost2 1B/Boost2 1B.kicad_pcb

## KiCad design Rev 1B Boards/Boost2 1B/Boost2 1B.kicad_pcb (continued)

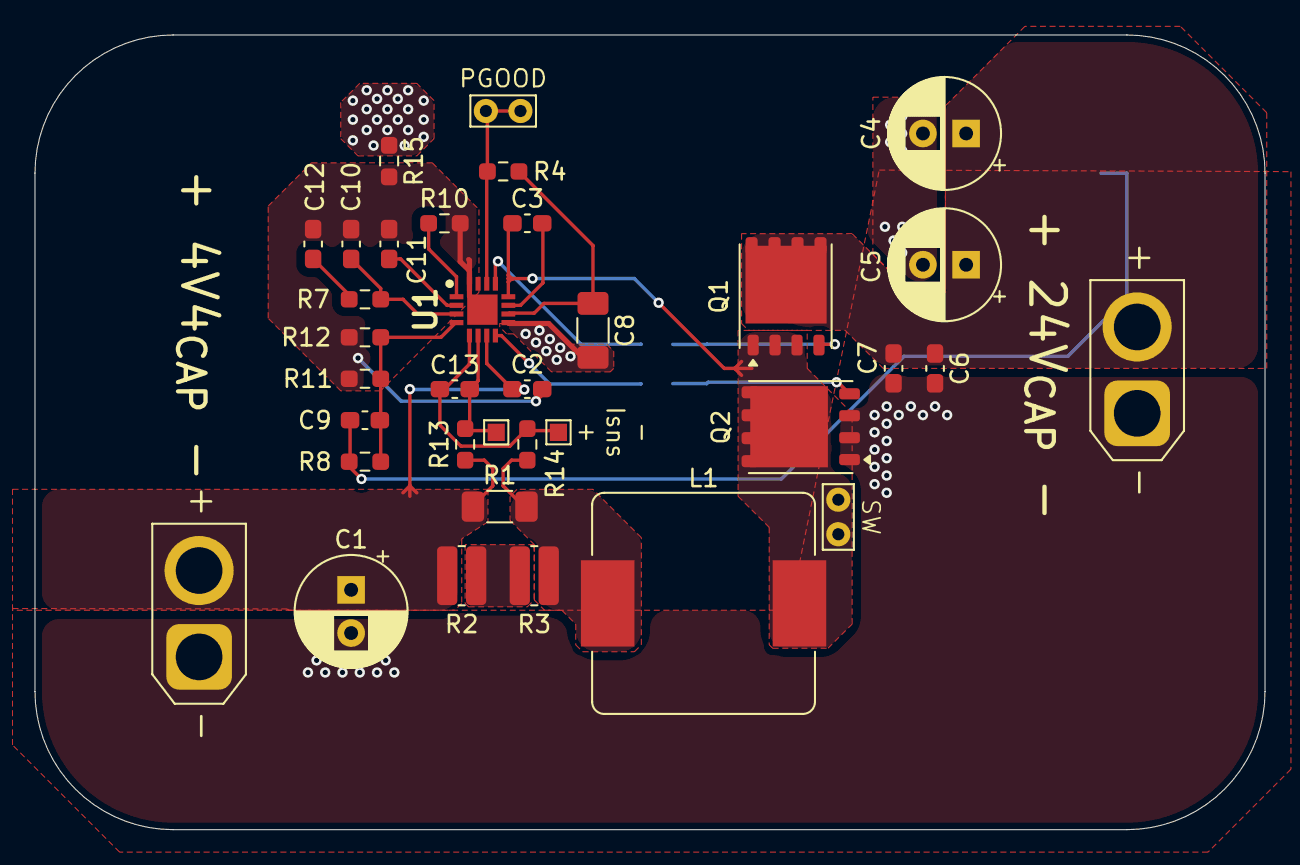
[picture p40: board Boost2 1B.kicad_pcb from above]

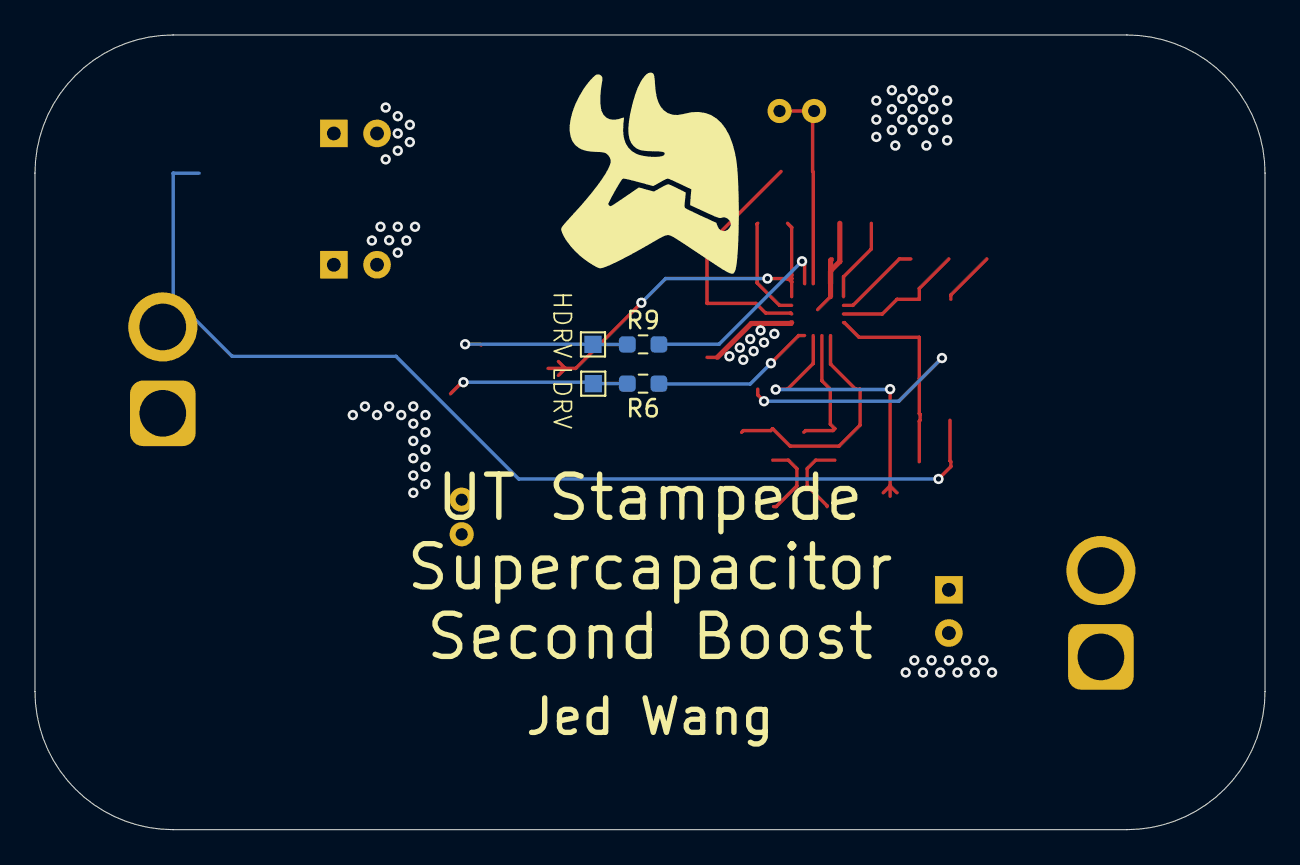
[picture p41: board Boost2 1B.kicad_pcb from below]

Board: 4 copper layers, 71.2 x 46.0 mm, 39 parts (4 on the bottom side), 21 nets.
