ut-ras/rm_electrical-supercap/Rev 1B Boards/SupercapHost 1B/SupercapHost 1B.kicad_pcb

## KiCad design Rev 1B Boards/SupercapHost 1B/SupercapHost 1B.kicad_pcb (2025-05-28)

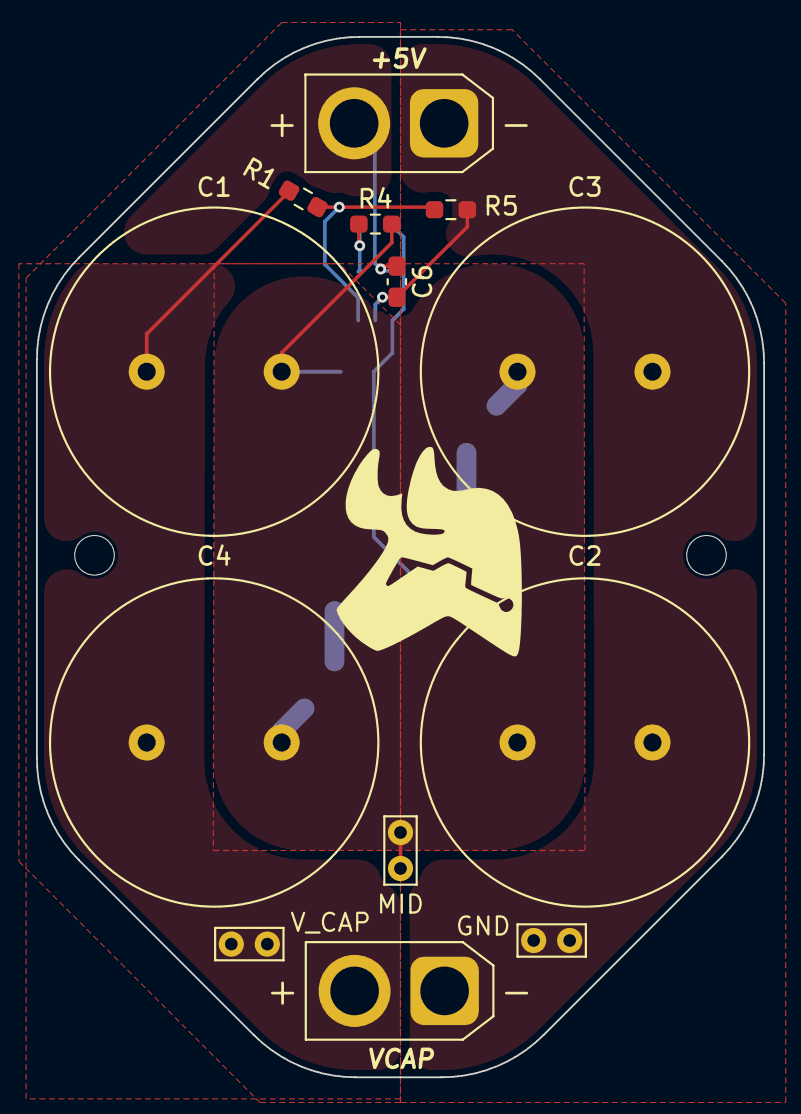
[picture p42: board SupercapHost 1B.kicad_pcb from above]

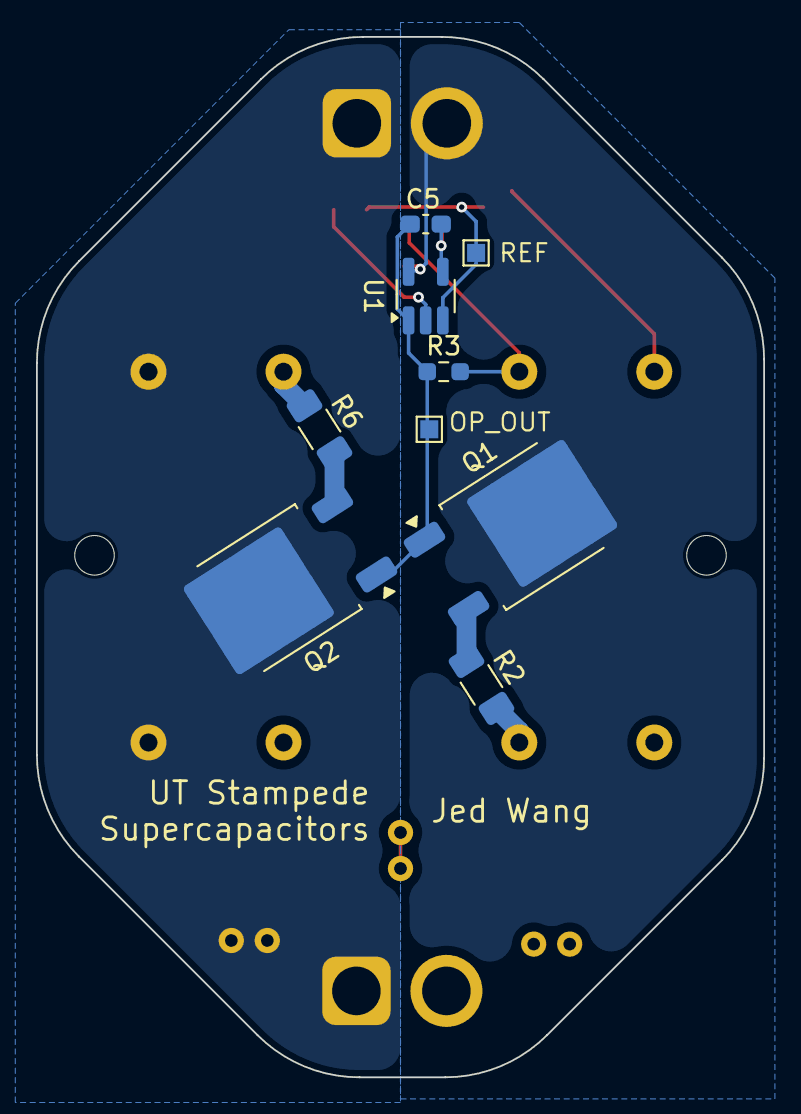
[picture p43: board SupercapHost 1B.kicad_pcb from below]

Board: 2 copper layers, 40.4 x 57.8 mm, 22 parts (9 on the bottom side), 9 nets.

Parts:
C1, C2, C3, C4: 110; C_Radial_D18.0mm_H35.5mm_P7.50mm
C5: 100p; C_0603_1608Metric_Pad1.08x0.95mm_HandSolder
C6: 0.1u; C_0603_1608Metric_Pad1.08x0.95mm_HandSolder
J1, J2: XT30_F; AMASS_XT30U-F_1x02_P5.0mm_Vertical
Q1: 2SCR587D3; TO-252-2
Q2: 2SAR587D3; TO-252-2
R1, R5: 1Meg; R_0603_1608Metric_Pad0.98x0.95mm_HandSolder
R2, R6: 0.1; R_1206_3216Metric_Pad1.30x1.75mm_HandSolder
R3, R4: 100; R_0603_1608Metric_Pad0.98x0.95mm_HandSolder
TP1, TP4: TP; TestPoint_Pad_1.0x1.0mm
TP2, TP3, TP5: TP; TestPoint_Bridge_Pitch2.0mm_Drill0.7mm
U1: TLV9301xDBV; SOT-23-5_HandSoldering

Connections:
/Supercapacitors/LOWER_R: Q2.3 (E), R6.2
/Supercapacitors/MID: C1.2, C2.2, C3.1, C4.1, R2.2, R3.2, R4.1, R6.1, TP3.1
/Supercapacitors/OP_OUT: C5.2, Q1.1 (B), Q2.1 (B), R3.1, TP1.1, U1.1
/Supercapacitors/REF: R1.2, R5.1, TP4.1, U1.3 (+)
/Supercapacitors/UPPER_R: Q1.3 (E), R2.1
/Supercapacitors/V-: C5.1, R4.2, U1.4 (-)
/Supercapacitors/V_{CAP}: C1.1, C2.1, J1.2, R1.1, TP2.1
/Supercapacitors/V_{CC}: C6.1, J2.2, Q1.2 (C), U1.5 (V+)
GND1: C3.2, C4.2, C6.2, J1.1, J2.1, Q2.2 (C), R5.2, TP5.1, U1.2 (V-)
