ut-ras/rm_electrical-supercap/Rev 1 Boards/Ideal Diode Rev1/Ideal Diode Rev1.kicad_pcb

## KiCad design Rev 1 Boards/Ideal Diode Rev1/Ideal Diode Rev1.kicad_pcb (2025-05-26)

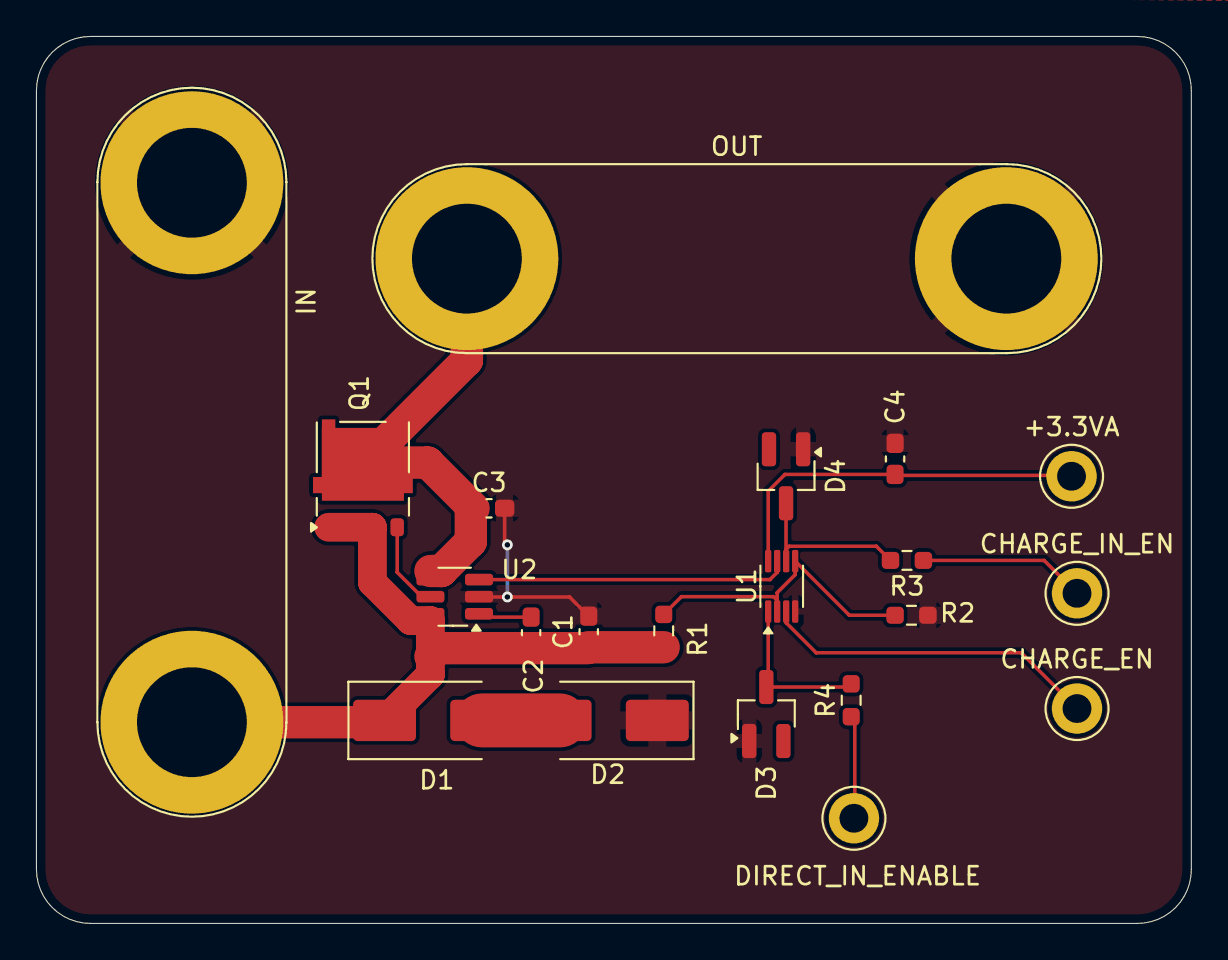
[picture p44: board Ideal Diode Rev1.kicad_pcb from above]

Board: 2 copper layers, 64.2 x 49.3 mm, 21 parts (0 on the bottom side), 14 nets.

Parts:
+3.3VA: TestPoint; TestPoint_Keystone_5010-5014_Multipurpose
C1: 0.022u; C_0603_1608Metric_Pad1.08x0.95mm_HandSolder
C2, C4: 0.1u; C_0603_1608Metric_Pad1.08x0.95mm_HandSolder
C3: 47u; C_0603_1608Metric_Pad1.08x0.95mm_HandSolder
CHARGE_EN: TestPoint; TestPoint_Keystone_5010-5014_Multipurpose
CHARGE_IN_EN: TestPoint; TestPoint_Keystone_5010-5014_Multipurpose
D1: SMBJ58A; D_SMB_Handsoldering
D2: SMBJ26A; D_SMB_Handsoldering
D3, D4: BAT54; SOT-23_Handsoldering
DIRECT_IN_ENABLE: TestPoint; TestPoint_Keystone_5010-5014_Multipurpose
IN: Conn_01x02_Socket; Banana_Jack_2Pin
OUT: Conn_01x02_Socket; Banana_Jack_2Pin
Q1: NVMFS5C404NL; ONSemi_SO-8FL_488AA
R1: 91k; R_0603_1608Metric_Pad0.98x0.95mm_HandSolder
R2: 13k; R_0603_1608Metric_Pad0.98x0.95mm_HandSolder
R3, R4: 1k; R_0603_1608Metric_Pad0.98x0.95mm_HandSolder
U1: SN74LVC2G08; VSSOP-8_2.3x2mm_P0.5mm
U2: LM74700; SOT-23-6_Handsoldering

Connections:
+3.3VA: +3.3VA.1, C4.1, U1.8 (VCC)
/Ideal Diode/CHARGING_EN: CHARGE_EN.1, U1.3
/Ideal Diode/CHARGING_IEN: CHARGE_IN_EN.1, R3.1
/Ideal Diode/C_CLIP: D4.3 (K), R3.2, U1.6
/Ideal Diode/DIRECT_EN: U1.7, U2.3 (EN)
/Ideal Diode/DIRECT_IEN: DIRECT_IN_ENABLE.1, R4.1
/Ideal Diode/D_CLIP: D3.3 (K), R4.2, U1.1
/Ideal Diode/GATE: Q1.4 (G), U2.5 (GATE)
/Ideal Diode/IN: C1.1, C2.1, D1.1 (K), IN.1, Q1.1 (S), Q1.2 (S), Q1.3 (S), R1.1, U2.6 (ANODE)
/Ideal Diode/OUT: C3.1, OUT.1, Q1.5 (D), U2.4 (CATHODE)
/Ideal Diode/TVS_mid: D1.2 (A), D2.2 (A)
/Ideal Diode/VCAP: C2.2, U2.1 (VCAP)
/Ideal Diode/V_{ON}: R1.2, R2.1, U1.2, U1.5
GNDPWR: C1.2, C3.2, C4.2, D2.1 (K), D3.1 (A), D4.1 (A), IN.2, OUT.2, R2.2, U1.4 (GND), U2.2 (GND)
