ut-ras/rm_electrical-supercap/Rev 1 Boards/Housekeeping Rev1/Housekeeping Rev1.kicad_pcb

## KiCad design Rev 1 Boards/Housekeeping Rev1/Housekeeping Rev1.kicad_pcb (2025-05-26)

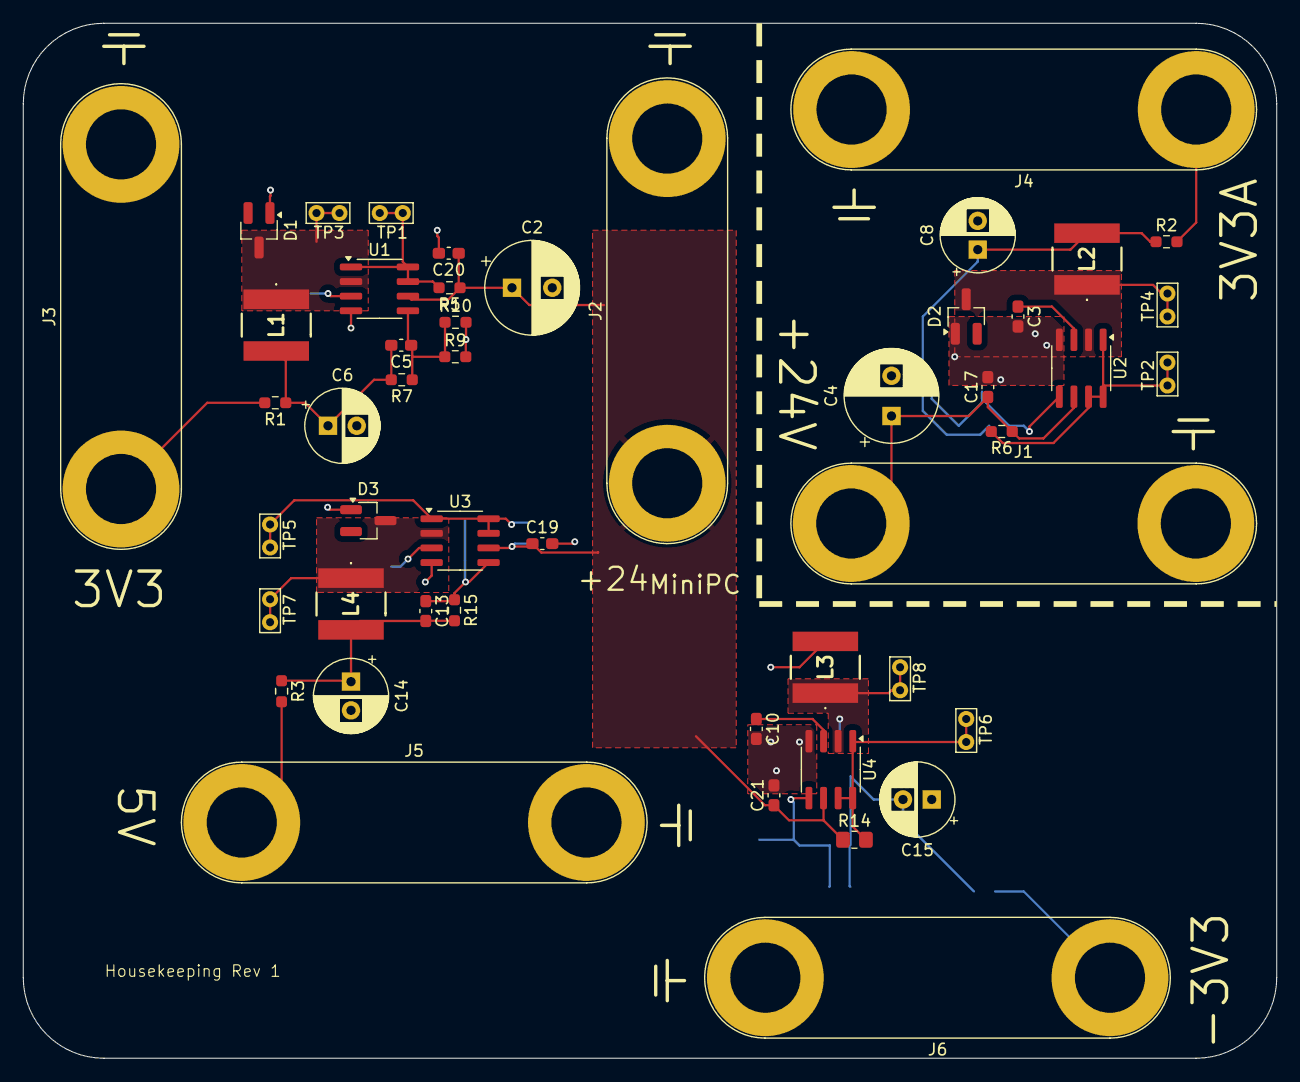
[picture p45: board Housekeeping Rev1.kicad_pcb from above]

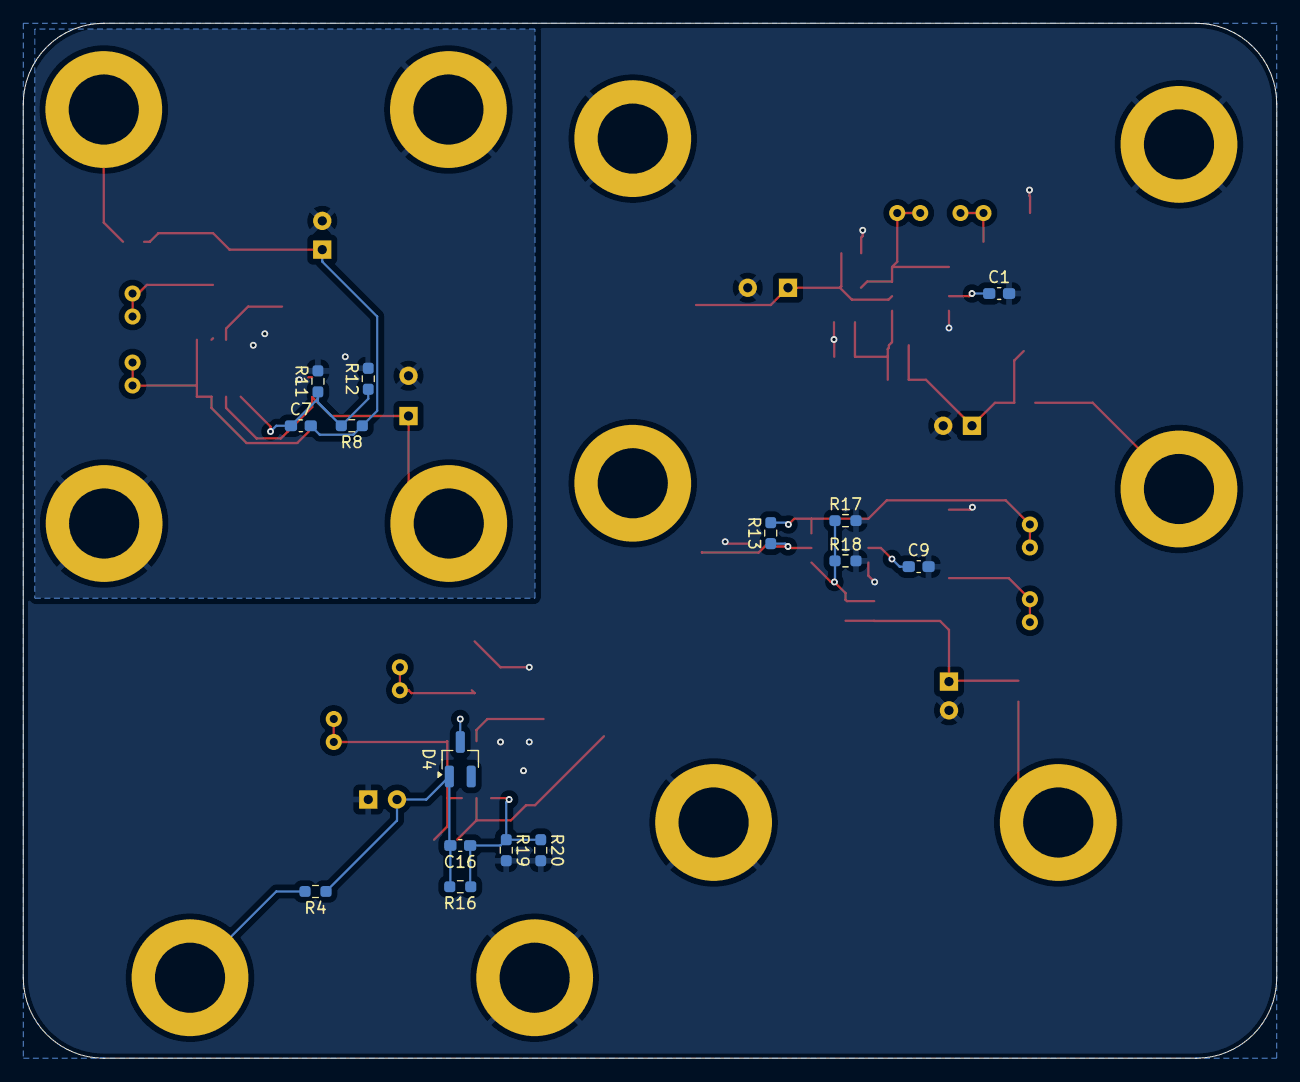
[picture p46: board Housekeeping Rev1.kicad_pcb from below]

Board: 2 copper layers, 109.0 x 90.0 mm, 64 parts (15 on the bottom side), 28 nets.

Parts:
C1, C3: 75p; C_0603_1608Metric_Pad1.08x0.95mm_HandSolder
C2, C4: 100u; CP_Radial_D8.0mm_P3.50mm
C5, C7, C13, C16: 0.01u; C_0603_1608Metric_Pad1.08x0.95mm_HandSolder
C6, C8, C14, C15: 470u; CP_Radial_D6.3mm_P2.50mm
C9: 100p; C_0603_1608Metric_Pad1.08x0.95mm_HandSolder
C10: 68p; C_0603_1608Metric_Pad1.08x0.95mm_HandSolder
C17, C19, C20, C21: 1u; C_0603_1608Metric_Pad1.08x0.95mm_HandSolder
D1, D2, D3, D4: BAT54; SOT-23_Handsoldering
J1, J2, J3, J4, J5, J6: Conn_01x02_Socket; Banana_Jack_2Pin
L1, L2, L4: 220u; ASPIAIGS6055221MT
L3: 88u; ASPIAIGS6055221MT
R1, R2, R3, R4: 50; R_0603_1608Metric_Pad0.98x0.95mm_HandSolder
R5, R6, R13: 1; R_0603_1608Metric_Pad0.98x0.95mm_HandSolder
R7, R8, R16: 1.2k; R_0603_1608Metric_Pad0.98x0.95mm_HandSolder
R9, R11, R19: 6.8k; R_0603_1608Metric_Pad0.98x0.95mm_HandSolder
R10, R12, R20: 820; R_0603_1608Metric_Pad0.98x0.95mm_HandSolder
R14: 0.866; R_0805_2012Metric_Pad1.20x1.40mm_HandSolder
R15: 4.7k; R_0603_1608Metric_Pad0.98x0.95mm_HandSolder
R17: 12k; R_0603_1608Metric_Pad0.98x0.95mm_HandSolder
R18: 1.8k; R_0603_1608Metric_Pad0.98x0.95mm_HandSolder
TP1, TP2, TP5, TP6: V_{C}; TestPoint_Bridge_Pitch2.0mm_Drill0.7mm
TP3, TP4, TP7, TP8: V_{E}; TestPoint_Bridge_Pitch2.0mm_Drill0.7mm
U1, U2, U3, U4: MC34063A; SOIC-8_3.9x4.9mm_P1.27mm

Connections:
+3.3VA: C7.2, C8.1, L2.2, R2.1, R8.1
+3V3: C5.2, C6.1, L1.2, R1.1, R7.2
+5V: C13.2, C14.1, L4.2, R3.1, R15.2
+24V: C4.1, C17.1, J1.1, R6.1, U2.6 (VCC)
-3V3: C15.2, C16.2, D4.1 (A), R4.1, R16.2
/3V3AbR: J4.1, R2.2
/3V3bR: J3.1, R1.2
/5VbR: J5.1, R3.2
/+24_{MiniPC}: C2.1, C19.1, C20.1, C21.1, J2.1, R5.1, R13.1, R14.1, U1.6 (VCC), U3.6 (VCC), U4.6 (VCC)
/-3V3bR: J6.1, R4.2
/Housekeeping Power Supplies/3V3A_COMP: C7.1, R8.2, R11.1, R12.1, U2.5 (COMP-)
/Housekeeping Power Supplies/3V3A_CT: C3.1, U2.3 (CT)
/Housekeeping Power Supplies/3V3A_SW: D2.3 (K), L2.1, TP4.1, U2.2 (SE)
/Housekeeping Power Supplies/3V3A_VC: R6.2, TP2.1, U2.1 (SC), U2.7 (I_{PK}), U2.8 (DC)
/Housekeeping Power Supplies/3V3_COMP: C5.1, R7.1, R9.1, R10.1, U1.5 (COMP-)
/Housekeeping Power Supplies/3V3_CT: C1.1, U1.3 (CT)
/Housekeeping Power Supplies/3V3_SW: D1.3 (K), L1.1, TP3.1, U1.2 (SE)
/Housekeeping Power Supplies/3V3_VC: R5.2, TP1.1, U1.1 (SC), U1.7 (I_{PK}), U1.8 (DC)
/Housekeeping Power Supplies/5V_COMP: C13.1, R15.1, R17.1, R18.1, U3.5 (COMP-)
/Housekeeping Power Supplies/5V_CT: C9.1, U3.3 (CT)
/Housekeeping Power Supplies/5V_SW: D3.3 (K), L4.1, TP7.1, U3.2 (SE)
/Housekeeping Power Supplies/5V_VC: R13.2, TP5.1, U3.1 (SC), U3.7 (I_{PK}), U3.8 (DC)
/Housekeeping Power Supplies/-3V3_COMP: C16.1, R16.1, R19.1, R20.1, U4.5 (COMP-)
/Housekeeping Power Supplies/-3V3_CT: C10.1, U4.3 (CT)
/Housekeeping Power Supplies/-3V3_SW: D4.3 (K), L3.1, TP8.1, U4.2 (SE)
/Housekeeping Power Supplies/-3V3_VC: R14.2, TP6.1, U4.1 (SC), U4.7 (I_{PK}), U4.8 (DC)
GND: C1.2, C2.2, C6.2, C9.2, C10.2, C14.2, C15.1, C19.2, C20.2, C21.2, D1.1 (A), D3.1 (A), J2.2, J3.2, J5.2, J6.2, L3.2, R9.2, R10.2, R17.2, R18.2, R19.2, R20.2, U1.4 (GND), U3.4 (GND), U4.4 (GND)
GNDPWR: C3.2, C4.2, C8.2, C17.2, D2.1 (A), J1.2, J4.2, R11.2, R12.2, U2.4 (GND)
