ut-ras/rm_electrical-supercap/Rev 1B Boards/Rev 1B/Rev 1B.kicad_pcb

## KiCad design Rev 1B Boards/Rev 1B/Rev 1B.kicad_pcb (2025-05-26)

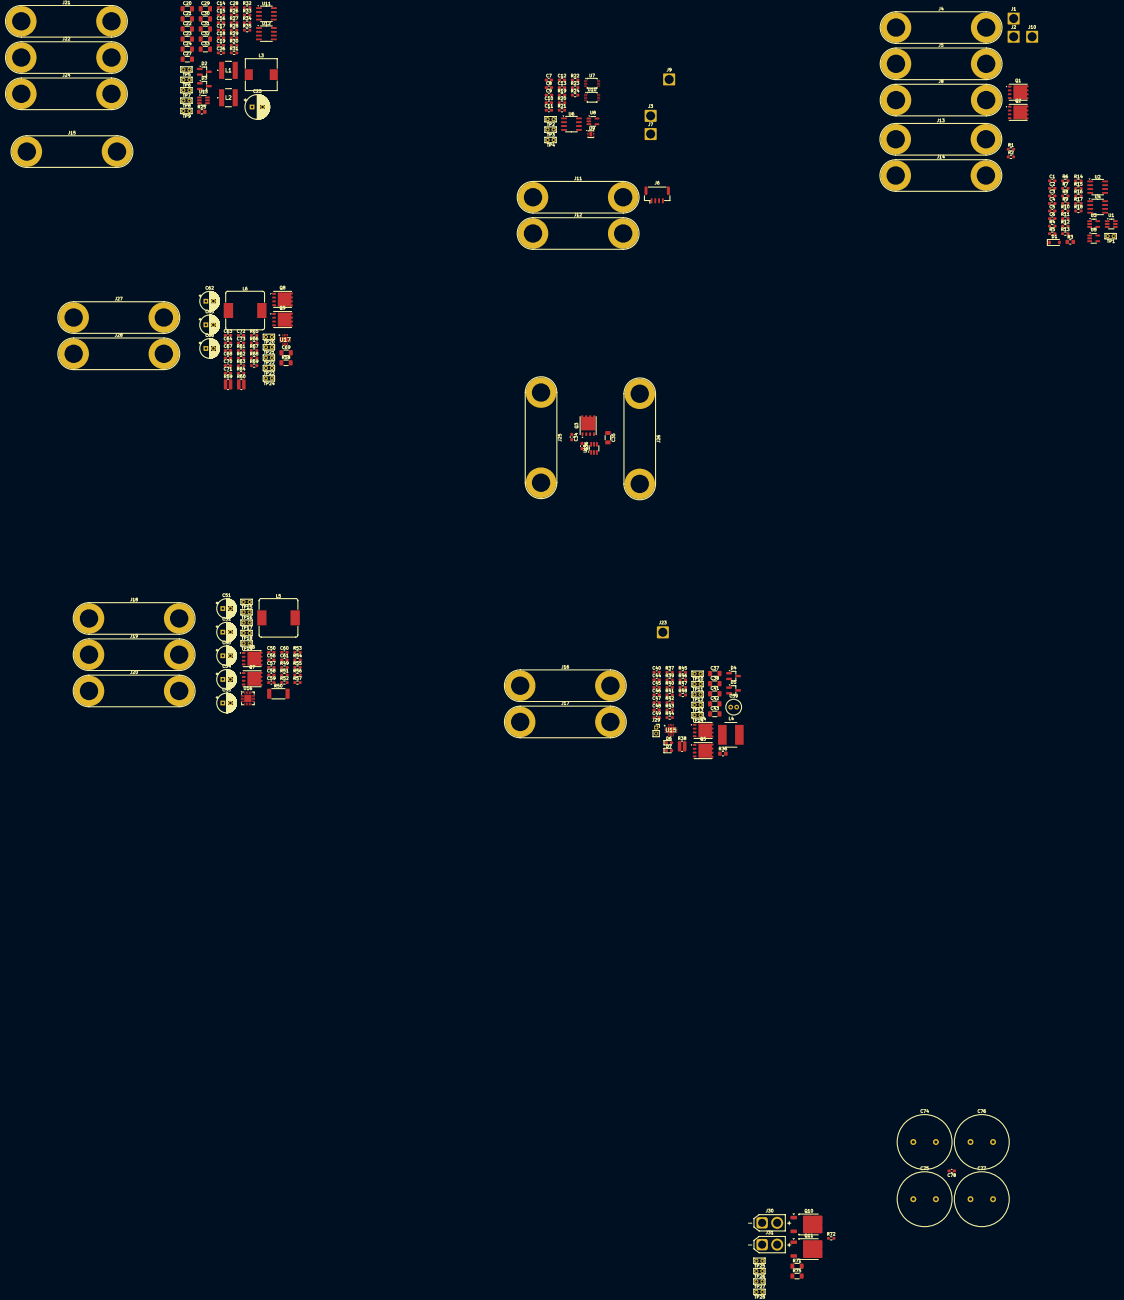
[picture p47: board Rev 1B.kicad_pcb from above]

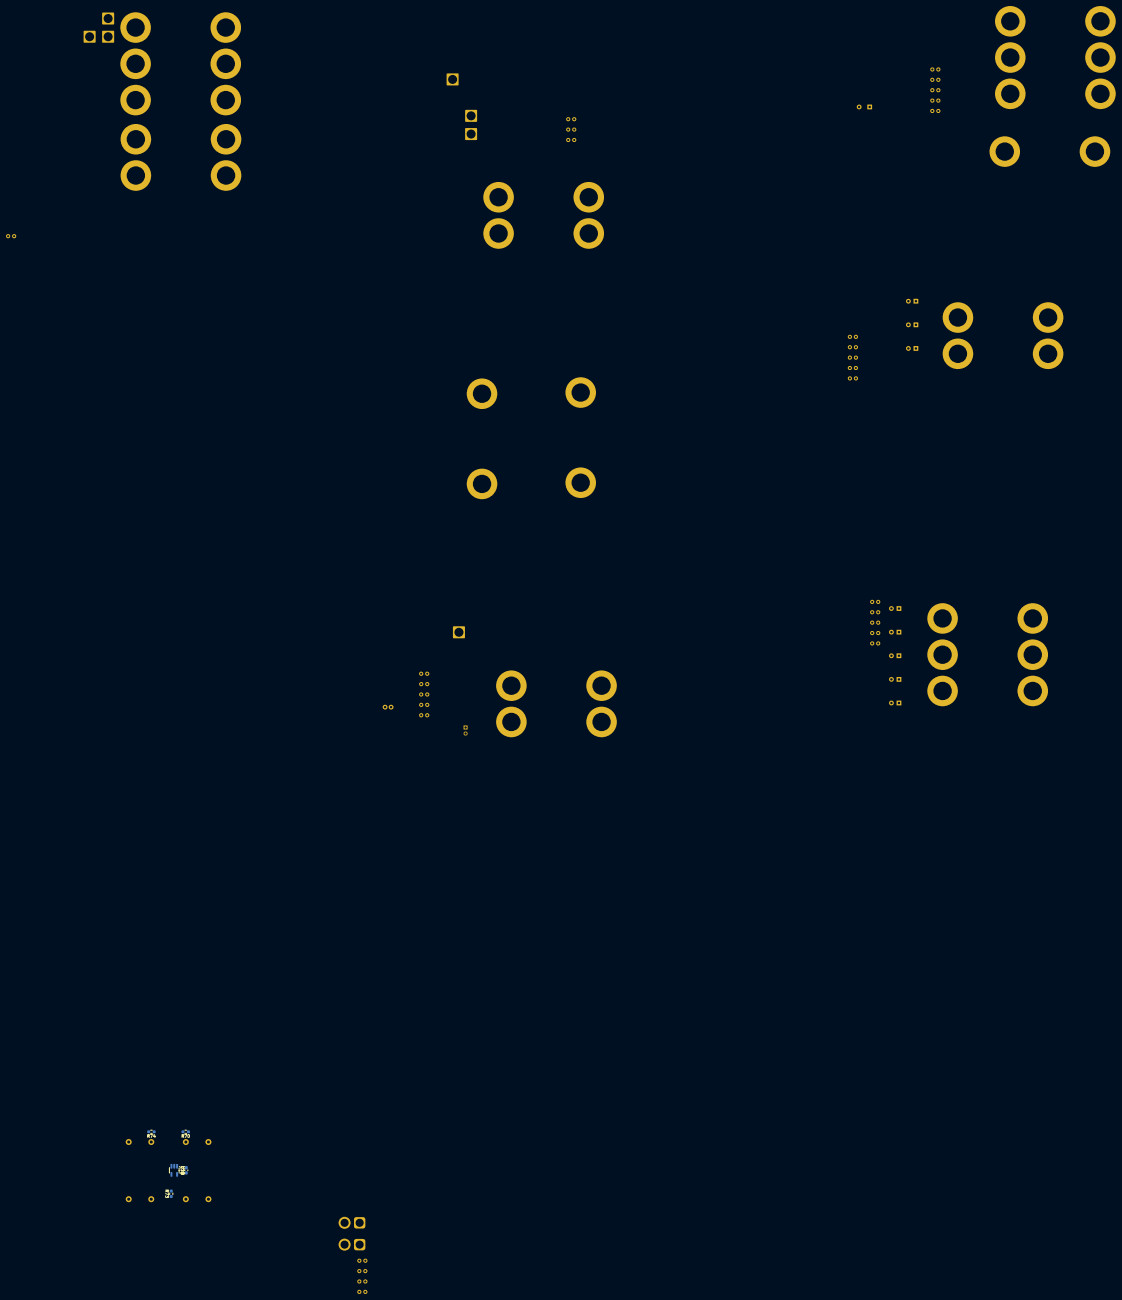
[picture p48: board Rev 1B.kicad_pcb from below]

Board: 2 copper layers, 255 parts (5 on the bottom side), 119 nets, no tracks yet.

Parts:
C1, C2, C3, C5, C7, C8, C9, C10, C11, C12, C26, C36, C45, C46, C49, C50, C56, C63, C64, C72, C79: 0.1u; C_0603_1608Metric_Pad1.08x0.95mm_HandSolder
C4, C6: 1000p; C_0603_1608Metric_Pad1.08x0.95mm_HandSolder
C13: 6.8u; C_0603_1608Metric_Pad1.08x0.95mm_HandSolder
C14: 82p; C_0603_1608Metric_Pad1.08x0.95mm_HandSolder
C15, C78: 100p; C_0603_1608Metric_Pad1.08x0.95mm_HandSolder
C16, C17, C40, C47, C48, C67, C68: 1u; C_0603_1608Metric_Pad1.08x0.95mm_HandSolder
C18, C19, C73: 0.01u; C_0603_1608Metric_Pad1.08x0.95mm_HandSolder
C20, C21, C22, C23, C24, C27, C29, C30, C31, C32, C33, C37, C38, C41, C42, C43, C69: 10u; C_1206_3216Metric_Pad1.33x1.80mm_HandSolder
C25: 100u; CP_Radial_D8.0mm_P3.50mm
C28: 330p; C_0603_1608Metric_Pad1.08x0.95mm_HandSolder
C34: 0.022u; C_0603_1608Metric_Pad1.08x0.95mm_HandSolder
C35: 47u; C_1206_3216Metric_Pad1.33x1.80mm_HandSolder
C39: 2.2u; C_Radial_D5.0mm_H11.0mm_P2.00mm
C44, C70: 15p; C_0603_1608Metric_Pad1.08x0.95mm_HandSolder
C51, C52, C53, C54, C55, C62, C65, C66: 220u; CP_Radial_D6.3mm_P2.50mm
C57: 200p; C_0603_1608Metric_Pad1.08x0.95mm_HandSolder
C58, C60: 0.47u; C_0603_1608Metric_Pad1.08x0.95mm_HandSolder
C59: 4.7u; C_0603_1608Metric_Pad1.08x0.95mm_HandSolder
C61: 0.015u; C_0603_1608Metric_Pad1.08x0.95mm_HandSolder
C71: 180p; C_0603_1608Metric_Pad1.08x0.95mm_HandSolder
C74, C75, C76, C77: 110; C_Radial_D18.0mm_H35.5mm_P7.50mm
D1: MMSZ4678T1G; D_SOD-123
D2, D3, D4, D5: BAT54; SOT-23_Handsoldering
D6: LTST-C193TBKT-5A; LED_0603_1608Metric_Pad1.05x0.95mm_HandSolder
D7: LTST-C193KSKT-5A; LED_0603_1608Metric_Pad1.05x0.95mm_HandSolder
J1, J2, J3, J7, J9, J10, J23: Conn_01x01_Pin; SolderWire-2.5sqmm_1x01_D2.4mm_OD3.6mm
J4, J5, J8, J11, J12, J13, J14, J15, J16, J17, J18, J19, J20, J21, J22, J24, J25, J26, J27, J28: Banana 2P; Banana_Jack_2Pin
J6: JST4_F; JST_GH_BM04B-GHS-TBT_1x04-1MP_P1.25mm_Vertical
J29: Conn_01x02_Socket; PinSocket_1x02_P2.00mm_Vertical
J30, J31: XT30_F; AMASS_XT30U-F_1x02_P5.0mm_Vertical
L1, L2: 220u; ASPIAIGS6055221MT
L3: 8.2u; L_10.4x10.4_H4.8
L4: 4.7u; L_Bourns_SRN8040TA
L5, L6: 1.8u; L_Bourns_SRP1245A
Q1, Q2, Q3, Q4, Q5, Q6, Q7, Q8, Q9: BSC059N04LS6; Infineon_PG-TDSON-8_6.15x5.15mm
Q10: 2SCR587D3; TO-252-2
Q11: 2SAR587D3; TO-252-2
R1, R2, R37, R40, R49, R51, R62, R63, R66: 0; R_0603_1608Metric_Pad0.98x0.95mm_HandSolder
R3: 0.02; R_0805_2012Metric_Pad1.20x1.40mm_HandSolder
R4, R6, R9, R13, R32: 1k; R_0603_1608Metric_Pad0.98x0.95mm_HandSolder
R5, R7, R11, R12, R15, R18, R70, R74: 1Meg; R_0603_1608Metric_Pad0.98x0.95mm_HandSolder
R8, R17, R48: 47k; R_0603_1608Metric_Pad0.98x0.95mm_HandSolder
R10, R14, R34, R61: 100k; R_0603_1608Metric_Pad0.98x0.95mm_HandSolder
R16, R42: 15k; R_0603_1608Metric_Pad0.98x0.95mm_HandSolder
R19, R20, R21, R22: 1.5k; R_0603_1608Metric_Pad0.98x0.95mm_HandSolder
R23, R30: 180k; R_0603_1608Metric_Pad0.98x0.95mm_HandSolder
R24: 220k; R_0603_1608Metric_Pad0.98x0.95mm_HandSolder
R25: 180; R_0805_2012Metric_Pad1.20x1.40mm_HandSolder
R26, R27: 1; R_0603_1608Metric_Pad0.98x0.95mm_HandSolder
R28: 1.2k; R_0603_1608Metric_Pad0.98x0.95mm_HandSolder
R29, R33, R56: 22k; R_0603_1608Metric_Pad0.98x0.95mm_HandSolder
R31: 820; R_0603_1608Metric_Pad0.98x0.95mm_HandSolder
R35: 13.7k; R_0603_1608Metric_Pad0.98x0.95mm_HandSolder
R36: 6.8; R_0805_2012Metric_Pad1.20x1.40mm_HandSolder
R38: 0.01; R_0612_1632Metric_Pad1.18x3.40mm_HandSolder
R39: 27k; R_0603_1608Metric_Pad0.98x0.95mm_HandSolder
R41, R57: 470k; R_0603_1608Metric_Pad0.98x0.95mm_HandSolder
R43, R44: 4.7k; R_0603_1608Metric_Pad0.98x0.95mm_HandSolder
R45: 9.31k; R_0603_1608Metric_Pad0.98x0.95mm_HandSolder
R46: 82k; R_0603_1608Metric_Pad0.98x0.95mm_HandSolder
R47: 430k; R_0603_1608Metric_Pad0.98x0.95mm_HandSolder
R50: 2m; R_2512_6332Metric_Pad1.40x3.35mm_HandSolder
R52: 18k; R_0603_1608Metric_Pad0.98x0.95mm_HandSolder
R53: 35.7k; R_0603_1608Metric_Pad0.98x0.95mm_HandSolder
R54: 75k; R_0603_1608Metric_Pad0.98x0.95mm_HandSolder
R55: 39k; R_0603_1608Metric_Pad0.98x0.95mm_HandSolder
R58: 47m; R_1206_3216Metric_Pad1.30x1.75mm_HandSolder
R59, R60: 1m; R_0612_1632Metric_Pad1.18x3.40mm_HandSolder
R64: 22.6k; R_0603_1608Metric_Pad0.98x0.95mm_HandSolder
R65: 330k; R_0603_1608Metric_Pad0.98x0.95mm_HandSolder
R67: 76.8k; R_0603_1608Metric_Pad0.98x0.95mm_HandSolder
R68: 30k; R_0603_1608Metric_Pad0.98x0.95mm_HandSolder
R69: 43k; R_0603_1608Metric_Pad0.98x0.95mm_HandSolder
R71, R75: 0.1; R_1206_3216Metric_Pad1.30x1.75mm_HandSolder
R72, R73: 100; R_0603_1608Metric_Pad0.98x0.95mm_HandSolder
TP1: V_{DIFF10}; TestPoint_Bridge_Pitch2.0mm_Drill0.7mm
TP2: V_{SCL}; TestPoint_Bridge_Pitch2.0mm_Drill0.7mm
TP3: V_{SDA}; TestPoint_Bridge_Pitch2.0mm_Drill0.7mm
TP4: V_{SC+BUF}; TestPoint_Bridge_Pitch2.0mm_Drill0.7mm
TP5, TP6: V_{C}; TestPoint_Bridge_Pitch2.0mm_Drill0.7mm
TP7, TP8: V_{E}; TestPoint_Bridge_Pitch2.0mm_Drill0.7mm
TP9, TP11, TP16, TP20: V_{SW}; TestPoint_Bridge_Pitch2.0mm_Drill0.7mm
TP10: V_{HIDRV}; TestPoint_Bridge_Pitch2.0mm_Drill0.7mm
TP12, TP17, TP21: V_{P}; TestPoint_Bridge_Pitch2.0mm_Drill0.7mm
TP13: V_{LODRV}; TestPoint_Bridge_Pitch2.0mm_Drill0.7mm
TP14, TP19, TP22: V_{N}; TestPoint_Bridge_Pitch2.0mm_Drill0.7mm
TP15: V_{HO}; TestPoint_Bridge_Pitch2.0mm_Drill0.7mm
TP18: V_{LO}; TestPoint_Bridge_Pitch2.0mm_Drill0.7mm
TP23: V_{LDRV}; TestPoint_Bridge_Pitch2.0mm_Drill0.7mm
TP24: V_{HDRV}; TestPoint_Bridge_Pitch2.0mm_Drill0.7mm
TP25: V_{OUT}; TestPoint_Bridge_Pitch2.0mm_Drill0.7mm
TP26: V_{CAP}; TestPoint_Bridge_Pitch2.0mm_Drill0.7mm
TP27: V_{MID}; TestPoint_Bridge_Pitch2.0mm_Drill0.7mm
TP28: V_{REF}; TestPoint_Bridge_Pitch2.0mm_Drill0.7mm
U1: MAX4073T; SOT-23-6_Handsoldering
U2, U4: OPA551U; SOIC-8_3.9x4.9mm_P1.27mm
U3, U5, U8, U18: TLV9301xDBV; SOT-23-5_HandSoldering
U6: ISO164xB; SOIC-8_3.9x4.9mm_P1.27mm
U7, U10: ADS1014IDGS; TSSOP-10_3x3mm_P0.5mm
U9: DAC53401; WSON-8-1EP_2x2mm_P0.5mm_EP0.9x1.6mm
U11, U12: MC34063A; SOIC-8_3.9x4.9mm_P1.27mm
U13: TPS54302; SOT-23-6_Handsoldering
U14: LM74700; SOT-23-6_Handsoldering
U15: BQ24640; QFN50P350X350X100-17N-D
U16: LM5123-Q1; Texas_RGP0020H_VQFN-20-1EP_4x4mm_P0.5mm_EP2.4x2.4mm
U17: TPS43061; Texas_S-PWQFN-N16

Connections:
+3V3: C7.1, C8.2, C11.2, C12.2, C18.2, C20.1, J12.1, J15.1, L2.2, R21.1, R22.1, R28.2, U6.8 (VCC2), U7.8 (VDD), U9.1 (A0), U9.6 (VDD), U10.1 (ADDR), U10.8 (VDD)
+5V: C28.1, C29.1, C30.1, C31.1, C32.1, C33.1, J22.1, L3.2, R34.1
+24V: C1.1, C5.1, C10.2, J8.1, J11.1, J20.1, Q1.1 (S), Q1.2 (S), Q1.3 (S), R3.2, U1.5 (RS-), U3.5 (V+), U5.5 (V+), U8.5 (V+), U16.8 (BIAS)
/+3V3_{DEV}: C9.2, J6.1, R19.1, R20.1, U6.1 (VCC1)
/+4.4V_{SCAP}_BYPASS: C35.1, J26.1, Q3.5 (D), U14.4 (CATHODE)
/+4.4V_{SCAP}_IN: C62.1, C63.1, J27.1, R58.1, R59.1, TP21.1, U17.6 (ISNS+), U17.7 (VIN)
/+4.4V_{SCAP}_OUT: C50.1, C51.1, C52.1, C53.1, C54.1, C55.1, J19.1, Q6.5 (D), U16.3 (VOUT)
/+6V_{SCAP}_ADC: J7.1, R23.1
/+6V_{SCAP}_BYPASS: C34.1, C36.1, J25.1, Q3.1 (S), Q3.2 (S), Q3.3 (S), U14.3 (EN), U14.6 (ANODE)
/+6V_{SCAP}_IN: J18.1, R50.1, R55.1, TP17.1, U16.1 (CSP)
/+6V_{SCAP}_OUT: C41.1, C42.1, C43.1, C44.1, C46.2, J17.1, R38.2, R39.1, TP14.1, U15.9 (SRN)
/+24V_CAP_IN: J14.1, Q2.1 (S), Q2.2 (S), Q2.3 (S)
/+24V_CAP_OUT: C65.1, C66.1, C67.1, C68.1, C70.1, J28.1, Q8.5 (D), R65.1
/+24_IN: C37.1, C38.1, C39.1, D4.1 (A), J4.1, J16.1, Q4.5 (D), R3.1, R43.1, R44.1, U1.3 (Vcc), U1.4 (RS+)
/+24_MERGED: J5.1, Q1.5 (D), Q2.5 (D)
/+24_{MiniPC}: C16.1, C17.1, C25.1, C27.1, J21.1, R26.1, R27.1, U11.6 (VCC), U12.6 (VCC), U13.3 (VIN)
/BAT_CTRL: C4.2, R1.1, R7.2, U2.6
/BAT_CTRL_R: Q1.4 (G), R1.2
/CAP_CTRL: C6.2, R15.2, U4.6
/CAP_CTRL_R: Q2.4 (G), R2.2
/CHARGE_EN_IN: J23.1, U15.2 (CE)
/CHARGE_EN_OUT: D1.2 (A), J10.1, R16.2
/CURR_IN: J9.1, U7.4 (AIN0)
/CURR_OUT: J2.1, R6.1, R9.1, R14.1, U3.1, U3.4 (-)
/Current Sense/1+: R4.2, R5.2, U2.3 (+)
/Current Sense/1-: C4.1, R6.2, R7.1, U2.2 (-)
/Current Sense/2+: R9.2, R11.2, U4.3 (+)
/Current Sense/2-: C6.1, R13.2, R15.1, U4.2 (-)
/Current Sense/3+: R10.2, R12.2, U5.3 (+)
/Current Sense/3-: R14.2, R18.1, U5.4 (-)
/Current Sense/CURR_{RAW}: U1.6 (OUT), U3.3 (+)
/Current Sense/DIFF10: D1.1 (K), R18.2, TP1.1, U5.1
/Current Sense/FLAG_{1}: R8.1, U2.8 (Flag)
/Current Sense/FLAG_{2}: R17.1, U4.8 (Flag)
/Dev Board Interface/CAP_{1}: C13.1, U9.4 (CAP)
/Dev Board Interface/SCL_{INT}: R21.2, TP2.1, U6.6 (SCL2), U7.10 (SCL), U9.2 (SCL), U10.10 (SCL)
/Dev Board Interface/SDA_{INT}: R22.2, TP3.1, U6.7 (SDA2), U7.9 (SDA), U9.3 (SDA), U10.9 (SDA)
/Dev Board Interface/V_{SC}_BUF: TP4.1, U8.1, U8.4 (-), U10.4 (AIN0)
/Dev Board Interface/V_{SC}_scaled: R23.2, R24.1, U8.3 (+)
/Housekeeping Power Supplies/3V3_COMP: C18.1, R28.1, R30.1, R31.1, U11.5 (COMP-)
/Housekeeping Power Supplies/3V3_CT: C14.1, U11.3 (CT)
/Housekeeping Power Supplies/3V3_SW: D3.3 (K), L2.1, TP8.1, U11.2 (SE)
/Housekeeping Power Supplies/3V3_VC: R26.2, TP5.1, U11.1 (SC), U11.7 (I_{PK}), U11.8 (DC)
/Housekeeping Power Supplies/30V_COMP: C19.1, R29.1, R32.1, R33.1, U12.5 (COMP-)
/Housekeeping Power Supplies/30V_CT: C15.1, U12.3 (CT)
/Housekeeping Power Supplies/30V_DC: R25.2, U12.8 (DC)
/Housekeeping Power Supplies/30V_SW: D2.1 (A), L1.2, TP7.1, U12.1 (SC)
/Housekeeping Power Supplies/30V_VC: L1.1, R25.1, R27.2, TP6.1, U12.7 (I_{PK})
/Housekeeping Power Supplies/BOOT: C26.1, U13.6 (BOOT)
/Housekeeping Power Supplies/FB: C28.2, R34.2, R35.1, U13.4 (FB)
/Housekeeping Power Supplies/SW: C26.2, L3.1, TP9.1, U13.2 (SW)
/Ideal Diode/GATE: Q3.4 (G), U14.5 (GATE)
/Ideal Diode/VCAP: C36.2, U14.1 (VCAP)
/Input Buck & Charger/BTST: C49.1, D5.3 (K), U15.16 (BTST)
/Input Buck & Charger/HIDRV: R37.1, U15.15 (HIDRV)
/Input Buck & Charger/HIDRV_R: Q4.4 (G), R37.2, TP10.1
/Input Buck & Charger/ISET: R46.2, R48.1, U15.7 (ISET)
/Input Buck & Charger/LODRV: R40.1, U15.13 (LODRV)
/Input Buck & Charger/LODRV_R: Q5.4 (G), R40.2, TP13.1
/Input Buck & Charger/PH: C49.2, L4.1, Q4.1 (S), Q4.2 (S), Q4.3 (S), Q5.5 (D), TP11.1, U15.14 (PH)
/Input Buck & Charger/REGN: C48.1, D5.1 (A), U15.12 (REGN)
/Input Buck & Charger/SRP: C45.1, C46.1, L4.2, R38.1, TP12.1, U15.10 (SRP)
/Input Buck & Charger/STAT: D6.1 (K), U15.3 (STAT)
/Input Buck & Charger/STAT_D: D6.2 (A), R43.2
/Input Buck & Charger/TS: J29.1, R45.2, R47.1, U15.4 (TS)
/Input Buck & Charger/VCC: C40.1, R36.2, U15.1 (VCC)
/Input Buck & Charger/VCC_R: D4.3 (K), R36.1
/Input Buck & Charger/VFB: C44.2, R39.2, R41.1, R42.1, U15.8 (VFB)
/Input Buck & Charger/VREF: C47.1, R45.1, R46.1, U15.6 (VREF)
/Input Buck & Charger/~PG: D7.1 (K), U15.5 (~PG)
/Input Buck & Charger/~PG_D: D7.2 (A), R44.2
/Output Boost (Stage 1)/COMP: C57.1, R52.1, U16.20 (COMP)
/Output Boost (Stage 1)/COMP_RC: C61.1, R52.2
/Output Boost (Stage 1)/CSN: L5.1, R50.2, TP19.1, U16.2 (CSN)
/Output Boost (Stage 1)/HB: C56.1, U16.7 (HB)
/Output Boost (Stage 1)/HO: R49.2, U16.5 (HO)
/Output Boost (Stage 1)/HO_R: Q6.4 (G), R49.1, TP15.1
/Output Boost (Stage 1)/LO: R51.2, U16.11 (LO)
/Output Boost (Stage 1)/LO_R: Q7.4 (G), R51.1, TP18.1
/Output Boost (Stage 1)/RT: R53.1, U16.15 (RT)
/Output Boost (Stage 1)/SS: C58.1, U16.17 (SS)
/Output Boost (Stage 1)/SW: C56.2, L5.2, Q6.1 (S), Q6.2 (S), Q6.3 (S), Q7.5 (D), TP16.1, U16.6 (SW)
/Output Boost (Stage 1)/TRK: R54.2, R56.1, U16.18 (TRK)
/Output Boost (Stage 1)/UVLO: R55.2, R57.1, U16.13 (UVLO)
/Output Boost (Stage 1)/VCC: C59.1, U16.9 (VCC)
/Output Boost (Stage 1)/VREF: C60.1, R54.1, U16.16 (VREF)
/Output Boost (Stage 2)/BOOT: C64.2, U17.11 (BOOT)
/Output Boost (Stage 2)/COMP: C71.1, R64.1, U17.3 (COMP)
/Output Boost (Stage 2)/COMP_R: C73.1, R64.2
/Output Boost (Stage 2)/FB: C70.2, R65.2, R68.1, R69.1, U17.4 (FB)
/Output Boost (Stage 2)/HDRV: R66.1, U17.13 (HDRV)
/Output Boost (Stage 2)/HDRV_R: Q8.4 (G), R66.2, TP24.1
/Output Boost (Stage 2)/IN_R: R59.2, R60.1
/Output Boost (Stage 2)/ISNS-: L6.1, R58.2, R60.2, TP22.1, U17.5 (ISNS-)
/Output Boost (Stage 2)/LDRV: R63.1, U17.8 (LDRV)
/Output Boost (Stage 2)/LDRV_R: Q9.4 (G), R63.2, TP23.1
/Output Boost (Stage 2)/PGND: C69.2, Q9.1 (S), Q9.2 (S), Q9.3 (S), R62.1, U17.9 (PGND)
/Output Boost (Stage 2)/PGOOD: R61.2, U17.14 (PGOOD)
/Output Boost (Stage 2)/RT: R67.1, U17.1 (RT)
/Output Boost (Stage 2)/SS: C72.1, U17.2 (SS)
/Output Boost (Stage 2)/SW: C64.1, L6.2, Q8.1 (S), Q8.2 (S), Q8.3 (S), Q9.5 (D), TP20.1, U17.12 (SW)
/Output Boost (Stage 2)/VCC: C69.1, R61.1, U17.10 (VCC)
/POW_LIMIT_IN: J1.1, R4.1, R10.1, R13.1
/POW_LIMIT_OUT: J3.1, U9.7 (FB), U9.8 (OUT)
/SCL_{IN}: J6.2, R20.2, U6.3 (SCL1)
/SDA_{IN}: J6.3, R19.2, U6.2 (SDA1)
/Supercapacitors/LOWER_R: Q11.3 (E), R75.2
/Supercapacitors/MID: C74.2, C75.2, C76.1, C77.1, R71.2, R72.2, R73.1, R75.1, TP27.1
/Supercapacitors/OP_OUT: C78.2, Q10.1 (B), Q11.1 (B), R72.1, TP25.1, U18.1
/Supercapacitors/REF: R70.2, R74.1, TP28.1, U18.3 (+)
/Supercapacitors/UPPER_R: Q10.3 (E), R71.1
/Supercapacitors/V-: C78.1, R73.2, U18.4 (-)
/Supercapacitors/V_{CAP}: C74.1, C75.1, J30.1, R70.1, TP26.1
/Supercapacitors/V_{CC}: C79.1, J31.1, Q10.2 (C), U18.5 (V+)
GND: C2.2, C3.2, C7.2, C8.1, C11.1, C12.1, C13.2, C14.2, C15.2, C16.2, C17.2, C20.2, C21.2, C22.2, C23.2, C24.2, C25.2, C27.2, C29.2, C30.2, C31.2, C32.2, C33.2, D3.1 (A), J11.2, J12.2, J13.2, J15.2, J20.2, J21.2, J24.2, R8.2, R17.2, R24.2, R30.2, R31.2, R32.2, R33.2, R35.2, U2.1 (V-), U2.4 (V-), U2.5 (V-), U4.1 (V-), U4.4 (V-), U4.5 (V-), U6.5 (GND2), U7.1 (ADDR), U7.3 (GND), U9.5 (AGND), U9.9 (PAD), U10.3 (GND), U11.4 (GND), U12.2 (SE), U12.4 (GND), U13.1 (GND)
GND1: C76.2, C77.2, C79.2, J30.2, J31.2, Q11.2 (C), R74.2, U18.2 (V-)
GNDD: C9.1, J6.4, U6.4 (GND1)
GNDPWR: C1.2, C5.2, C10.1, C34.2, C35.2, C37.2, C38.2, C39.2, C40.2, C41.2, C42.2, C43.2, C45.2, C47.2, C48.2, C50.2, C51.2, C52.2, C53.2, C54.2, C55.2, C57.2, C58.2, C59.2, C60.2, C61.2, C62.2, C63.2, C65.2, C66.2, C67.2, C68.2, C71.2, C72.2, C73.2, J4.2, J5.2, J8.2, J14.2, J16.2, J17.2, J18.2, J19.2, J22.2, J25.2, J26.2, J27.2, J28.2, J29.2, Q5.1 (S), Q5.2 (S), Q5.3 (S), Q7.1 (S), Q7.2 (S), Q7.3 (S), R5.1, R11.1, R12.1, R16.1, R41.2, R42.2, R47.2, R48.2, R53.2, R56.2, R57.2, R62.2, R67.2, R68.2, R69.2, U1.1 (GND), U1.2 (GND), U3.2 (V-), U5.2 (V-), U7.5 (AIN1), U8.2 (V-), U10.5 (AIN1), U14.2 (GND), U15.11 (GND), U15.17 (PAD), U16.10 (PGND), U16.14 (SYNC/DITHER), U16.19 (AGND), U16.21 (EP), U17.16 (AGND), U17.17 (PAD)
VCC: C2.1, C3.1, C19.2, C21.1, C22.1, C23.1, C24.1, D2.3 (K), J13.1, J24.1, R29.2, U2.7 (V+), U4.7 (V+)
