ut-ras/rm_electrical-supercap/Rev 1 Boards/Input Buck Rev1/Input Buck Rev1.kicad_pcb

## KiCad design Rev 1 Boards/Input Buck Rev1/Input Buck Rev1.kicad_pcb (2025-05-12)

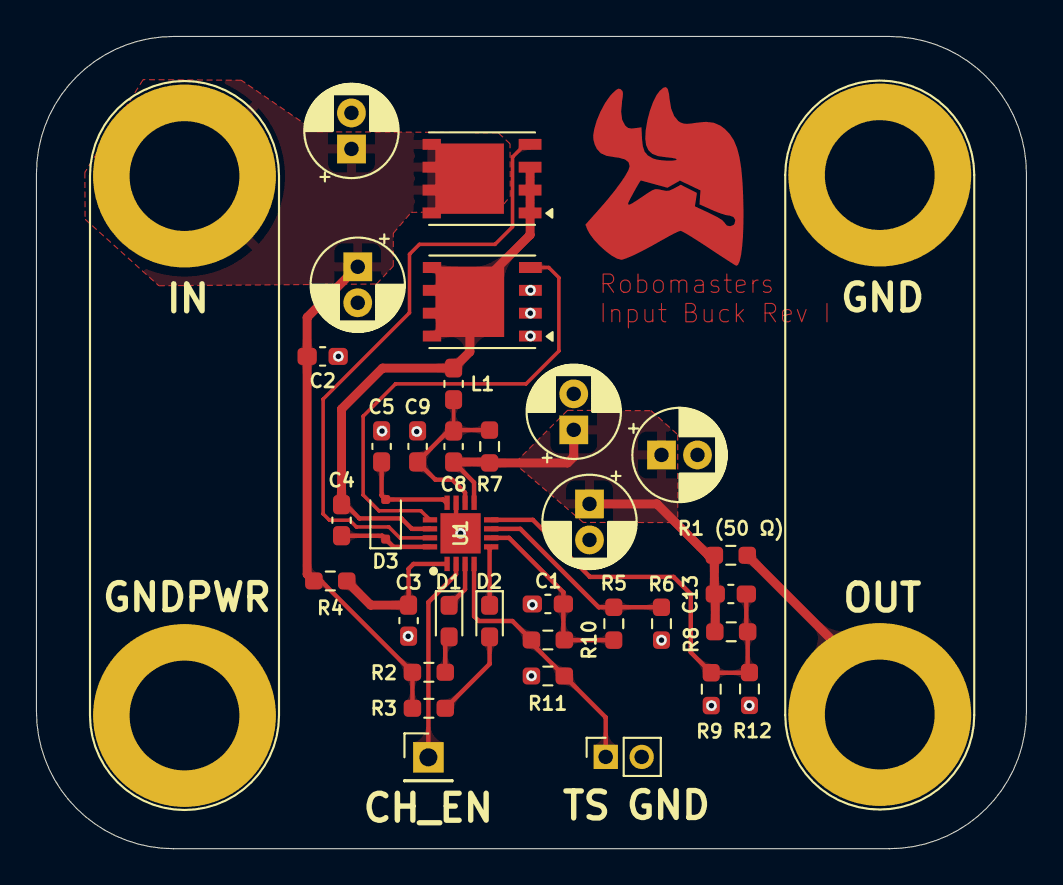
[picture p49: board Input Buck Rev1.kicad_pcb from above]

Board: 2 copper layers, 55.0 x 45.1 mm, 36 parts (0 on the bottom side), 20 nets.

Parts:
C1, C3, C5: 1u; C_0603_1608Metric_Pad1.08x0.95mm_HandSolder
C2: 2.2u; C_0603_1608Metric_Pad1.08x0.95mm_HandSolder
C4, C8, C9: 0.1u; C_0603_1608Metric_Pad1.08x0.95mm_HandSolder
C6, C7, C10, C11, C12: 10u; CP_Radial_D5.0mm_P2.00mm
C13: 1.3p; C_0603_1608Metric_Pad1.08x0.95mm_HandSolder
D1: LTST-C193TBKT-5A; LED_0603_1608Metric_Pad1.05x0.95mm_HandSolder
D2: LTST-C193KSKT-5A; LED_0603_1608Metric_Pad1.05x0.95mm_HandSolder
D3: BAT54J; D_SOD-323F
J1, J2: Conn_01x02_Socket; Banana_Jack_2Pin
J3: Conn_01x01_Pin; PinHeader_1x01_P2.54mm_Vertical
J4: Conn_01x02_Socket; PinSocket_1x02_P2.00mm_Vertical
L1: 4.7u; L_0603_1608Metric_Pad1.05x0.95mm_HandSolder
Q1, Q2: RS1G120MNTB; PowerPAK_SO-8_Single
R1 (50 Ω): 50; R_0603_1608Metric_Pad0.98x0.95mm_HandSolder
R2, R3: 4.7k; R_0603_1608Metric_Pad0.98x0.95mm_HandSolder
R4: 6.8; R_0603_1608Metric_Pad0.98x0.95mm_HandSolder
R5: 75k; R_0603_1608Metric_Pad0.98x0.95mm_HandSolder
R6: 24k; R_0603_1608Metric_Pad0.98x0.95mm_HandSolder
R7: 10m; R_0603_1608Metric_Pad0.98x0.95mm_HandSolder
R8: 200k; R_0603_1608Metric_Pad0.98x0.95mm_HandSolder
R9: 280k; R_0603_1608Metric_Pad0.98x0.95mm_HandSolder
R10: 2.74k; R_0603_1608Metric_Pad0.98x0.95mm_HandSolder
R11: 9.53k; R_0603_1608Metric_Pad0.98x0.95mm_HandSolder
R12: 1.05Meg; R_0603_1608Metric_Pad0.98x0.95mm_HandSolder
U1: BQ24640; QFN50P350X350X100-17N-D

Connections:
/Input Buck/BTST: C4.1, D3.1 (K), U1.16 (BTST)
/Input Buck/CHARGE_EN: J3.1, U1.2 (CE)
/Input Buck/HIDRV: Q1.4 (G), U1.15 (HIDRV)
/Input Buck/IN: C2.1, C6.1, C7.1, J2.2, Q1.5 (D), R2.1, R3.1, R4.1
/Input Buck/ISET: R5.2, R6.1, U1.7 (ISET)
/Input Buck/LODRV: Q2.4 (G), U1.13 (LODRV)
/Input Buck/PH: C4.2, L1.1, Q1.1 (S), Q1.2 (S), Q1.3 (S), Q2.5 (D), U1.14 (PH)
/Input Buck/REGN: C5.1, D3.2 (A), U1.12 (REGN)
/Input Buck/SRN: C8.2, C10.1, C11.1, C12.1, C13.1, R1 (50 Ω).2, R7.1, R8.1, U1.9 (SRN)
/Input Buck/SRP: C8.1, C9.1, L1.2, R7.2, U1.10 (SRP)
/Input Buck/STAT: D1.1 (K), U1.3 (STAT)
/Input Buck/STAT_D: D1.2 (A), R2.2
/Input Buck/TS: J4.1, R10.2, R11.1, U1.4 (TS)
/Input Buck/VCC: C3.1, R4.2, U1.1 (VCC)
/Input Buck/VFB: C13.2, R8.2, R9.1, R12.1, U1.8 (VFB)
/Input Buck/VREF: C1.1, R5.1, R10.1, U1.6 (VREF)
/Input Buck/~PG: D2.1 (K), U1.5 (~PG)
/Input Buck/~PG_D: D2.2 (A), R3.2
/out: J1.2, R1 (50 Ω).1
GNDPWR: C1.2, C2.2, C3.2, C5.2, C6.2, C7.2, C9.2, C10.2, C11.2, C12.2, J2.1, J4.2, Q2.1 (S), Q2.2 (S), Q2.3 (S), R6.2, R9.2, R11.2, R12.2, U1.11 (GND), U1.17 (PAD)
