ut-ras/rm_electrical-supercap/Rev 1 Boards/Dev Board Interface Rev1/Dev Board Interface Rev1.kicad_pcb

## KiCad design Rev 1 Boards/Dev Board Interface Rev1/Dev Board Interface Rev1.kicad_pcb (2025-04-26)

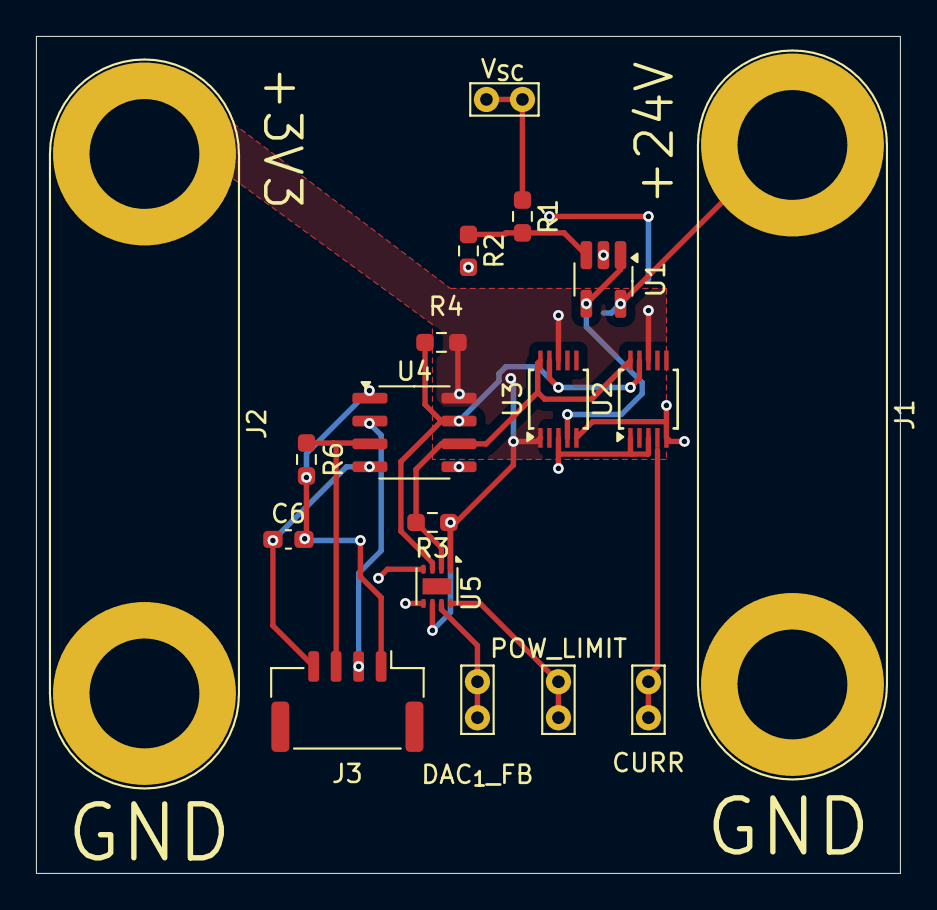
[picture p50: board Dev Board Interface Rev1.kicad_pcb from above]

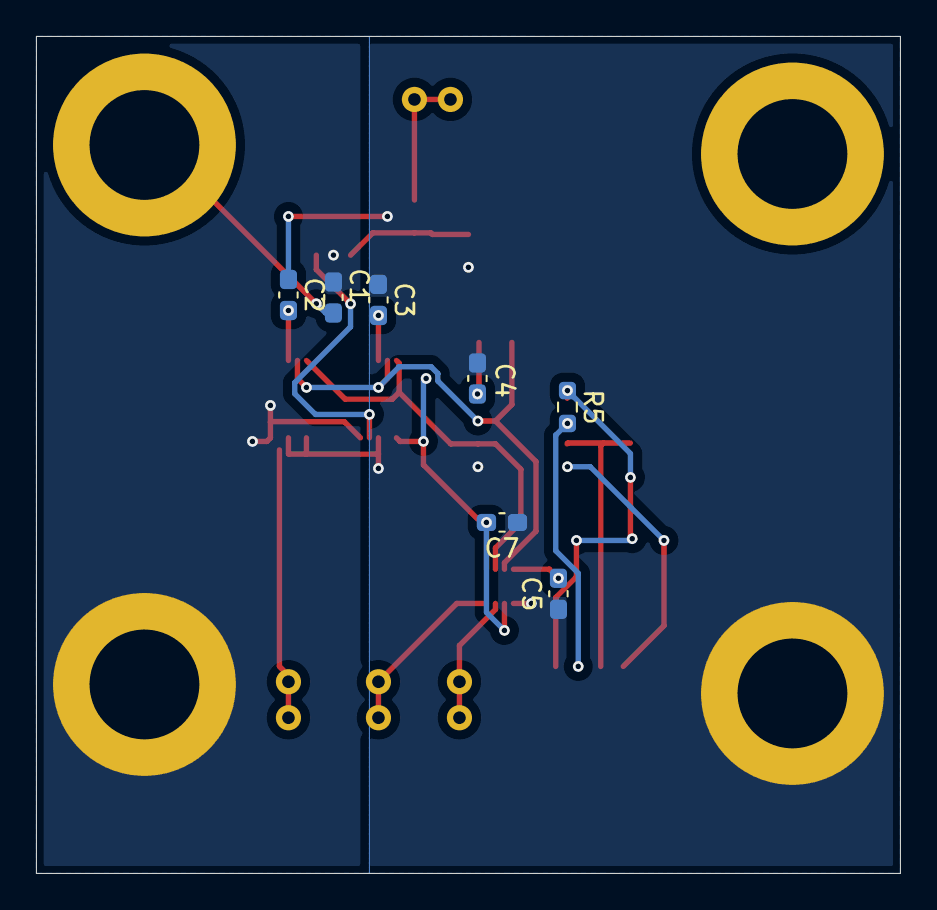
[picture p51: board Dev Board Interface Rev1.kicad_pcb from below]

Board: 2 copper layers, 48.0 x 46.5 mm, 25 parts (7 on the bottom side), 17 nets.

Parts:
C1, C2, C3, C4, C6, C7: 0.1u; C_0603_1608Metric_Pad1.08x0.95mm_HandSolder
C5: 6.8u; C_0603_1608Metric_Pad1.08x0.95mm_HandSolder
CURR: TestPoint; TestPoint_Bridge_Pitch2.0mm_Drill0.7mm
DAC_{1}_FB: TestPoint; TestPoint_Bridge_Pitch2.0mm_Drill0.7mm
J1, J2: Conn_01x02_Pin; Banana_Jack_2Pin
J3: Conn_01x04_Pin; JST_GH_BM04B-GHS-TBT_1x04-1MP_P1.25mm_Vertical
POW_LIMIT: TestPoint; TestPoint_Bridge_Pitch2.0mm_Drill0.7mm
R1: 180k; R_0603_1608Metric_Pad0.98x0.95mm_HandSolder
R2: 120k; R_0603_1608Metric_Pad0.98x0.95mm_HandSolder
R3, R4, R5, R6: 1.5k; R_0603_1608Metric_Pad0.98x0.95mm_HandSolder
U1: TLV9301xDBV; SOT-23-5_HandSoldering
U2, U3: ADS1014IDGS; TSSOP-10_3x3mm_P0.5mm
U4: ISO164xB; SOIC-8_3.9x4.9mm_P1.27mm
U5: DACx53401; WSON-8-1EP_2x2mm_P0.5mm_EP0.9x1.6mm
V_{SC}: TestPoint; TestPoint_Bridge_Pitch2.0mm_Drill0.7mm

Connections:
+3V3: C2.2, C3.2, C4.1, C7.2, J2.1, R3.1, R4.1, U2.8 (VDD), U3.1 (ADDR), U3.8 (VDD), U4.8 (VCC2), U5.1 (A0), U5.6 (VDD)
+24V: C1.2, J1.1, U1.5 (V+)
/+3V3_{DEV}: C6.2, J3.1, R5.1, R6.1, U4.1 (VCC1)
/CURR: CURR.1, U2.4 (AIN0)
/DAC_{1}_FB: DAC_{1}_FB.1, U5.7 (FB)
/Dev Board Interface/CAP_{1}: C5.1, U5.4 (CAP)
/Dev Board Interface/SCL_{INT}: R3.2, U2.10 (SCL), U3.10 (SCL), U4.6 (SCL2), U5.2 (SCL)
/Dev Board Interface/SDA_{INT}: R4.2, U2.9 (SDA), U3.9 (SDA), U4.7 (SDA2), U5.3 (SDA)
/Dev Board Interface/V_{SC}_BUF: U1.1, U1.4 (-), U3.4 (AIN0)
/Dev Board Interface/V_{SC}_scaled: R1.2, R2.1, U1.3 (+)
/POW_LIMIT: POW_LIMIT.1, U5.8 (OUT)
/SCL_{IN}: J3.3, R6.2, U4.3 (SCL1)
/SDA_{IN}: J3.2, R5.2, U4.2 (SDA1)
/V_{SC}: R1.1, V_{SC}.1
GND: C2.1, C3.1, C4.2, C5.2, C7.1, J2.2, R2.2, U2.1 (ADDR), U2.3 (GND), U3.3 (GND), U4.5 (GND2), U5.5 (AGND)
GNDD: C6.1, J3.4, U4.4 (GND1)
GNDPWR: C1.1, J1.2, U1.2 (V-), U2.5 (AIN1), U3.5 (AIN1)
