ut-ras/rm_electrical-supercap/Rev 1 Boards/Current Sense Rev1/Current Sense Rev1.kicad_pcb

## KiCad design Rev 1 Boards/Current Sense Rev1/Current Sense Rev1.kicad_pcb (2025-04-25)

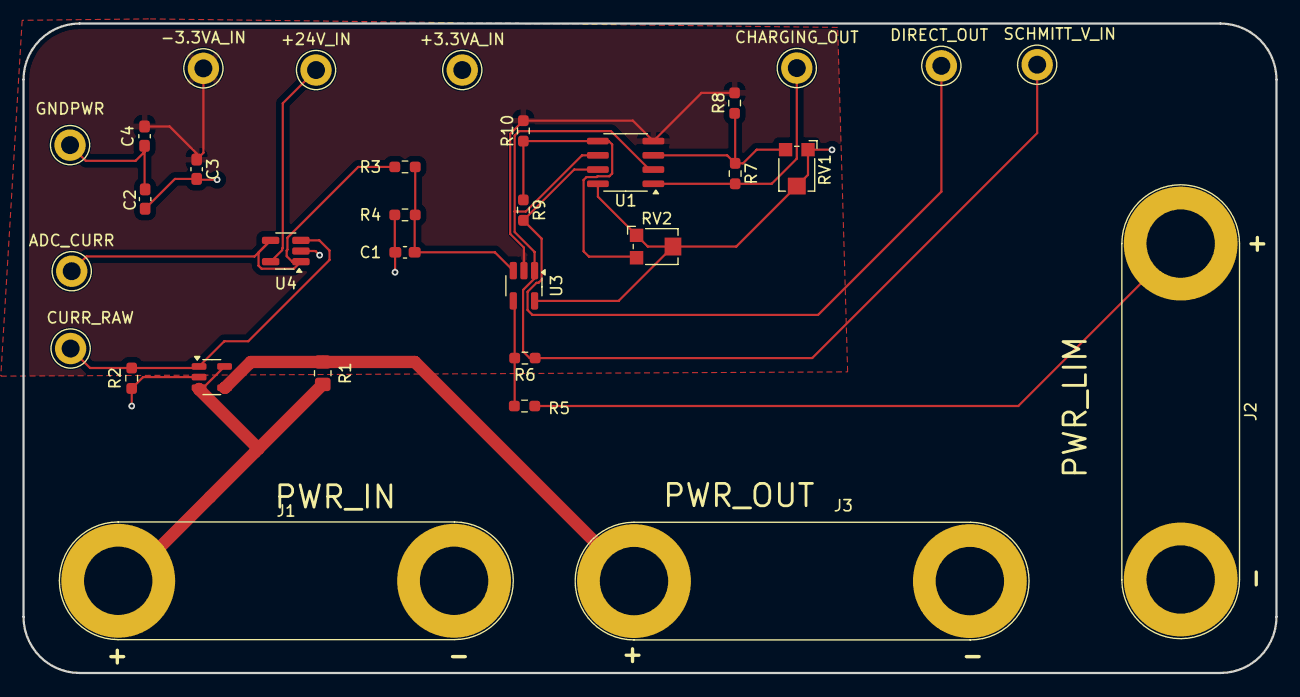
[picture p52: board Current Sense Rev1.kicad_pcb from above]

Board: 4 copper layers, 111.8 x 57.9 mm, 32 parts (0 on the bottom side), 16 nets.

Parts:
+3.3VA_IN, +24V_IN: TestPoint; TestPoint_Keystone_5010-5014_Multipurpose
-3.3VA_IN: TestPoint; TestPoint_Keystone_5010-5014_Multipurpose
ADC_CURR: TestPoint; TestPoint_Keystone_5010-5014_Multipurpose
C1: 100p; C_0603_1608Metric_Pad1.08x0.95mm_HandSolder
C2, C3, C4: 0.1u; C_0603_1608Metric_Pad1.08x0.95mm_HandSolder
CHARGING_OUT: TestPoint; TestPoint_Keystone_5010-5014_Multipurpose
CURR_RAW: TestPoint; TestPoint_Keystone_5010-5014_Multipurpose
DIRECT_OUT: TestPoint; TestPoint_Keystone_5010-5014_Multipurpose
GNDPWR: TestPoint; TestPoint_Keystone_5010-5014_Multipurpose
J1, J2, J3: Conn_01x02_Socket; Banana_Jack_2Pin
R1: 0.02; R_0805_2012Metric_Pad1.20x1.40mm_HandSolder
R2: 100k; R_0603_1608Metric_Pad0.98x0.95mm_HandSolder
R3, R5: 30k; R_0603_1608Metric_Pad0.98x0.95mm_HandSolder
R4, R6: 120k; R_0603_1608Metric_Pad0.98x0.95mm_HandSolder
R7, R9: 12k; R_0603_1608Metric_Pad0.98x0.95mm_HandSolder
R8, R10: 1k; R_0603_1608Metric_Pad0.98x0.95mm_HandSolder
RV1, RV2: TC33X-2-302E; Potentiometer_Bourns_TC33X_Vertical
SCHMITT_V_IN: TestPoint; TestPoint_Keystone_5010-5014_Multipurpose
U1: TS3702; SOIC-8_3.9x4.9mm_P1.27mm
U2: INA138; SOT-23-5
U3, U4: TLV9301; SOT-23-5_HandSoldering

Connections:
+3.3VA: +3.3VA_IN.1, C2.2, C3.2, RV1.1, RV1.2, RV2.1, RV2.2, U1.8 (V+), U3.5 (V+)
+24V: +24V_IN.1, U4.5 (V+)
-3V3: -3.3VA_IN.1, C3.1, C4.1, R8.2, R10.2, U1.4 (V-), U3.2 (V-)
/Current Sense/CEN_REF: R7.1, R8.1, RV1.3, U1.3 (+)
/Current Sense/CHARGING_IEN: CHARGING_OUT.1, R7.2, U1.1
/Current Sense/CURR: ADC_CURR.1, R3.1, U4.1, U4.4 (-)
/Current Sense/DEN_REF: R9.1, R10.1, RV2.3, U1.5 (+)
/Current Sense/DIRECT_IEN: DIRECT_OUT.1, R9.2, U1.7
/Current Sense/POW_LIMIT: J2.1, R5.1
/Current Sense/PWR_{IN}: J1.1, R1.1, U2.3 (+), U2.5 (V+)
/Current Sense/PWR_{OUT}: J3.1, R1.2, U2.4 (-)
/Current Sense/VN: C1.2, R3.2, R4.1, U3.3 (+)
/Current Sense/VP: R5.2, R6.1, U3.4 (-)
CURR_{RAW}: CURR_RAW.1, R2.1, U2.1, U4.3 (+)
GNDPWR: C1.1, C2.1, C4.2, GNDPWR.1, J1.2, J2.2, J3.2, R2.2, R4.2, U2.2 (GND), U4.2 (V-)
V_EXTRA: R6.2, SCHMITT_V_IN.1, U1.2 (-), U1.6 (-), U3.1
