ut-ras/rm_electrical-supercap/(commit log)

2024-10-18 Initial commit
    Creating project files
    [SupercapManager.kicad_pcb, SupercapManager.kicad_sch]
2024-10-18 Add schematic page properties
    [SupercapManager.kicad_sch]
2024-10-18 Add subsheets
    [SupercapManager.kicad_sch, boost.kicad_sch, buck.kicad_sch, isense.kicad_sch]
2024-10-20 Added some text in the subsheets to outline what needs to be added inside of each subsheet
    [SupercapManager.kicad_sch, boost.kicad_sch, dev_interface.kicad_sch, isense.kicad_sch, supercap_connector.kicad_sch]
2024-10-21 Added two more subsheets and updated all text inside
    [SupercapManager.kicad_sch, housekeeping.kicad_sch, ideal_diode.kicad_sch, isense.kicad_sch]
2024-10-25 Add note about synchronous boost/buck needed
    [boost.kicad_sch, buck.kicad_sch]
2024-10-26 Added in & out data from each subsheet
    For more details, please contact @leftisttachyon on Discord
    [SupercapManager.kicad_sch, boost.kicad_sch, buck.kicad_sch, dev_interface.kicad_sch, housekeeping.kicad_sch, ideal_diode.kicad_sch, isense.kicad_sch]
2024-11-16 Completed first version of housekeeping supplies
    +5V and +3V3 from mini PC +24V
    [SupercapManager.kicad_sch, boost.kicad_sch, buck.kicad_sch, dev_interface.kicad_sch, housekeeping.kicad_sch, ideal_diode.kicad_sch, isense.kicad_sch]
2024-11-16 Adjust documentation
    [housekeeping.kicad_sch]
2024-11-22 added isense
    [isense.kicad_sch]
2024-11-23 Selected an ideal diode
    [SupercapManager.kicad_sch, dev_interface.kicad_sch, ideal_diode.kicad_sch]
2024-11-23 Selected components for ideal diode and DACs
    [SupercapManager.kicad_sch, dev_interface.kicad_sch, ideal_diode.kicad_sch]
2024-11-24 Trying to do current sense but it's not fun
    canercanercnarennc
    [dev_interface.kicad_sch, isense.kicad_sch]
2024-11-24 Completed sense comparators
    [isense.kicad_sch]
2024-12-07 Finish Dev board interface
    sorry morris
    [SupercapManager.kicad_sch, dev_interface.kicad_sch, isense.kicad_sch]
2024-12-07 Formatting in dev_interface
    [dev_interface.kicad_sch]
2024-12-07 Fix ground references
    [dev_interface.kicad_sch, isense.kicad_sch]
2024-12-07 last formatting change I promise
    [dev_interface.kicad_sch]
2024-12-07 formatting!?!? idk what I changed tbh
    [SupercapManager.kicad_sch, boost.kicad_sch, buck.kicad_sch, dev_interface.kicad_sch, housekeeping.kicad_sch, ideal_diode.kicad_sch, isense.kicad_sch]
2024-12-07 Update library + update symbols
    [dev_interface.kicad_sch]
2024-12-07 Updating symbol library + passing some ERC tests
    [SupercapManager.kicad_sch, dev_interface.kicad_sch, housekeeping.kicad_sch, ideal_diode.kicad_sch, isense.kicad_sch]
2024-12-07 Remove previous version of current sense
    [isense.kicad_sch]
2024-12-07 Add input resistor divider to battery voltage ADC
    + renumbered components
    [dev_interface.kicad_sch, housekeeping.kicad_sch, ideal_diode.kicad_sch, isense.kicad_sch]
2024-12-07 Add in voltage control for components
    [SupercapManager.kicad_sch, dev_interface.kicad_sch, housekeeping.kicad_sch, ideal_diode.kicad_sch, isense.kicad_sch]
2024-12-07 Added proper peripherals to ideal diode controller
    also updated library
    [ideal_diode.kicad_sch]
2024-12-07 Polish up ideal diode subsheet
    Made custom symbol for multipinned FET
    [SupercapManager.kicad_sch, ideal_diode.kicad_sch]
2024-12-08 Finishing buck charger
    [buck.kicad_sch, ideal_diode.kicad_sch]
2024-12-08 Define feedback networks
    [buck.kicad_sch, housekeeping.kicad_sch]
2024-12-08 Finish up buck
    [buck.kicad_sch, dev_interface.kicad_sch, isense.kicad_sch]
2024-12-08 Add global connectors
    Also realize I messed up the current sense
    [SupercapManager.kicad_sch, buck.kicad_sch, isense.kicad_sch]
2024-12-08 attempting to fix comparators
    + global routing
    [SupercapManager.kicad_sch, isense.kicad_sch]
2024-12-09 Attempting to use just an opamp probably won't work
    Will use diff amp + schmitt trigger
    [housekeeping.kicad_sch, ideal_diode.kicad_sch]
2024-12-15 Adding new DC DC converter IC
    [housekeeping.kicad_sch]
2024-12-15 Complete redesign of housekeeping supplies
    Attached picture is for the design of the housekeeping supplies
    [housekeeping.kicad_sch]
2025-01-25 Reorganize block diagram
    Now with fewer wires crossing
    [SupercapManager.kicad_sch]
2025-01-31 Ideating for diff amp
    [SupercapManager.kicad_sch, buck.kicad_sch, dev_interface.kicad_sch, housekeeping.kicad_sch, ideal_diode.kicad_sch, isense.kicad_sch]
2025-02-01 Created new folder for SPICE simulations, created SPICE simulation for ideal diode controller
2025-02-01 Worked on current sensing
    Also removed redundant DAC
    [dev_interface.kicad_sch, isense.kicad_sch]
2025-02-01 Moving around things
    [SupercapManager.kicad_sch, isense.kicad_sch]
2025-02-12 Updated sheet dates & added new subsheets for parts I forgot to include
    [SupercapManager.kicad_sch, boost.kicad_sch, boost2.kicad_sch, buck.kicad_sch, dev_interface.kicad_sch, discharge.kicad_sch, housekeeping.kicad_sch, ideal_diode.kicad_sch]
2025-02-12 Normally open => closed
    [boost2.kicad_sch, discharge.kicad_sch]
2025-02-15 Replaced buck converter for 3V3, 3V3A, 5V with AZ34063U
    [housekeeping.kicad_sch]
2025-02-15 Added -3V3
    [housekeeping.kicad_sch]
2025-02-15 Added schematic for first stage of boost converter
    [SupercapManager.kicad_sch, boost.kicad_sch, buck.kicad_sch, dev_interface.kicad_sch, housekeeping.kicad_sch, ideal_diode.kicad_sch, isense.kicad_sch]
2025-02-15 Reorganized diagram so it's neater!
    [housekeeping.kicad_sch]
2025-02-21 Schematic review suggestions reflected (removed 4-way junctions, changed symbol)
    [housekeeping.kicad_sch]
2025-02-22 started safetydischarge
    [SupercapManager.kicad_sch, boost.kicad_sch, discharge.kicad_sch]
2025-02-22 Changed boost2
    [boost2.kicad_sch]
2025-02-22 Updated resistor/capacitor values for current sense and added corresponding Mouser part numbers
    [boost.kicad_sch, isense.kicad_sch]
2025-02-22 Updated AND gate input circuits, added specs to diodes
    [boost2.kicad_sch, ideal_diode.kicad_sch]
2025-02-22 Replaced opamp with better one
    [SupercapManager.kicad_sch, boost.kicad_sch, buck.kicad_sch, dev_interface.kicad_sch, discharge.kicad_sch, housekeeping.kicad_sch, ideal_diode.kicad_sch, isense.kicad_sch]
2025-02-28 current Sense simulation
    [SupercapManager.kicad_pcb]
2025-02-28 Update boost 2
    [boost2.kicad_sch]
2025-03-01 Changed to GNDPWR for -3V3 step-down converter
    [housekeeping.kicad_sch]
2025-03-01 Redesigned stage 1 converter for clarity
    [SupercapManager.kicad_sch, boost.kicad_sch, boost2.kicad_sch, buck.kicad_sch, dev_interface.kicad_sch, discharge.kicad_sch, housekeeping.kicad_sch, ideal_diode.kicad_sch]
2025-03-01 Reduced link size, added buck converter calculations excel sheet
    [DC-DC MC3x063A Step-Down Calcs.xlsx, housekeeping.kicad_sch]
2025-03-07 new boost 2 schematic
    [boost2.kicad_sch]
2025-03-07 updated discharge subsheet
    [discharge.kicad_sch]
2025-03-08 Flip MOSFET for ideal diode controller
    [ideal_diode.kicad_sch]
2025-03-08 Switched over to TI buck conveter
    [housekeeping.kicad_sch]
2025-03-08 To simulate buck, replace 22u with {L2} and 100u with {C3}
2025-03-17 Update current sense comparator resistor values
    [SupercapManager.kicad_sch, boost.kicad_sch, boost2.kicad_sch, buck.kicad_sch, dev_interface.kicad_sch, discharge.kicad_sch, housekeeping.kicad_sch, isense.kicad_sch]
2025-03-20 Simulated + designed current sense circuitry
    [SupercapManager.kicad_sch, dev_interface.kicad_sch, ideal_diode.kicad_sch, isense.kicad_sch]
2025-03-20 Simplifying schematic with more same parts and fewer components
    [isense.kicad_sch]
2025-03-20 Remove flavor text for validation
    [isense.kicad_sch]
2025-03-20 Update simulations to match current sensor design
    [housekeeping.kicad_sch]
2025-03-21 Adjust housekeeping power supplies to remove output filter network
    [DC-DC MC3x063A Step-Down Calcs.xlsx, housekeeping.kicad_sch]
2025-03-21 Updating discharge circuit to work with +24V power
    [discharge.kicad_sch, housekeeping.kicad_sch]
2025-03-21 Renumber components
    [SupercapManager.kicad_sch, boost.kicad_sch, boost2.kicad_sch, buck.kicad_sch, dev_interface.kicad_sch, discharge.kicad_sch, housekeeping.kicad_sch, ideal_diode.kicad_sch]
2025-03-21 Various mouser part changes
    [housekeeping.kicad_sch]
2025-03-22 IMPORTANT: .gitmodules points to KiCad_Library/supercap_components and symbol table points to KiCad_Library submodule for this project
2025-03-22 Configured fp library to point to local kicad_lib submodule
2025-03-24 Update project to KiCAD 9.0 + redo stage 1 schematic
    [SupercapManager.kicad_sch, boost.kicad_sch, boost2.kicad_sch, buck.kicad_sch, dev_interface.kicad_sch, discharge.kicad_sch, housekeeping.kicad_sch, ideal_diode.kicad_sch]
2025-03-24 Redo boost converter (frist stage)
    [boost.kicad_sch]
2025-03-28 Create Rev1 board projects + delete extraneous schematic file
    [Current Sense Rev1.kicad_pcb, Current Sense Rev1.kicad_sch, Dev Board Interface Rev1.kicad_pcb, Dev Board Interface Rev1.kicad_sch, Housekeeping Rev1.kicad_pcb, Housekeeping Rev1.kicad_sch, Ideal Diode Rev1.kicad_pcb, Ideal Diode Rev1.kicad_sch]
2025-03-28 Add input buck subproject
    [Input Buck Rev1.kicad_pcb, Input Buck Rev1.kicad_sch, buck.kicad_sch]
2025-03-28 Correct symbol library path, renumber components
    [Current Sense Rev1.kicad_sch, boost.kicad_sch, buck.kicad_sch, dev_interface.kicad_sch, housekeeping.kicad_sch, ideal_diode.kicad_sch, isense.kicad_sch]
2025-03-29 Fix broken component links
    [Current Sense Rev1.kicad_sch, ideal_diode.kicad_sch, isense.kicad_sch]
2025-03-29 changed some simulation numbers and current sense capacitor
2025-03-29 Update symbol libraries and link footprint libraries
2025-03-29 added footprints to prepare for pcb layout
    [Housekeeping Rev1.kicad_pcb, Housekeeping Rev1.kicad_sch, housekeeping.kicad_sch]
2025-03-29 fixed misallocation of footprint file
    [housekeeping.kicad_sch]
2025-04-04 Create last two rev1 test boards
    [Stage1 Rev1.kicad_pcb, Stage1 Rev1.kicad_sch, Stage2 Rev1.kicad_pcb, Stage2 Rev1.kicad_sch, boost.kicad_sch, boost2.kicad_sch, discharge.kicad_sch]
2025-04-04 assigned footprints, mouser part numbers, and datasheets for passive components
    [Housekeeping Rev1.kicad_sch, housekeeping.kicad_sch]
2025-04-04 Rename projects to be more descriptive
    [Stage1 Rev1.kicad_pcb, Stage1 Rev1.kicad_sch, Stage2 Rev1.kicad_pcb, Stage2 Rev1.kicad_sch, boost.kicad_sch, boost2.kicad_sch, discharge.kicad_sch]
2025-04-04 Add new components to housekeeping power supply
    [SupercapManager.kicad_sch, boost.kicad_sch, boost2.kicad_sch, buck.kicad_sch, dev_interface.kicad_sch, discharge.kicad_sch, housekeeping.kicad_sch, ideal_diode.kicad_sch]
2025-04-04 beginning layout work for housekeeping pcb
    [Housekeeping Rev1.kicad_pcb, Housekeeping Rev1.kicad_sch, housekeeping.kicad_sch]
2025-04-05 Change up capacitor values and footprints to reduce the number of bulk caps needed
    [housekeeping.kicad_sch]
2025-04-05 current sense PCB layout
    [Current Sense Rev1.kicad_pcb, Current Sense Rev1.kicad_sch, isense.kicad_sch]
2025-04-05 Added tps, connectors for Input Buck
    [Input Buck Rev1.kicad_pcb, Input Buck Rev1.kicad_sch]
2025-04-11 added mouser part numbers and corresponding datasheets/footprints for components
    [Housekeeping Rev1.kicad_pcb, housekeeping.kicad_sch]
2025-04-11 began pcb layout ofr housekeeping
    [Housekeeping Rev1.kicad_pcb, Housekeeping Rev1.kicad_sch, isense.kicad_sch]
2025-04-13 Created rudimentary component placements for Housekeeping PCB layout Pending approval from Jed before putting down traces
    [Housekeeping Rev1.kicad_pcb, housekeeping.kicad_sch]
2025-04-14 Created preliminary layout for Housekeeping PCB with traces added. Still needs review + connection of nets to ground fills.
    [Housekeeping Rev1.kicad_pcb]
2025-04-14 added traces and pours for housekeeping pcb layout
    [Housekeeping Rev1.kicad_pcb]
2025-04-14 Add labels for nets
    [housekeeping.kicad_sch]
2025-04-14 Updated Housekeeping PCB layout after review with Jed
    [Housekeeping Rev1.kicad_pcb]
2025-04-18 restore broken current sense schematic
    [Current Sense Rev1.kicad_pcb, isense.kicad_sch]
2025-04-18 current sense tweaks
    [Current Sense Rev1.kicad_pcb, isense.kicad_sch]
2025-04-18 Changed fill types for SW nets and added silkscreen labels for banana connectors
    [Housekeeping Rev1.kicad_pcb, housekeeping.kicad_sch]
2025-04-18 fixed DRC violations with housekeeping PCB layout
    [Housekeeping Rev1.kicad_pcb]
2025-04-19 address current sense review issues
    [Current Sense Rev1.kicad_pcb]
2025-04-19 Layout iteration 1 for the input buck
    [Input Buck Rev1.kicad_pcb, Input Buck Rev1.kicad_sch, buck.kicad_sch]
2025-04-19 Created preliminary board layout for dev board interface pcb, pending review by Jed
    [Dev Board Interface Rev1.kicad_pcb, Dev Board Interface Rev1.kicad_sch, Housekeeping Rev1.kicad_sch]
2025-04-25 modified tracks
    [Current Sense Rev1.kicad_pcb, Current Sense Rev1.kicad_sch, isense.kicad_sch]
2025-04-25 implemented dev board interface review suggestions as per morris
    [Dev Board Interface Rev1.kicad_pcb, dev_interface.kicad_sch]
2025-04-25 review 2 revisions
    [Current Sense Rev1.kicad_pcb]
2025-04-25 Did partial fixes according to round 2 review of dev board interface as per jed
    [Dev Board Interface Rev1.kicad_pcb]
2025-04-26 reworked dev board interface pcb layout to put all ICs on the same side as per jed review
    [Dev Board Interface Rev1.kicad_pcb]
2025-04-26 Add new boost converter to boost2 subsheet
    [boost2.kicad_sch]
2025-04-26 began ideal diode layout
    [Ideal Diode Rev1.kicad_pcb, Ideal Diode Rev1.kicad_sch, ideal_diode.kicad_sch]
2025-04-26 Minor changes
    Still need to replace the inductor footprint with the correct one
    [Input Buck Rev1.kicad_sch, buck.kicad_sch]
2025-04-26 Finished layout
    Still need to replace the footprint for the inductor
    [Input Buck Rev1.kicad_pcb]
2025-04-26 Added labels
    [Input Buck Rev1.kicad_pcb]
2025-04-26 More labels
    [Input Buck Rev1.kicad_pcb]
2025-04-26 Update KiCad_Library
2025-05-07 Completed stage 2 schematic
    + added SPICE models for all the custom components
    + updated library with stage 2 symbols
    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
    [SupercapManager.kicad_sch, boost2.kicad_sch, buck.kicad_sch, dev_interface.kicad_sch, housekeeping.kicad_sch, ideal_diode.kicad_sch, isense.kicad_sch]
2025-05-08 Attempt to design & simulate the part 2 boost
    Doesnt' seem to work for some reason
    [TPS4306x_BOOST_CALCTOOL_REVB.xls]
2025-05-10 Finalize load sharing schematic
    >=97% efficiency with constant current load
2025-05-10 Minor tweaks
    [Input Buck Rev1.kicad_pcb]
2025-05-10 Removed -30V source, still functioning
2025-05-11 Testing out different op amps to see how low we can push the power consumption
2025-05-12 finished ideal diode layout
    [Ideal Diode Rev1.kicad_pcb, Ideal Diode Rev1.kicad_sch]
2025-05-12 Completed designing both load balancing and buck enable circuits
    [buck.kicad_sch]
2025-05-12 Fix fills
    [Input Buck Rev1.kicad_pcb]
2025-05-13 ideal diode review 1 updates
    [Ideal Diode Rev1.kicad_pcb]
2025-05-13 ideal diode review 1 changes
    [Ideal Diode Rev1.kicad_pcb]
2025-05-13 Implement SPICE'd circuits in KiCAD
    [SupercapManager.kicad_sch, isense.kicad_sch]
2025-05-13 Forgot one label
    [isense.kicad_sch]
2025-05-13 Completed block diagram
    [SupercapManager.kicad_sch]
2025-05-13 Add note for self
    [SupercapManager.kicad_sch]
2025-05-13 Vastly simplified charge EN circuit
    [isense.kicad_sch]
2025-05-13 Redesign housekeeping supplies
    [SupercapManager.kicad_sch, boost.kicad_sch, boost2.kicad_sch, buck.kicad_sch, dev_interface.kicad_sch, discharge.kicad_sch, housekeeping.kicad_sch, isense.kicad_sch]
2025-05-13 Update Mouser part numbers
    Some resistors will be wrong, please check
    [boost.kicad_sch, buck.kicad_sch, dev_interface.kicad_sch, housekeeping.kicad_sch, isense.kicad_sch]
2025-05-13 Remove Mouser part number fields from visibility
    [SupercapManager.kicad_sch, boost.kicad_sch, boost2.kicad_sch, buck.kicad_sch, dev_interface.kicad_sch, discharge.kicad_sch, housekeeping.kicad_sch, isense.kicad_sch]
2025-05-13 Correct text removal
    [SupercapManager.kicad_sch, boost.kicad_sch, boost2.kicad_sch, buck.kicad_sch, dev_interface.kicad_sch, discharge.kicad_sch, housekeeping.kicad_sch, isense.kicad_sch]
2025-05-14 review 1 ideal diode changes
    [Ideal Diode Rev1.kicad_pcb]
2025-05-14 Properly spec 30V output
    [MC34063 DWS.xlsx, SupercapManager.kicad_sch, housekeeping.kicad_sch]
2025-05-15 Tuned circuits & adjusted values
    Changed footprints for some circuits to consolidate components
    [SupercapManager.kicad_sch, boost.kicad_sch, boost2.kicad_sch, bqstroller calculation tools_V1.5.xlsx, buck.kicad_sch, dev_interface.kicad_sch, discharge.kicad_sch, housekeeping.kicad_sch]
2025-05-15 Move design sheets to the design folder
    [DC-DC MC3x063A Step-Down Calcs.xlsx, MC34063 DWS.xlsx, TPS4306x_BOOST_CALCTOOL_REVB.xls, bqstroller calculation tools_V1.5.xlsx]
2025-05-15 Change .xls to .xlsx
    [TPS4306x_BOOST_CALCTOOL_REVB.xls, TPS4306x_BOOST_CALCTOOL_REVB.xlsx]
2025-05-15 Made 2nd stage boost functional
    Next possible steps: make 1st stage be able to handle even more current because the sims did not explode while supplying 3A of current (!)
    [TPS4306x_BOOST_CALCTOOL_REVB.xlsx, boost2.kicad_sch]
2025-05-15 Considering using a different IC for 1st stage
    [SupercapManager.kicad_sch, TPS4306x_BOOST_CALCTOOL_REVB.xlsx, boost.kicad_sch, boost2.kicad_sch]
2025-05-16 Redesigning output boosts to be more efficient albeit with less current capacity
    idk what I changed with the schematics lol
    [SupercapManager.kicad_sch, TPS4306x_BOOST_CALCTOOL_REVB.xlsx, boost.kicad_sch, boost2.kicad_sch, buck.kicad_sch]
2025-05-17 Successful design completed!
    Much more stable current sensing control
2025-05-17 Update SPICE footprints to make them easier to drop in replace in LTSpice
2025-05-17 Transfer new design to schematic
    [isense.kicad_sch]
2025-05-17 Find suitable op-amp for buffer in current sense
    [SupercapManager.kicad_sch, housekeeping.kicad_sch, isense.kicad_sch]
2025-05-18 Up charging current to 6A
    [SupercapManager.kicad_sch, boost.kicad_sch, boost2.kicad_sch, bqstroller calculation tools_V1.5.xlsx, buck.kicad_sch]
2025-05-19 ideal diode review 3 changes
    [Ideal Diode Rev1.kicad_pcb]
2025-05-19 Add supercaps subsheets
    [SupercapManager.kicad_sch, buck.kicad_sch, supercaps.kicad_sch]
2025-05-19 Adding simulation for charging & balancing
    [SupercapManager.kicad_sch, boost.kicad_sch, boost2.kicad_sch, buck.kicad_sch, dev_interface.kicad_sch, discharge.kicad_sch, housekeeping.kicad_sch, ideal_diode.kicad_sch]
2025-05-19 Finalize balancing circuit
    Looks pretty stable to me
    [supercaps.kicad_sch]
2025-05-19 Adjust values for better feedback
    [supercaps.kicad_sch]
2025-05-19 Updating buck converter to work with new 2S2P supercap stackup
    [SupercapManager.kicad_sch, boost.kicad_sch, boost2.kicad_sch, bqstroller calculation tools_V1.5.xlsx, buck.kicad_sch, ideal_diode.kicad_sch, supercaps.kicad_sch]
2025-05-19 Various schematic touchups
    [SupercapManager.kicad_sch, supercaps.kicad_sch]
2025-05-19 Changed output boost to be based on the LM5123-Q1
    [boost.kicad_sch, supercaps.kicad_sch]
2025-05-19 Reannotate schematic
    [SupercapManager.kicad_sch, boost.kicad_sch, boost2.kicad_sch, buck.kicad_sch, dev_interface.kicad_sch, discharge.kicad_sch, housekeeping.kicad_sch, ideal_diode.kicad_sch]
2025-05-20 Finalized design !!!
    [SupercapManager.kicad_sch, TPS4306x_BOOST_CALCTOOL_REVB.xlsx, boost.kicad_sch, boost2.kicad_sch, housekeeping.kicad_sch, supercaps.kicad_sch]
2025-05-20 Various touchups
    [SupercapManager.kicad_sch, supercaps.kicad_sch]
2025-05-20 Selected BJTs for the supercap balancing circuitry
    [supercaps.kicad_sch]
2025-05-20 Reimplement +5V to supply 3A
    [housekeeping.kicad_sch]
2025-05-20 Adjusted some things + changed discharge to have a smaller time constant
    [SupercapManager.kicad_sch, boost.kicad_sch, boost2.kicad_sch, buck.kicad_sch, discharge.kicad_sch, isense.kicad_sch, supercaps.kicad_sch]
2025-05-20 Renumbering components
    [SupercapManager.kicad_sch, boost.kicad_sch, boost2.kicad_sch, buck.kicad_sch, dev_interface.kicad_sch, discharge.kicad_sch, housekeeping.kicad_sch, ideal_diode.kicad_sch]
2025-05-22 Add voltage ratings to capacitors & respec caps to not explode
    [SupercapManager.kicad_sch, boost.kicad_sch, boost2.kicad_sch, buck.kicad_sch, dev_interface.kicad_sch, housekeeping.kicad_sch, isense.kicad_sch, supercaps.kicad_sch]
2025-05-22 Sourcing various parts
    [boost.kicad_sch, discharge.kicad_sch, ideal_diode.kicad_sch, supercaps.kicad_sch]
2025-05-23 Specc'd all components + started creating rev 1b boards
    [Housekeeping Rev1B.kicad_pcb, Housekeeping Rev1B.kicad_sch, SupercapManager.kicad_sch, boost.kicad_sch, boost2.kicad_sch, buck.kicad_sch, dev_interface.kicad_sch, discharge.kicad_sch]
2025-05-23 Test manufacturing
    [Housekeeping Rev1.kicad_pcb]
2025-05-23 Remove old housekeeping 1B rev for panelled PCB
    [Housekeeping Rev1B.kicad_sch, Ideal Diode Rev1.kicad_pcb, Rev 1B.kicad_pcb, Rev 1B.kicad_sch, housekeeping.kicad_sch]
2025-05-23 Created seperate boards for supercap
    [Rev 1B.kicad_sch, SupercapManager.kicad_sch, boost.kicad_sch, boost2.kicad_sch, buck.kicad_sch, dev_interface.kicad_sch, housekeeping.kicad_sch, ideal_diode.kicad_sch]
2025-05-24 Add test points to all subsheets
    [boost.kicad_sch, boost2.kicad_sch, buck.kicad_sch, dev_interface.kicad_sch, housekeeping.kicad_sch, ideal_diode.kicad_sch, isense.kicad_sch, supercaps.kicad_sch]
2025-05-24 Renumbered components for rev 1b layout
    [Rev 1B.kicad_sch, boost.kicad_sch, boost2.kicad_sch, buck.kicad_sch, dev_interface.kicad_sch, housekeeping.kicad_sch, ideal_diode.kicad_sch, isense.kicad_sch]
2025-05-24 Added local libraries (KiCAD_Library)
    [Rev 1B.kicad_pcb]
2025-05-24 Begin layout
    Completed ideal diode layout
    [Rev 1B.kicad_pcb, SupercapManager.kicad_sch, boost.kicad_sch, boost2.kicad_sch, buck.kicad_sch, dev_interface.kicad_sch, housekeeping.kicad_sch, ideal_diode.kicad_sch]
2025-05-25 Unsure of changes
    [Rev 1B.kicad_pcb, boost.kicad_sch, boost2.kicad_sch, buck.kicad_sch, dev_interface.kicad_sch, housekeeping.kicad_sch, ideal_diode.kicad_sch, isense.kicad_sch]
2025-05-25 Add choice to limit minimum gate voltage to avoid maximum VGS violations
    [SupercapManager.kicad_sch, boost.kicad_sch, boost2.kicad_sch, buck.kicad_sch, dev_interface.kicad_sch, housekeeping.kicad_sch, ideal_diode.kicad_sch, isense.kicad_sch]
2025-05-25 Add documentation to isense sheet
    Also fiddle with simulations
    [isense.kicad_sch]
2025-05-25 Re-enable BOM generation for supercap host board
    [SupercapManager.kicad_sch]
2025-05-25 Completed preliminary layout
    [DevBoardInterface 1B.kicad_pcb, DevBoardInterface 1B.kicad_sch, boost.kicad_sch, boost2.kicad_sch, buck.kicad_sch, dev_interface.kicad_sch, housekeeping.kicad_sch, ideal_diode.kicad_sch]
2025-05-25 More layout
    [DevBoardInterface 1B.kicad_pcb]
2025-05-25 Complete dev board interface layout
    [DevBoardInterface 1B.kicad_pcb, DevBoardInterface 1B.kicad_sch, dev_interface.kicad_sch]
2025-05-25 Completed layout for input buck test board
    [InputBuck 1B.kicad_pcb, InputBuck 1B.kicad_sch, buck.kicad_sch]
2025-05-26 Add thermistor to BOM
    [InputBuck 1B.kicad_pcb, buck.kicad_sch]
2025-05-26 Polish input buck test board
    [InputBuck 1B.kicad_pcb, InputBuck 1B.kicad_sch]
2025-05-26 Update PCB to fix ERC breaks
    [DevBoardInterface 1B.kicad_pcb, boost.kicad_sch, dev_interface.kicad_sch, ideal_diode.kicad_sch]
2025-05-26 Save dev interface subsheet
    [dev_interface.kicad_sch]
2025-05-26 Placed footprints for boost stage 1 layout
    [Boost1 1B.kicad_pcb, Boost1 1B.kicad_sch, boost.kicad_sch, boost2.kicad_sch, buck.kicad_sch, dev_interface.kicad_sch, housekeeping.kicad_sch, ideal_diode.kicad_sch]
2025-05-26 Completed first draft of layout
    [Boost1 1B.kicad_pcb]
2025-05-26 Adjustments + tons of vias
    [Boost1 1B.kicad_pcb]
2025-05-26 Completed Boost stage 1 layout
    [Boost1 1B.kicad_pcb, Boost1 1B.kicad_sch]
2025-05-26 Completed layout of supercap host board
    [SupercapHost 1B.kicad_pcb, SupercapHost 1B.kicad_sch, supercaps.kicad_sch]
2025-05-26 Complete touchups of supercap host board
    [SupercapHost 1B.kicad_pcb]
2025-05-26 Create Housekeeping power supply test board
    [Housekeeping 1B.kicad_pcb, Housekeeping 1B.kicad_sch, housekeeping.kicad_sch]
2025-05-26 Completed layout of housekeeping supplies
    [Housekeeping 1B.kicad_pcb]
2025-05-26 Fix DRC issues
    [Housekeeping 1B.kicad_pcb]
2025-05-26 Completed Housekeeping layout
    [Housekeeping 1B.kicad_pcb]
2025-05-26 Add input filter to Boost 2
    [boost2.kicad_sch]
2025-05-26 Start boost 2 layout
    [Boost2 1B.kicad_pcb, Boost2 1B.kicad_sch, boost2.kicad_sch]
2025-05-27 Complete boost2 layout
    [Boost2 1B.kicad_pcb, boost2.kicad_sch]
2025-05-27 Label boost2 board
    [Boost2 1B.kicad_pcb]
2025-05-27 Add dimensions + round corners
    [Boost1 1B.kicad_pcb, Housekeeping 1B.kicad_pcb, InputBuck 1B.kicad_pcb, SupercapHost 1B.kicad_pcb]
2025-05-28 Complete routing for current sense test board
    [CurrSense 1B.kicad_pcb, CurrSense 1B.kicad_sch, isense.kicad_sch]
2025-05-28 Add labels + more test points
    [CurrSense 1B.kicad_pcb, CurrSense 1B.kicad_sch]
2025-05-28 Adjust one pour
    [CurrSense 1B.kicad_pcb]
2025-05-28 Adjust all PCBs and resize boards to be cheaper to order from JLCPCB
    Also changed connector pinout to reflect silkscreen
    [Boost1 1B.kicad_pcb, Boost2 1B.kicad_pcb, CurrSense 1B.kicad_pcb, DevBoardInterface 1B.kicad_pcb, Housekeeping 1B.kicad_pcb, InputBuck 1B.kicad_pcb, SupercapHost 1B.kicad_pcb, SupercapManager.kicad_sch]
2025-05-29 Replace most banana jacks with XT connectors
    + update library
    [Boost1 1B.kicad_pcb, Boost1 1B.kicad_sch, Boost2 1B.kicad_pcb, Boost2 1B.kicad_sch, CurrSense 1B.kicad_pcb, CurrSense 1B.kicad_sch, DevBoardInterface 1B.kicad_pcb, DevBoardInterface 1B.kicad_sch]
2025-06-15 Update feedback to 100pF instead of 1000pF
    [CurrSense 1B.kicad_pcb, isense.kicad_sch]
2025-10-19 added test points to current sense PCB
    [CurrSense 1B.kicad_pcb, CurrSense 1B.kicad_sch]
